fgjg70/FPGA/fpga_pg2l100h/vision/SERVOS.md

# 七路舵机 PWM 与分拣接口

当前活动工程为 `build/dual_caps_sorter128_j11/pg2l100h_vision.pds`，LCD接J11，舵机信号使用J12。瓶盖模式中1号每5秒下料，2号绿色、3号黄色、4号红色，5～7号不自动启用。自动流程及摄像头启用条件见 [CAP_SORTING.md](CAP_SORTING.md)。下表中的球号按用户指定分配；J12脚号来自工程原有底板接线表。

| 舵机编号 | 用途 | FPGA球号 | 板上接线 | 顶层端口 | 脉宽寄存器 |
|---|---|---|---|---|---|
| 1 | 入口放行 | A20 | J12-12 | servo_pwm[0] | 0xA10000E0 |
| 2 | 绿色瓶盖舱门 | C19 | J12-10 | servo_pwm[1] | 0xA10000E4 |
| 3 | 黄色瓶盖舱门 | C18 | J12-8 | servo_pwm[2] | 0xA10000E8 |
| 4 | 红色瓶盖舱门 | A19 | J12-6 | servo_pwm[3] | 0xA10000EC |
| 5 | 盒子口分流 | D19 | J12-9 | servo_pwm[4] | 0xA10000F0 |
| 6 | 盒子口分流 | D18 | J12-7 | servo_pwm[5] | 0xA10000F4 |
| 7 | 盒子口分流 | B19 | J12-5 | servo_pwm[6] | 0xA10000F8 |

J12这些脚只接舵机SIG信号，FPGA输出LVCMOS33。舵机使用符合其型号额定电压的独立电源，电源容量按七个舵机的实际电流选择；电源负极、七个舵机GND和FPGA板GND共地。不得用GPIO或板端3.3 V给舵机供电。还需核对舵机信号输入能否接受3.3 V逻辑。

## 输出行为

`vision_servo_pwm.v`在50 MHz外设时钟下每50个周期产生一次微秒计时使能，不另生成时钟。七路共享20,000 μs周期，即50 Hz；每路独立设置1,000～2,000 μs高电平，分辨率1 μs。该范围作为当前校准起点，不代表已确定舵机机械角度；不同型号、安装方向和连杆机构的伸出/收回值需要实测。

复位后全部输出低，七路预设脉宽均为1,500 μs。写脉宽和开启通道在下一次20 ms周期开始时生效，当前脉冲保持原宽度。关闭通道立即在外设写入时拉低；同一周期重新开启也要等下一周期，避免产生第二段脉冲。PWM电平由寄存器驱动。切换识别模式、相机重配或停用NPU不会自动关闭已启用的PWM。

停止PWM只会停止发送控制信号，不能当作舵机已收回或入口已关闭。需要保持关闭位置时，应持续发送该舵机实测的关闭脉宽。

## 串口校准

使用现有115200、8N1串口，每条舵机命令以回车或换行结束：

| 命令示例 | 作用 |
|---|---|
| `s1=1500` | 设置1号为1,500 μs并启用 |
| `s2=1000` | 设置2号为1,000 μs并启用 |
| `s7=2000` | 设置7号为2,000 μs并启用 |
| `s2=0` | 关闭2号PWM |
| `s0=0` | 关闭全部七路PWM |
| `?` | 原状态输出增加PWM启用位图，十六进制显示，bit0～6对应1～7号 |

成功返回 `SERVO OK`，语法错误、编号越界或非零脉宽不在1,000～2,000范围时返回 `SERVO ERROR` 并保持原设置。命令中的数字不会作为手势期望数字处理。UART增加32字节接收队列；逐条发送并等待确认，避免在输入快照导出期间发送长串命令。

先使机构空载，逐个记录每路的入口关闭/放行或挡板收回/伸出脉宽，再连接实际分拣流程。1,500 μs只是预设值，不能直接作为所有机构的关闭位置。

## CPU寄存器

基址为0xA1000000，只接受32位对齐的完整四字节写，使用95 MHz CPU到50 MHz外设握手。

| 偏移 | 读写 | 内容 |
|---|---|---|
| D0 | R/W | 请求启用位图，低7位有效；bit0对应1号，bit6对应7号 |
| D4 | R | 固定周期20,000，单位μs |
| D8 | R | 当前周期的启用位图，可确认新开启是否已在周期边界生效 |
| E0、E4、E8、EC、F0、F4、F8 | R/W | 1～7号请求脉宽，单位μs；硬件将越界写入夹紧到1,000～2,000 |

设置时先写脉宽，再设置D0对应位。取消D0某一位可单独关闭；写D0=0关闭全部。七路同相输出；自动下料、开门和保持时间由 `firmware/sorter.h` 与主循环调度。

## 历史分拣流程待校准参数

早期版本仅实现PWM输出、CPU控制和串口调试；2026-11-04 已加入瓶盖定时下料，当前流程见 [CAP_SORTING.md](CAP_SORTING.md)。下列机械参数仍需要实测校准：

- 1～4号的实际机械动作方向、下料位置和舱门开合位置。
- 七个舵机的具体型号、各自两个动作位置的脉宽和动作完成时间。
- 履带速度、入口到各分流口的距离，或可提供到位事件的传感器。
- 单件放行的保持时间、物品间距及是否允许多件同时在履带上。

识别输出快照检测结果，没有物品到达传感器。当前自动流程按每次下料周期锁存颜色；下料后丢弃旧帧，下一周期重新确认，因此连续同色瓶盖也能分拣。舱门保持时间仍需按履带速度和距离校准。

## 验证命令

在工程根目录使用已有Python环境执行：

```powershell
python fpga_pg2l100h/vision/build.py --prepare-only
python fpga_pg2l100h/vision/verify.py --pds-home E:/pango/PDS_2022.2-SP6.1 --test verilog --test servo_pwm --test servo_mmio --test servo_command --test overlay --test cpu_mmio
```

仿真检查七路实际脉宽、20 ms周期、周期边界写入、运行中改宽度、关闭后重开、复位、MMIO地址隔离和UART队列。板上仍须用示波器或逻辑分析仪核对七个管脚，并逐路校准机械位置；生成工程或通过仿真均不代表已完成实板舵机测试。

## 2026-11-03 验证记录与整板时序限制

七路PWM、MMIO和UART队列、串口命令解析、原四框显示提交、125 MHz CPU外设访问及Verilog-2005编译共六项回归通过。PWM回归还检查了启用寄存器写入与脉冲下降沿重合的情况，确认写入不会延长其他通道的脉冲。

构建期间工作区CPU和构建脚本有并行改动，因此完整PDS验证使用了 `build/servo_review_20261103/` 下的源码快照。快照根目录的 `SOURCE_SNAPSHOT.json` 记录文件哈希；其中 `fpga_pg2l100h/vision/` 为独立工程，完整构建报告在该工程的 `build/j11/build_summary.json`，时序汇总在 `build/j11/place_route/top_pg2l100h_vision_timing_summary_after_hold_fix.txt`。

本次PDS完成综合、布局布线及位流生成，但整板时序未通过：50 MHz外设域建立时间WNS为+7.116 ns；125 MHz CPU域WNS为-0.551 ns、98个端点违例。详细报告中可见CPU数据存储器经LSU旁路、ALU到EX/MEM寄存器的违例路径，记录到-0.610 ns。该结果不满足当前125 MHz整板约束，构建脚本将本次完整构建标记为失败。

活动工程 `build/j11/` 已重新准备为修正后的PWM源码。其目录中可能保留先前位流，不能将旧位流当成本次PWM版本；本次尚无通过整板时序验收的可用位流，未下载板卡。应先完成CPU时序收敛，再重新构建并逐路校准实物舵机。

## 同日后续：CPU时序已收敛

后续CPU/NPU优化保留了上述七路PWM、MMIO和串口功能。CPU负载读数改为按访问宽度直接对齐，逻辑和算术右移共享移位器后，23:03完成的新整板构建已通过详细时序检查：125 MHz CPU域WNS为+0.302 ns，50 MHz域为+7.072 ns。当前源码的完整20项回归通过，包含此前六项舵机相关回归；最新位流与源码对应关系见 `build/j11/build_summary.json`，此前失败快照仍作为历史记录保留。工具时序通过不代表实物舵机脉宽、接线和机械位置已经验收。
