fgjg70/FPGA/fpga_pg2l100h/vision/build/dual_caps_sorter128_j11/multiseed_summary.csv

version,2022.2-SP6.1<build 138931>
project name,pg2l100h_vision.pds
Single Seed:
Seed,State,Convergence,Setup(Slow),Setup(Fast),Hold(Slow),Hold(Fast),Recovery(Slow),Recovery(Fast),Removal(Slow),Removal(Fast),PBM-GP,PBM-PreGP,PBM-PostGP,LP,Total Placement Cpu Time,Detailed routing,Total Routing Cpu Time,Wire Length After Post-GP,Wire Length After LP,Wire Length After DP,Routing Arc Length,Worst Slack After GP Timing,Worst Slack After LP Timing,Worst Slack Before RP,Worst Slack Before DP,Worst Slack After DP,Worst Slack After Placement,Worst Slack After TA By Preroute,TNS After DP,TNS Before Route,Setup(Slow) Total Failing TNS,Setup(Slow) Total Failing Endpoints,Hold(Slow) Total Failing THS,Hold(Slow) Total Failing Endpoints,Power
single,OK,OK,0.288,3.961,0.158,0.117,5.879,7.634,0.683,0.481,NA,NA,NA,5.52,248.19,669.16,897.03,NA,NA,NA,561789,NA,NA,-1116,-626,1052,1056,NA,0,0,0.000,0,0.000,0,1.522
Pass Rate/Convergence Rate,100.00%,100.00%
Synthesize:
control_set,299
Synthesize Performance Summary:
slack category,Synthesize Setup WNS,Synthesize Setup TNS,Synthesize Recovery WNS,Synthesize Recovery TNS
slack value,0.836,0.000,8.670,0.000
Synthesize Process Cpu Time,0h:5m:1s
Device Map:
Device Map Resource Usage Summary:
Logic Utilization,LUT,FF,DRM,APM,Distributed RAM,HSSTHP,USCM,HCKB,RCKB
Used,24271,19876,113.5,186,516,NA,3,0,0
Available,66600,133200,155,240,19900,NA,32,96,24
Utilization(%),37%,15%,74%,78%,3%,NA,10%,0%,0%
Device Map Process Cpu Time,0h:1m:3s
Project Configurations:
top module,top_pg2l100h_vision
compile," -compiler_directives {SYNTHESIS} "
synthesize," -ads "
device map,
place & route,
Test Parameters Configurations:
testparam,
