fgjg70/FPGA/fpga_pg2l100h/vision/build/dual_caps_sorter128_j11/wiring.csv

port | direction | ball | voltage | board_connector | board_pin | board_net | peripheral | peripheral_pin | signal
sys_clk | INPUT | R3 | 1.5 | CORE | 50MHz | SYS_CLK | BOARD |  | 50MHz oscillator
reset_n | INPUT | G25 | 3.3 | SW2 |  | RESET | BOARD |  | Reset active low
keys_n[0] | INPUT | K25 | 3.3 | SW4 |  | KEY1 | BOARD |  | KEY1 active low
keys_n[1] | INPUT | K26 | 3.3 | SW5 |  | KEY2 | BOARD |  | KEY2 active low
keys_n[2] | INPUT | P26 | 3.3 | SW6 |  | KEY3 | BOARD |  | KEY3 active low
keys_n[3] | INPUT | R26 | 3.3 | SW7 |  | KEY4 | BOARD |  | KEY4 active low
led[0] | OUTPUT | N23 | 3.3 | LED2 |  | LED1 | BOARD |  | LED1 active high
led[1] | OUTPUT | N24 | 3.3 | LED3 |  | LED2 | BOARD |  | LED2 active high
led[2] | OUTPUT | U26 | 3.3 | LED4 |  | LED3 | BOARD |  | LED3 active high
led[3] | OUTPUT | U25 | 3.3 | LED5 |  | LED4 | BOARD |  | LED4 active high
uart_txd | OUTPUT | L24 | 3.3 | J9 | 3-4 | UART_TX | BOARD |  | FPGA TX to CH340 RXD
uart_rxd | INPUT | L25 | 3.3 | J9 | 1-2 | UART_RX | BOARD |  | CH340 TXD to FPGA RX
lcd_r[0] | OUTPUT | AC26 | 3.3 | J11 | 3 | LCD_R0 | AN430 J3 | 3 | LCD_R0
lcd_r[1] | OUTPUT | AB26 | 3.3 | J11 | 4 | LCD_R1 | AN430 J3 | 4 | LCD_R1
lcd_r[2] | OUTPUT | Y26 | 3.3 | J11 | 5 | LCD_R2 | AN430 J3 | 5 | LCD_R2
lcd_r[3] | OUTPUT | W25 | 3.3 | J11 | 6 | LCD_R3 | AN430 J3 | 6 | LCD_R3
lcd_r[4] | OUTPUT | W23 | 3.3 | J11 | 7 | LCD_R4 | AN430 J3 | 7 | LCD_R4
lcd_r[5] | OUTPUT | V23 | 3.3 | J11 | 8 | LCD_R5 | AN430 J3 | 8 | LCD_R5
lcd_r[6] | OUTPUT | W26 | 3.3 | J11 | 9 | LCD_R6 | AN430 J3 | 9 | LCD_R6
lcd_r[7] | OUTPUT | V26 | 3.3 | J11 | 10 | LCD_R7 | AN430 J3 | 10 | LCD_R7
lcd_g[0] | OUTPUT | AC24 | 3.3 | J11 | 11 | LCD_G0 | AN430 J3 | 11 | LCD_G0
lcd_g[1] | OUTPUT | AB24 | 3.3 | J11 | 12 | LCD_G1 | AN430 J3 | 12 | LCD_G1
lcd_g[2] | OUTPUT | Y21 | 3.3 | J11 | 13 | LCD_G2 | AN430 J3 | 13 | LCD_G2
lcd_g[3] | OUTPUT | W21 | 3.3 | J11 | 14 | LCD_G3 | AN430 J3 | 14 | LCD_G3
lcd_g[4] | OUTPUT | T15 | 3.3 | J11 | 15 | LCD_G4 | AN430 J3 | 15 | LCD_G4
lcd_g[5] | OUTPUT | T14 | 3.3 | J11 | 16 | LCD_G5 | AN430 J3 | 16 | LCD_G5
lcd_g[6] | OUTPUT | Y20 | 3.3 | J11 | 17 | LCD_G6 | AN430 J3 | 17 | LCD_G6
lcd_g[7] | OUTPUT | W20 | 3.3 | J11 | 18 | LCD_G7 | AN430 J3 | 18 | LCD_G7
lcd_b[0] | OUTPUT | AB25 | 3.3 | J11 | 19 | LCD_B0 | AN430 J3 | 19 | LCD_B0
lcd_b[1] | OUTPUT | AA24 | 3.3 | J11 | 20 | LCD_B1 | AN430 J3 | 20 | LCD_B1
lcd_b[2] | OUTPUT | AA23 | 3.3 | J11 | 21 | LCD_B2 | AN430 J3 | 21 | LCD_B2
lcd_b[3] | OUTPUT | AA22 | 3.3 | J11 | 22 | LCD_B3 | AN430 J3 | 22 | LCD_B3
lcd_b[4] | OUTPUT | W19 | 3.3 | J11 | 23 | LCD_B4 | AN430 J3 | 23 | LCD_B4
lcd_b[5] | OUTPUT | V19 | 3.3 | J11 | 24 | LCD_B5 | AN430 J3 | 24 | LCD_B5
lcd_b[6] | OUTPUT | U16 | 3.3 | J11 | 25 | LCD_B6 | AN430 J3 | 25 | LCD_B6
lcd_b[7] | OUTPUT | U15 | 3.3 | J11 | 26 | LCD_B7 | AN430 J3 | 26 | LCD_B7
lcd_dclk | OUTPUT | V14 | 3.3 | J11 | 27 | LCD_DCLK | AN430 J3 | 27 | LCD_DCLK
lcd_hsync | OUTPUT | U14 | 3.3 | J11 | 28 | LCD_HSYNC | AN430 J3 | 28 | LCD_HSYNC
lcd_vsync | OUTPUT | U22 | 3.3 | J11 | 29 | LCD_VSYNC | AN430 J3 | 29 | LCD_VSYNC
lcd_de | OUTPUT | V22 | 3.3 | J11 | 30 | LCD_DE | AN430 J3 | 30 | LCD_DE
touch_sclk | OUTPUT | W24 | 3.3 | J11 | 31 | SPI_DCLK | AN430 J3 | 31 | SPI_DCLK
touch_cs_n | OUTPUT | V24 | 3.3 | J11 | 32 | SPI_CS | AN430 J3 | 32 | SPI_CS
touch_mosi | OUTPUT | N18 | 3.3 | J11 | 33 | SPI_DIN | AN430 J3 | 33 | SPI_DIN
touch_busy | INPUT | U24 | 3.3 | J11 | 34 | SPI_BUSY | AN430 J3 | 34 | SPI_BUSY
cam_scl | OUTPUT | W18 | 3.3 | J7 | 3 | CMOS_VSYNC | OV7670 DVP18 | 3 | SCL
cam_sda | INOUT | Y23 | 3.3 | J7 | 4 | CMOS_SCL | OV7670 DVP18 | 4 | SDA
cam_vsync | INPUT | V16 | 3.3 | J7 | 5 | CMOS_HREF | OV7670 DVP18 | 5 | VS
cam_href | INPUT | V18 | 3.3 | J7 | 6 | CMOS_SDA | OV7670 DVP18 | 6 | HS
cam_pclk | INPUT | V17 | 3.3 | J7 | 7 | CMOS_RESET | OV7670 DVP18 | 7 | PCLK
cam_xclk | OUTPUT | T17 | 3.3 | J7 | 8 | CMOS_D0 | OV7670 DVP18 | 8 | MCLK
cam_reset_n | OUTPUT | AA25 | 3.3 | J7 | 17 | CMOS_XCLK | OV7670 DVP18 | 17 | RESET
cam_pwdn | OUTPUT | Y25 | 3.3 | J7 | 18 | CMOS_PWDN | OV7670 DVP18 | 18 | PWDN
cam_data[0] | INPUT | Y22 | 3.3 | J7 | 16 | CMOS_PCLK | OV7670 DVP18 | 16 | D0
cam_data[1] | INPUT | U21 | 3.3 | J7 | 15 | CMOS_D7 | OV7670 DVP18 | 15 | D1
cam_data[2] | INPUT | T20 | 3.3 | J7 | 14 | CMOS_D6 | OV7670 DVP18 | 14 | D2
cam_data[3] | INPUT | V21 | 3.3 | J7 | 13 | CMOS_D5 | OV7670 DVP18 | 13 | D3
cam_data[4] | INPUT | U20 | 3.3 | J7 | 12 | CMOS_D4 | OV7670 DVP18 | 12 | D4
cam_data[5] | INPUT | T19 | 3.3 | J7 | 11 | CMOS_D3 | OV7670 DVP18 | 11 | D5
cam_data[6] | INPUT | T18 | 3.3 | J7 | 10 | CMOS_D2 | OV7670 DVP18 | 10 | D6
cam_data[7] | INPUT | U19 | 3.3 | J7 | 9 | CMOS_D1 | OV7670 DVP18 | 9 | D7
servo_pwm[0] | OUTPUT | A20 | 3.3 | J12 | 12 | LCD_G1 | SERVO 1 | SIG | Entrance gate
servo_pwm[1] | OUTPUT | C19 | 3.3 | J12 | 10 | LCD_R7 | SERVO 2 | SIG | Box diverter
servo_pwm[2] | OUTPUT | C18 | 3.3 | J12 | 8 | LCD_R5 | SERVO 3 | SIG | Box diverter
servo_pwm[3] | OUTPUT | A19 | 3.3 | J12 | 6 | LCD_R3 | SERVO 4 | SIG | Box diverter
servo_pwm[4] | OUTPUT | D19 | 3.3 | J12 | 9 | LCD_R6 | SERVO 5 | SIG | Box diverter
servo_pwm[5] | OUTPUT | D18 | 3.3 | J12 | 7 | LCD_R4 | SERVO 6 | SIG | Box diverter
servo_pwm[6] | OUTPUT | B19 | 3.3 | J12 | 5 | LCD_R2 | SERVO 7 | SIG | Box diverter
