fgjg70/FPGA/fpga_pg2l100h/vision/build/dual_caps_sorter128_j11/place_route/top_pg2l100h_vision_timing_summary_after_hold_fix.txt

Design Summary : All Constraints Met.

Setup Summary(Slow Corner):
****************************************************************************************************
                                                                          TNS Failing      TNS Total
 Launch Clock           Capture Clock              WNS(ns)     TNS(ns)      Endpoints      Endpoints
----------------------------------------------------------------------------------------------------
 clk50                  clk50                        4.781       0.000              0          76427
 cpu95                  clk50                       17.924       0.000              0             68
 clk27                  clk27                       16.136       0.000              0           2592
 clk50                  clk27                       17.732       0.000              0            377
 clk27                  lcd_pixel                   20.836       0.000              0             27
 cpu95                  cpu95                        0.393       0.000              0          14450
 clk50                  cpu95                        9.096       0.000              0             32
====================================================================================================

Hold Summary(Slow Corner):
****************************************************************************************************
                                                                          THS Failing      THS Total
 Launch Clock           Capture Clock              WHS(ns)     THS(ns)      Endpoints      Endpoints
----------------------------------------------------------------------------------------------------
 clk50                  clk50                        0.159       0.000              0          76427
 clk27                  clk27                        0.252       0.000              0           2592
 clk27                  lcd_pixel                    1.286       0.000              0             27
 cpu95                  cpu95                        0.308       0.000              0          14450
====================================================================================================

Recovery Summary(Slow Corner):
****************************************************************************************************
                                                                          TNS Failing      TNS Total
 Launch Clock           Capture Clock              WNS(ns)     TNS(ns)      Endpoints      Endpoints
----------------------------------------------------------------------------------------------------
 clk50                  clk50                       14.965       0.000              0            104
 cpu95                  cpu95                        5.923       0.000              0           1506
====================================================================================================

Removal Summary(Slow Corner):
****************************************************************************************************
                                                                          THS Failing      THS Total
 Launch Clock           Capture Clock              WHS(ns)     THS(ns)      Endpoints      Endpoints
----------------------------------------------------------------------------------------------------
 clk50                  clk50                        1.207       0.000              0            104
 cpu95                  cpu95                        0.679       0.000              0           1506
====================================================================================================

Minimum Pulse Width Summary(Slow Corner):
****************************************************************************************************
                                                                         WPWS Failing     WPWS Total
 Clock                                            WPWS(ns)    TPWS(ns)      Endpoints      Endpoints
----------------------------------------------------------------------------------------------------
====================================================================================================

Setup Summary(Fast Corner):
****************************************************************************************************
                                                                          TNS Failing      TNS Total
 Launch Clock           Capture Clock              WNS(ns)     TNS(ns)      Endpoints      Endpoints
----------------------------------------------------------------------------------------------------
 clk50                  clk50                        9.978       0.000              0          76427
 cpu95                  clk50                       18.808       0.000              0             68
 clk27                  clk27                       17.070       0.000              0           2592
 clk50                  clk27                       18.580       0.000              0            377
 clk27                  lcd_pixel                   23.432       0.000              0             27
 cpu95                  cpu95                        3.969       0.000              0          14450
 clk50                  cpu95                        9.705       0.000              0             32
====================================================================================================

Hold Summary(Fast Corner):
****************************************************************************************************
                                                                          THS Failing      THS Total
 Launch Clock           Capture Clock              WHS(ns)     THS(ns)      Endpoints      Endpoints
----------------------------------------------------------------------------------------------------
 clk50                  clk50                        0.116       0.000              0          76427
 clk27                  clk27                        0.167       0.000              0           2592
 clk27                  lcd_pixel                    1.940       0.000              0             27
 cpu95                  cpu95                        0.218       0.000              0          14450
====================================================================================================

Recovery Summary(Fast Corner):
****************************************************************************************************
                                                                          TNS Failing      TNS Total
 Launch Clock           Capture Clock              WNS(ns)     TNS(ns)      Endpoints      Endpoints
----------------------------------------------------------------------------------------------------
 clk50                  clk50                       16.827       0.000              0            104
 cpu95                  cpu95                        7.642       0.000              0           1506
====================================================================================================

Removal Summary(Fast Corner):
****************************************************************************************************
                                                                          THS Failing      THS Total
 Launch Clock           Capture Clock              WHS(ns)     THS(ns)      Endpoints      Endpoints
----------------------------------------------------------------------------------------------------
 clk50                  clk50                        0.852       0.000              0            104
 cpu95                  cpu95                        0.481       0.000              0           1506
====================================================================================================

Minimum Pulse Width Summary(Fast Corner):
****************************************************************************************************
                                                                         WPWS Failing     WPWS Total
 Clock                                            WPWS(ns)    TPWS(ns)      Endpoints      Endpoints
----------------------------------------------------------------------------------------------------
====================================================================================================
