fgjg70/FPGA/(commit log)

2026-09-26 feat: RV32I 五级流水线处理器核心
    从 legacy/ 下的 Verilog 单周期实现重写为 SystemVerilog 五级流水线
    (IF/ID/EX/MEM/WB)，含冒险处理与非对齐访存硬件自动拆分。
    194 项单元检查 + 6 组系统级测试全部通过 (sim/run.bat)。
    基础模块:
    rv32_pkg.sv 编码包(单一事实来源): 指令/ALU/分支/访存编码、控制束、
    地址映射、前递枚举、数据通路契约
    alu / branch_unit / control_unit / imm_gen / pc / regfile
    流水线模块:
    if_id_reg / id_ex_reg / ex_mem_reg / mem_wb_reg 控制束整束传递
    hazard_unit 前递选择 + load-use 停顿 + 重定向门控
    load_store_unit 字节通道 + 非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
2026-10-05 feat: RV32IM 五级流水线 CPU — 分支预测 / M 扩展 / BRAM + 上板跑分基础设施
    微架构 (三项评分指标逐轮量化, 见 results/coremark.csv):
    - 分支预测: 64 项 BTB + 2 位 Smith 方向预测器, IF 预测 / EX 校验。
    redirect 语义重定义为"预测错误"(而非"分支 taken"); 精度 89%, 条件分支误判率 8.6%
    - RV32M: muldiv.sv。乘法乘积寄存进 DSP(MREG/PREG) 换回 fmax (74.6MHz, 只让 2.2% CoreMark);
    除法 32 步恢复余数, busy 必须覆盖启动拍与单周期除零/溢出特例
    - BRAM: dmem 改寄存读, 字节提取挪到 WB 拍吸收延迟 (零性能损失),
    纯行为级推断不例化任何厂商 IP; LUT 4494 -> 2481 (-45%), C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
    [coremark.csv]
2026-10-05 feat: 上板 CoreMark 实测通过 + 异常/中断基础 (CSR)
    上板验证 (赛题硬性要求, 见 results/hw-verified.md):
    - 达芬奇Pro XC7A100T-2 @50MHz, CoreMark v1.0 x 1200 迭代 = 10.16 秒 (>= 10s)
    - CRC 判定位 = 1: crclist/crcmatrix/crcstate 全部匹配官方参考值
    - CoreMark/MHz 硬件实测 2.3615 vs 仿真 2.3611 (吻合 0.02%)
    - 流水线效率波形已抓: 2048 拍窗口 stall 8.8% / redirect 1.07% (分析报告用)
    异常/中断 (赛题高阶任务):
    - csr_file.sv: M-mode 全套 CSR + 进陷阱/MRET 状态机。
    mepc 取 trap_pc 本身不 +4 —— 异常与中断都在 EX 段、指令提交前裁决,
    被抢占的指令必须重新执行, 两种情况语义统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
    [coremark.csv, ila_done.csv, ila_pipeline.csv]
2026-10-05 docs: 新增 HANDOFF.md 交接文档 (供全新会话接手)
    内容: 项目定位 / 当前实测成果 / 环境事实 (环境剥离+纯ASCII规则) / 代码结构 /
    已完成工作 / 待办 P0-P6 (含异常中断 core 接线的完整设计) / 命令配方 /
    高频坑清单 / 关键设计决策与理由 / 文档索引 / 建议接手顺序 / 迭代轨迹
2026-10-05 docs: 新增 HANDOFF-HW-LOOP.md — 上板闭环测试能力说明
    HANDOFF.md 的 P4 把上板复验写成了「待用户操作」, 但硬件闭环其实完全自动化:
    JTAG 烧录 + ILA 读回, 不需要人看 LED, 也不需要串口。
    内容: 三条通道可用性 / 一条命令跑完 / ILA 版必须与 RTL 同步 /
    完整闭环工作流 / 给新测试加闭环的三步模式 / 上板踩的 7 个坑 / 当前硬件真实状态
    另记录了 results/coremark.csv 里 LUT=2481 与当前 3923 的差异原因:
    CSR 接线给 ctrl_s 加了 5 个字段, 控制束变宽; 旧行是当时代码的实测值, 不该改。
2026-10-05 docs: 新增 HANDOFF-WORKFLOW.md — 优化循环说明 + 集成建议
    写给接手 AI: 说明我 10 轮迭代实际用的优化循环, 并建议如何固化成 skill/子命令。
    内容:
    - 循环形状: 选靶子->量现状->改一处->仿真->重综合->判定->沉淀
    - 各步真实命令 (含剖析用的层次化引用计数器)
    - 判定环节: 三项指标 + 绝对吞吐, 附三项互相冲突的真实案例表
    - 判据清单: 每环节的通过标准与可疑信号 (完全一致 = 先怀疑没生效)
    - 建议新增三个子命令: metrics / profile / hw --stale|--capture|--rebuild
    - 建议新增动作型 skill: 一个优化回合的 9 步 + 5 条硬规则
    - 可复用模式 7 条; 补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
2026-10-05 feat: 工具化工作流 + P0 评分版重建 + P1 异常/中断接入 core
    工具层 (tools/fpga_workflow.py, 见 tools/README.md):
    - check: R1 漂移检测 —— 三处 RTL 清单同步 / 未接线模块 / 镜像新鲜度 /
    bitstream 新鲜度 / tohost 地址 / .bat·.tcl 纯 ASCII
    - verify: ModelSim 增量回归, 内容哈希缓存; 判定依据是 tb 打印的
    "RESULT : PASS" 而非 vsim 退出码 (quit -f 无论成败都返回 0)
    - synth: Vivado 综合 -> 四项指标; 全局构建锁串行化 + 报告归档
    - report: 三项指标 + 绝对吞吐
    P0 评分版重建 (fpga/build.tcl):
    - 补 DMEM_INIT_FILE (哈佛结构缺它会静默让 .data/.rodata 全 0)
    - 程序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
    [coremark.csv]
2026-10-05 perf: P3 fmax 还债 实验A — 跳转目标专用加法器 (61.4 -> 64.4 MHz)
    改动 (core.sv):
    - 把 BR/JAL/JALR 的跳转目标从"穿 ALU 操作数 mux"改成独立加法器
    原写法取 alu 的 ex_sum, 已绕过结果 mux, 但 ex_a 的 3:1 与 ex_b 的 2:1
    操作数 mux 仍在路径上。BR/JAL/JALR 的 alu_op 恒为 ADD、操作数确定
    (pc+imm 或 rs1+imm), 因此给它们只有 1 级 mux 的专用加法器, 零周期代价。
    实测 (synth --prog cm_hw --tag p3a-jalr-addder):
    CoreMark/MHz 2.3614 -> 2.3614 (ticks 完全相同 423,486, 确认零周期代价)
    fmax 61.4 -> 64.4 MHz (+4.9%)
    CoreMark/LUTs 6.019e-4 -> 5.986e-4 (-0.6%)
    绝对吞吐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
    [coremark.csv]
2026-10-05 docs: 修正 gap-analysis 过时标注 + HANDOFF 记录 P3 进展与盈亏平衡账
    gap-analysis.md 是赛题对照表, 原先有多处自相矛盾:
    - 「完整异常/中断」仍标为 ❌ 完全缺失 -> 改为 ✅ 已完成 (P1 已接入 core, 7 PASS)
    - 「运行 >=10 秒」标为待确认 -> 已上板实测 10.16 s
    - 评分三项数字更新为 report 重算的可复现口径 (fmax 64.4 / LUT 3945)
    - 补充: 异常/中断只差 P2 定时器中断 (irq_timer 仍硬接 1'b0, csr_file 侧已就绪)
    - 优先级表重排, 附工作流命令清单
    HANDOFF.md:
    - P3 标记为「进行中, 实验A 已挣回 +4.9%, 本轮暂停」并写入盈亏平衡账
    (load-use 时间代价 6.14% -> 方案1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
2026-10-05 perf: P3 实验B — 取指存储器改寄存读进 BRAM (LUT 3945 -> 2656, -32.7%)
    起因: imem 原来既不是 BRAM 也不是 LUTRAM, 而是被综合成 1228 个纯 LUT 的
    组合 ROM (占全核 3945 LUT 的 31%)。普通 report_utilization 看不出来 ——
    imem 在 Block RAM 表与 Distributed RAM 表里都不出现, 必须按层次看。
    改动:
    - imem.sv: 加 clk 端口 + IMEM_REG_READ 宏 (定义=寄存读/可进 BRAM, 不定义=组合读)
    - core.sv: u_imem 接上 .clk
    - fpga/build.tcl: 默认定义 IMEM_REG_READ=1; set IMEM_COMB_READ=1 可回退
    - tools: synth/verify 增加 --imem-comb-read 回退开关; 新增 tools/hier_util.tcl
    实测 (vs 实验A 3945/64.4):
    CoreMark/MHz 2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
    [coremark.csv]
2026-10-05 perf: P3 实验C — load 结果改由 MEM/WB 寄存器给出 (fmax 65.3 -> 75.0, +14.8%)
    靶子: 实验B 之后关键路径为
    u_dmem/mem_reg_2/CLKBWRCLK -> u_id_ex/rs2_data_reg[2]/D, 15.216ns, route 63.9%
    根因 (core.sv):
    mem_wb_reg 的 load_data_in 原本硬接 32'h0, load 结果直接从 LSU 的
    **组合输出**进 wb_data mux -> 前递 mux -> ID/EX —— 同一时钟沿上"组合读出的
    数据"既要被 MEM/WB 锁存、又要穿过 mux 去前递/写回, 两跳压在一拍。
    改动 (不新增任何寄存器, 用的就是本来就存在的 mem_wb_reg):
    - `ifdef LOAD_RESULT_REG: .load_data_in(mem_load_data);
    WB_MEM: wb_data = mem_wb_load_data; // 从前递寄存器取,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
    [coremark.csv]
2026-10-05 fix(tools): metrics 改用仿真日志的 ticks 真值, 而非 CSV 历史值
    实测发现口径不一致: CSV 记录 ticks=423,486, 而干净的仿真日志是 423,527。
    两者 CoreMark/MHz 差 0.01% (2.3614 vs 2.3611), 看似无所谓, 但'用旧值算新架
    的指标'是错的口径 —— 改 RTL 后 ticks 可能已变, 或本就该重测。
    - latest_ticks(): 优先读 .fpga-cache/logs/tb_sw_coremark.log 里的 CoreMark
    ticks (还能顺带拿到 CRC 做正确性校验), 没有才回退 CSV
    - report: 表内数据仍为 CSV 记录值 (那一次构建的实测), 但补一行提示说明
    它不等于'此刻'的指标, 要看此刻请用 metrics
    实测: metrics 现在给出 coremark_per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
2026-10-05 feat(P2): 定时器中断 (mtime/mtimecmp -> mip.MTIP) —— 补齐"完整异常/中断"
    - fpga/mmio_subsys.sv: 64 位 mtimecmp (复位全 1, 上电不立刻中断); mtime 复用
    已有周期计数器 (保证 MMIO_MTIME_* 与 MMIO_CYCLE_* 读数一致);
    irq_timer = (mtime >= mtimecmp) 电平输出
    - core.sv: 新增 irq_timer 端口 -> csr_file.irq_timer, 不再硬接 1'b0
    - top_a100t.sv / tb_soc.sv / tb_sw.sv 接线 (tb_core 保持恒 0: 它不接外设)
    - 新测试 sim/prog/timer_irq.S + 测试矩阵 tb_soc_timer_irq, 覆盖: 中断触发 /
    mcause 判定 / handler 推进 mtimecmp 清电平 / mret 返回 / handler 用 mscratch
    保存恢复现场 / 中断之后 UART+GPIO 仍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
    [coremark.csv]
2026-10-05 docs: gap-analysis 同步 P2 完成状态 ('完整异常/中断'已无缺口) + 实测数字
    - 「完整异常/中断」补上 P2 定时器中断, 移除'只差定时器中断'的待办说明
    - 评分三项与资源更新为 p2-timer-irq 的可复现口径 (LUT 2526 / fmax 70.9)
    - fmax 还债全程表 (61.4 -> 75.0 -> 70.9), 标明 P2 是'用频率换功能'
    - 优先级重排: 上板复跑成唯一阻塞项; 新增按层次查资源的工具用法
    - 回归基线 7 PASS -> 8 PASS
2026-10-05 feat: 上板闭环验证通过 (含 P1+P2+P3) + hw 子命令 + 修两个 ILA 抓取坑
    ## 上板验证结果 (2026-10-05 16:43, 真实板卡)
    ila_ctrl = 0x42 -> done=1 pass=1 fail=0 illegal=0
    score_result = 0x9E49D60C
    bit31 = 1 -> CRC 全部匹配 CoreMark 官方参考值
    tick = 508,155,404 (预期 508,232,400, 偏差 0.015%)
    时长 = 10.16 s (赛题 >=10s 满足)
    CoreMark/MHz = 2.3615 (仿真 2.3611, 吻合 0.02%)
    **tick 与 P1 之前逐位相同** —— P1/P2/P3 都不改变指令数与周期数 (P3 是纯时序优化,
    P1/P2 的陷阱逻辑不在热路径), 硬件上逐位复现, 证明仿真与硬件在三次结构性改动后仍一致。
    流水线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
    [coremark.csv, ila_pipeline.csv]
2026-10-05 docs: gap-analysis 标记上板闭环已完成 (含 P1+P2+P3 的 bitstream 已验证)
2026-10-05 fix(tools): hw --record 的 notes 写对 (原为 PROG=?); 修正 HW 行的 notes
    - append_csv 现在优先用调用方给的 note, 没有再退回 synth 的默认文案
    - hw 子命令传入'上板实测 (ILA over JTAG): N 迭代, X.XXs, CRC 判定=D'
    - 修正 results/coremark.csv 里 HW-P2P3-verified 那行的 notes
    [coremark.csv]
2026-10-05 fix(csv): 从 git 恢复被 BOM 破坏的 coremark.csv, 改用 csv 模块重写
    事故链 (两步都踩了):
    1. 用 PowerShell `Set-Content -Encoding UTF8` 改 coremark.csv 里一行 notes ——
    PowerShell 5.x 的 `-Encoding UTF8` **会写入 BOM**, 于是首列列名变成
    "\ufeffdate", 所有按列名索引的解析全部失配 -> report 里数字全变成 "-",
    而文件"看起来是正常的"。
    2. 又用 split("\n") 处理 CRLF 文件重写, 首个注释行与下一行被粘在一起,
    并多出杂引号。
    修法: 从 git 恢复完好版本, 只改 HW 那一行的 notes, 且改用 csv 模块读写
    (不再手拼逗号、不再手工切行)。
    复核: 12 列 / 20 数据行 /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
    [coremark.csv]
2026-10-05 docs: 新增分析报告 (results/analysis-report.md) + 修正 link.ld 顶部与实现不符的注释
    analysis-report.md 覆盖赛题要求的分析报告维度:
    - 体系结构: 流水线组织/8 项关键设计决策/分支预测/异常中断
    - 验证方法: 8 项回归 + CoreMark CRC 证据 + 上板无人值守闭环
    - 实现与工具链: 规模 (19 文件 2164 行) / 关键路径分析 (route 占 73.3%) / 哈佛双镜像约束
    - 优化过程: 逐轮指标表 + 三个关键优化原理 + 失败与弯路 (含缩容负收益、stub 实验失效)
    - 上板实测: 跑分结果 + 2048 拍流水线波形分析 + 停顿构成
    - 结论: 已达成/未完成/后续方向 + 附录复现命令
    link.ld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
2026-10-05 chore: 收尾 — 镜像哈希基线自动化 + bitstream 重建 + PITFALLS R14/R15
    ## 排查过程 (结论: 原以为是静默失败, 实测正常)
    发现 cm_hw(ITER=1200)/cm_it3(ITER=3)/cm_rv32im(ITER=1) 三个 imem 镜像
    **逐字节相同**, 一度认为是 "-D ITERATIONS 没生效" 这个经典静默失败。
    实测结论: **是正常的**。CoreMark 把迭代数放在**可写数据变量**里, 所以改
    ITERATIONS **只改数据段** —— 两个构建的 .hex 相同、.dmem.hex 不同。
    并已验证仓库现有 cm_hw.hex + cm_hw.dmem.hex **完全等于**重建的 ITERATIONS=1200。
    排查过程中还踩到一个真坑 (R15): 在 PowerShell 里敲
    -D 'FLAGS_STR="-Os -march=rv32i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
    [coremark.csv]
2026-10-05 fix(tools): 宏从未在仿真生效 —— 重大静默失败, P3 两个"零代价优化"作废
    ## 事故
    `tools/fpga_workflow.py` 的 compile_sim 写的是:
    flags = ["+" + d for d in defines] # -> vlog -sv +IMEM_REG_READ ...
    `vlog` 把 `+FOO` 当未知选项, **宏根本不会被定义, 而编译仍"成功"**。
    最小复现:
    vlog -sv +FOO -> FOO_NOT_DEFINED
    vlog -sv +define+FOO -> FOO_DEFINED
    后果: 综合侧走 Tcl 的 -verilog_define (**生效**), 仿真侧没生效 ->
    **"综合开了宏、仿真没开宏", 两边跑的不是同一份设计**。
    于是 results/p3-imem.md 与 p3-load-result.md 里
    "CoreMark/MHz 逐位不变、零代价"是**无效证据** —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
    [coremark.csv]
2026-10-05 feat(diag): 微架构优化测量 — 误判分类探针 + gshare + 定位 imem 寄存器读错位根因
    ## 诊断设施 (本轮的主要可复用产出)
    tb_sw.sv 新增**分类型预测错误统计**, 并用层次化引用直读 BTB 阵列 (纯观测, 不改 RTL):
    cond branch = 6055 (52%) JAL = 1102 (9%) JALR = 4378 (37%)
    条件分支: BTB 有表项 67457 (96%), 无表项 2678 (3%)
    误判细分: 无表项(容量/冲突) 1185 (19%), **有表项但方向判反 4870 (80%)**
    => **推翻了 btb.sv 自己的注释**("64 项冲突是 8.6% 误判率的主因")。
    96% 的分支在表里, 80% 的误判是方向判错 -> 该改方向预测器, 不是扩表。
    (PITFALLS R16)
    ## gshare 方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
2026-10-05 chore: 重建 bitstream (core.sv 改动后) + 记录真实基线 p4-final-default
    core.sv 的取指相位对齐改动 (IMEM_REG_READ 门控) 在默认组合读模式下是
    `wire pc_if = pc` 的直通, 属零代价; 综合结果验证了这一点:
    LUT 4019 -> 4015, fmax 61.6 -> 61.3MHz (摆位布线噪声级), CM/MHz 不变
    最终状态 (三宏全关 = 上板验证过的配置):
    CoreMark/MHz 2.3611 (ticks 423,527)
    fmax 61.3 MHz
    LUT/FF/BRAM/DSP 4015/1381/4/8
    CoreMark/LUTs 5.881e-04
    绝对吞吐 144.7
    验证:
    check 通过 (0 个必须修)
    verify 8 PASS (默认配置)
    上板 PASS —— ila_ctrl=0x42, CRC 判定=1, tick=508,155,404, 10.16s
    (tic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
    [coremark.csv]
2026-10-05 fix(fetch): 取指对齐自检 + IMEM_REG_READ 彻底定位 (需重排取指流水, 拦在构建期)
    ## 取指对齐自检 (新增, 长期保留)
    tb_sw.sv 增加 [ALIGN] 断言: mem[if_pc] 必须等于 if_instr。把"静默错位"
    这类 bug 变成一行直接报错, 不必再人肉 trace。
    踩了两个坑并写进注释:
    1) 索引位宽要用 imem 真实的 AW 位宽 (16KB -> if_pc[13:2]), 不能随便切
    2) flush 那一拍 if_id 里留的是旧值且 pc 被清成 0, 必须跳过 (用 if_pc!=0 判废)
    3) 启动窗口前 4 拍要跳过 (imem 的 initial 先填 NOP, $readmemh 随后才覆盖)
    实测: 正确配置报 "OK (0 次错位)", 错位配置能抓到。
    ## IMEM_REG_READ 根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
2026-10-05 feat(predict): 返回地址栈 RAS (机制有效, 综合指标净亏 -> 默认关闭)
    ## 选择依据 (先测量再动手)
    把预测错误按类型拆开: cond branch 6055 (52%) / JAL 1102 (9%) / **JALR 4378 (37%)**。
    JALR 绝大多数是函数返回, 而 BTB 只记得住"上一次"的返回地址 -> RAS 的靶子。
    ## 实现
    - ras.sv: 8 项 x 32 位 + 指针, 饱和不回绕 (回绕会让栈顶指向错误地址, 比不预测更糟)
    - btb.sv: 增加 is_ret 标记 + pred_is_ret 输出
    - core.sv: EX 段识别 call(JAL/JALR 且 rd=x1/x5) 与 return(JALR rd=x0 且 rs1=x1/x5),
    只在 EX 更新 (不做投机压栈, 避免冲刷后栈变脏)
    关键设计: **前端 IF 段无法识别返回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
    [coremark.csv]
2026-10-05 docs(predict): gshare 两个变体都实测 —— 都输给纯局部 Smith, 明确 reject
    ## 结论 (results/p4-gshare.md)
    Smith (默认) ticks 423527 误判 11535 精度 89% <- 基准
    gshare 历史记全部控制流 ticks 449317 误判 25954 精度 75% 慢 6%
    gshare 历史只记条件分支 ticks 451265 误判 26547 精度 74% 更差
    两个变体都输。变体 B (只记条件分支) 的动机听起来合理 (JAL/JALR 方向恒为
    taken, 记进历史只注入常量噪声), 但实测精度从 89% 崩到 74% —— 真因是
    **冷却效应**: 6 位历史做 XOR 索引意味着同一分支在不同历史下落到 2^6=64 个
    不同计数器上, 每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
    [coremark.csv]
2026-10-05 docs(handoff): 记录 P4 轮结论 (RAS/gshare/取指错位) + 给 P3 节加作废标记
    - 新增 P4 节: 当前真实状态 (四宏全关, 上板已验证) + 本轮三个'实测否决'结论
    + 留下的可复用设施 (取指对齐自检 / 分类型误判统计 / 宏自证)
    + 下一步按收益排序 (重做取指流水是最大一块)
    - P3 节标题加删除线 + 作废横幅: imem 寄存读与 load 结果寄存器的'零代价'
    是无效证据 (宏在仿真里从未生效), 两者单独开启都会 timeout
    - 原'上板复跑'小节改名 P4-old 作为历史
2026-10-05 fix(fetch): IMEM_REG_READ 四轮尝试后定论 —— 需模块级取指重排, 当前不做
    ## 四轮尝试 (都失败, 但把"为什么补丁补不上"钉死了)
    ① 只延迟进 if_id 的 PC -> [ALIGN] 对齐自检已 0 次错位, 但 tb_core_basic 第2组仍挂
    ② 再延迟预测 (用延迟后的 PC 查表) -> 同上; 预测与指令的 PC 仍差一拍
    ③ 再加 stall 门控 -> 同上
    ④ 让延迟副本照抄 pc 的"下一拍值" -> 需要把 pc.sv 的 flush/stall 优先级复制到
    以同步重定向跳变 第二个寄存器, 等价于把 PC 改成两级结构 = 模块级重构
    trace 证据: 0x80000048 的 "j ." 被解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
    [coremark.csv]
2026-10-05 docs(gap): gap-analysis 同步到修正后的真实指标 + 标注作废项
    - 评分三项改为四宏全关的真实口径 (fmax 61.6 / LUT 4019 / CM-LUTs 5.875e-4 / 吞吐 145.4)
    - fmax 还债表改为'只列有效项': 实验 B/C 标注作废 (功能不正确), 只留实验 A
    - 分析报告标记为已完成 (results/analysis-report.md)
    - 模块数 19 -> 20 (新增 ras.sv)
    - 优先级重排: Cache 是当前最高价值的功能缺口, 取指流水重排排在其后
2026-10-05 feat(app): 应用场景基线 (神经网络 GEMM 核心) + 定位一个编译器代码生成 bug
    ## 应用场景 (赛题"应用场景构建" + "AI 模型性能"两项的落点)
    新增 sw/nn_demo.c: 用 GEMM 搭一个小型神经网络推理核心, 作为"加速前软件基线"。
    选它的理由: (a) GEMM 是神经网络推理里占比绝对主导的算子 (b) 结果可逐元素校验
    (c) 有明确的"软件 vs 加速"对比基准。
    - 16x16 三重矩阵乘, 4096 MAC, 结果与**独立参考实现**逐元素比对
    - 新增测试 tb_sw_nn_demo (回归 8 -> 9 项)
    - 基线实测 (-O0, 结果正确):
    gemm_cycles=196264 macs=4096 cycles_per_mac=47.91
    checksum == checksum_ref == 0x9d5d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
2026-10-05 docs(ai): GEMM 加速单元完整设计方案 + 应用场景基线结论
    results/p5-ai-accelerator.md:
    - 应用场景已落地: sw/nn_demo.c 用 GEMM 搭神经网络推理核心; 基线实测
    gemm_cycles=196264 / macs=4096 / cycles_per_mac=47.91 /
    checksum == checksum_ref == 0x9d5de1c5 (与主机端独立计算一致) / mismatch=0
    - 硬件加速单元设计: 完整 MMIO 寄存器表 + 运算语义 + 正确性验证方式
    - **阻塞点分析**: 本核 dmem 单读口且被 LSU 独占 -> 加速单元直接访存会争用,
    且单口限制使每拍只能取一个操作数, 并行度上不去。给出三条路线对比:
    A 本地缓冲(推荐, 零访存冲突/自包含/可独立验证) / B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
2026-10-05 docs(gap): 应用场景标记为已完成, AI 模型性能标记为基线已量化
    - 应用场景构建: ✅ 已完成 (sw/nn_demo.c, 与独立参考实现逐元素一致, mismatch=0)
    - AI 模型性能: ⏳ 基线已量化 (196264 周期 / 47.91 周期每 MAC), 硬件加速单元待实现
    - 优先级: GEMM 加速单元提升为当前最高价值项; 回归 8 -> 9 PASS
2026-10-05 feat(ai): GEMM 加速单元集成到 SoC (部分工作: 结果仍有 125/256 元素不对)
    ## 已完成并验证的部分
    - rv32_pkg.sv: 新增 MMIO_GEMM_* (CTRL/STATUS/M/K/N/CYCLES + 2KB 缓冲窗口)
    - gemm_accel.sv: int8 矩阵乘加单元, 本地缓冲方案 (A/B/C 片上, CPU 用 MMIO 搬运)
    * 1 MAC/拍的正确性优先版本; 不用 DSP (int8 乘法器小, 落 LUT 即可)
    * 参数合法性检查 (m*k / k*n / m*n 都受缓冲容量约束, 越界直接拒绝启动)
    - mmio_subsys.sv: 地址译码 + 例化 (2KB 对齐窗口用 addr[31:11] 比较)
    - 构建清单: build.tcl / build_ila.tcl / tools/fpga_workflow.py / tools/run_coremark.py
    - sw/nn_demo.c: 加速路径 (打包/启动/轮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
2026-10-05 fix(ai): 修掉 accel 累加器清零失效 + 修掉"自己跟自己比"的假验证测试
    ## 两个真问题 (都在这一轮定位)
    ### 1. 加速单元: 累加器从不归零 (已修, 但还没修好全部)
    `S_CLEAR` 里写 `acc <= 0`, 但下一个状态 `S_MAC` 写的是 `acc <= acc + 积` ——
    **非阻塞赋值的右值读的是旧的 acc**, 于是刚清零的值在同一拍就被
    "旧值 + 积"覆盖掉。后果是每个输出元素的累加器从上一个元素接着算, 从不归零。
    修法: 加 `first_k` 标志, 第一个积**直接赋值**(不累加), 后续才累加。
    ### 2. 验证测试本身是错的 —— "自己跟自己比"
    `gemm_hw_unpack()` 会把 C 覆盖成硬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
2026-10-05 feat(ai): 可综合诊断寄存器 —— 定位到 accel 寻址/取数都正确, 问题在下游写回
    ## 新增可综合诊断设施 (本轮最有效的一步)
    MMIO_GEMM_DBGA / MMIO_GEMM_DBGV: 把状态机**自己算出的 A 字节下标**
    与**该拍读到的操作数**暴露给软件读回。
    排"读不到操作数"这类问题时, 直接看内部算出的下标**比逐层猜测快得多** ——
    前面猜了几轮都不如这一条直接。这两个寄存器是普通寄存器, 可综合,
    留在设计里对功能无影响, 后续调试还用得上。
    ## 排查结果: 三个环节全部排除
    dbg A_off=0x000000FF <- = 15*16+15 = 最后一拍的地址 (地址算术正确!)
    a_val/b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
2026-10-05 feat(ai): 加速单元内部诊断寄存器 (DBGA/DBGV/DBGW/DBGK) + 窗口测绘探针
    ## 新增可综合诊断设施 (本轮实质产出)
    四个普通寄存器, 可综合、对功能无影响, 把加速单元内部状态暴露给软件:
    MMIO_GEMM_DBGA (0x58) 最近一拍算出的 A 字节下标
    MMIO_GEMM_DBGV (0x5C) {b_val, a_val} 该拍读到的操作数
    MMIO_GEMM_DBGW (0x60) {写回次数, 最近写回下标}
    MMIO_GEMM_DBGK (0x64) 运算期间的 {r_n, r_k}
    **方法论收获**: 排"读不到操作数 / 结果不对"这类问题时, 把**状态机自己算出的
    下标与操作数**直接暴露给软件读回, 比逐层猜测快得多。本项目前几轮在这上面
    猜了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
2026-10-05 docs: A 扩展设计(编码已实测) + 记录板子掉线及 hw 子命令的陈旧结果陷阱
    ## A 扩展: 前置条件已验证, RTL 未做 (results/p6-a-extension.md)
    工具链实测可用:
    riscv-none-elf-gcc -march=rv32ia -mabi=ilp32 -c a.S -> exit=0
    反汇编确认的编码 (opcode 全为 0x2F):
    amoadd.w 0x0062a3af funct5=00000
    lr.w 0x1002ae2f funct5=00010
    sc.w 0x1862aeaf funct5=00011
    amoswap.w 0x0862af2f funct5=00001
    amoor.w 0x4062afaf funct5=01000
    字段布局、funct5 全表、实现步骤 (多周期 RMW 状态机 + LR/SC 预留位)、
    以及"amomin/max 有符号 vs amominu/maxu 无符号"这个最易错点, 都写进了文档。
    **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
2026-10-05 fix(tools): 让"上板验证"无法被陈旧数据冒充 —— 新鲜度硬判据
    ## 问题: 验证工具会制造虚假证据
    `python tools\fpga_workflow.py hw` 只解析 results/ila_done.csv (某次抓取的快照)。
    板子掉线 / 没重新抓取时该文件不更新, 于是它**照样打印"上板验证 PASS"**。
    实测: 板子 22:13 已掉线 (JTAG: No devices detected on target), hw 仍报 PASS ——
    数据其实是 17:49 的 (4.5 小时前)。差点把陈旧结果当成本次验证。
    这类 bug 比功能 bug 更危险: 功能 bug 会让测试失败, 这种 bug 会让
    **本该失败的验证显示通过**。
    ## 修法 (两处, 互补)
    ### 1. hw 子命令: 新鲜度门限
    - 打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
2026-10-05 fix(ai): GEMM 加速单元移出默认构建 (把面积翻倍: FF +916%, CoreMark/LUTs -60%)
    ## 量化结论: 打开加速单元会让评分三项全线崩
    LUT 4019 -> 9984 (+148%)
    FF 1387 -> 14097 (+916%) <-- 关键
    fmax 61.6 -> 53.6 (-13%)
    CoreMark/LUTs 5.875e-4 -> 2.365e-4 (-60%)
    绝对吞吐 145.4 -> 126.5 (-13%)
    真因: A/B/C 三个缓冲落成**触发器阵列** (约 1.3 万 FF) 而不是 BRAM。
    c_buf[256] 这种"寄存器阵列 + 组合多路读"综合器不会推断成 BRAM。
    判定: 一个**又不对**(C 读回只有前 16 个字对)、**又把面积翻一倍多**的单元
    绝不能留在评分版里。
    ##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
    [coremark.csv]
2026-10-05 chore(tools): 给 verify/synth 加 --gemm 开关 (GEMM 加速单元的门控入口)
    上一轮把 GEMM 加速单元用 GEMM_EN 宏门控默认关闭, 但没给工具加对应的开关,
    导致无法在仿真里打开它 —— 那样这个宏就成了"只能手改 build.tcl"的死开关。
    现在 verify/synth 都支持 --gemm。
    ## 本轮尝试与结果
    按"一次只改一处"的纪律, 只改了一处: gemm_accel.sv 里
    wire [7:0] aoff = addr[9:2]; -> wire [9:0] aoff = addr[11:2];
    (并把 is_C 加上上界 aoff < 384, 常量统一成 10 位宽)
    理由: arena 布局是 A 字 0..63 | B 字 64..127 | C 字 128..383, 最大字号 383 > 255,
    所以 8 位的 aoff 装不下 —— 这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
2026-10-05 fix(tools): bitstream 新鲜度改按"实际综合输入"判, 修掉宏门控模块的误报
    ## 问题: 误报 stale
    `check` 报 `bitstream 比 1 个输入文件旧 (gemm_accel.sv)` —— 但 gemm_accel.sv
    **由 GEMM_EN 宏门控, build.tcl 与 build_ila.tcl 都不定义该宏**, 所以它根本
    不在 bitstream 里。拿它的 mtime 判过期是**误报**。
    真因: 新鲜度用的是 `canonical_rtl()` 全清单 ("仓库里所有核 .sv"),
    而"会被综合的输入"是全清单的**子集** (门控模块不在内)。
    ## 修法
    新增 `synth_inputs_for(args)`: 从 canonical_rtl() 里滤掉被宏关掉、不会进网表的
    模块 (当前只有 gemm_accel.sv, 条件为 GEMM_EN)。**synth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
    [coremark.csv]
2026-10-05 verify(hw): 当前 RTL (GEMM 门控后) 已在真板验证 + 重抓流水线波形
    ## 为什么必须重做这次上板验证
    22:25 那次跑的是 GEMM 门控**之前**的 ILA bitstream (22:24 构建, 而门控改动在
    22:31/22:37) —— 所以那次**不能代表当前代码**。按纪律重建 ILA 版并重抓:
    ILA 重建 : 22:47 (ILA_BUILD_OK, 时序约束满足)
    抓取 : 22:48:13 CSV_MTIME 自证 AGE_SEC=0
    结果 : ila_ctrl=0x42, CRC 判定=1, tick=508,155,404, 10.16s -> PASS
    ## 流水线波形重抓 (results/ila_pipeline.csv, 22:48)
    stall = 236/2048 = 11.52% (上次 11.57%)
    redirect = 15/2048 = 0.73% (上次 0.68%)
    illegal = 0
    PC 热点 = 0x80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
    [ila_pipeline.csv]
2026-10-05 docs: 分析报告与相关文档改为修正后的真实指标 (消除事故前的错误数字)
    ## 为什么必须改
    `results/analysis-report.md` 是**要交的分析报告**, 但它是事故前写的, 里面
    整张指标表都是不可复现的数字 (fmax 70.9 / LUT 2526 / 9.347e-4 / 167.5)。
    "文档与实测一致"是本目标明确要求的, 所以必须修。
    ## analysis-report.md 的修改
    - 顶部加"数据口径说明": 说明初版数字为何不可复现 (宏在仿真侧从未生效,
    PITFALLS R17), 并给出现行真实数字
    - 三项评分指标表 -> 修正后: CoreMark/MHz 2.3611 / fmax 61.6 / CM-LUTs 5.875e-4
    / 绝对吞吐 145.4 (相对基线 +185.8% / -21.4% / +148.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
2026-10-05 docs(cache): Cache 可行性分析 —— 判定架构性无收益, 不实现 (附定量依据)
    ## 决定性的架构事实
    读 dmem.sv 的实现:
    always @(posedge clk) begin
    if (we) ... 字节写使能 ...
    rdata <= mem[addr[AW+1:2]]; // 寄存读 -> BRAM
    end
    **dmem 已经是一个单周期命中的片上存储器** (16KB, 行为级推断的 BRAM, 1 拍延迟,
    带字节写使能)。imem 同理。
    **Cache 的意义是"掩盖慢速存储器的延迟"。当存储器本身已经是单周期命中的片上
    BRAM 时, 在它前面插一层 Cache 是架构性冗余**: 读延迟依然 1 拍 (Cache 命中要查
    tag + 比较 + 数据 mux, 而 BRAM 本来就 1 拍), 却额外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
2026-10-05 feat(isa): A 扩展数据通路 (ALU + 包定义) + 14 条 AMO 单元检查
    按 results/p6-a-extension.md 的设计开始实现 A 扩展。本轮完成**数据通路层**
    (自包含、可独立验证), 多周期控制留到下一轮。
    ## rv32_pkg.sv
    - OPC_AMO = 7'b0101111
    - alu_op_e 增加 9 个 AMO 算符 (5'd18..26): SWAP/ADD/XOR/AND/OR/MIN/MAX/MINU/MAXU
    - 11 个 AMO funct5 常量 (LR/SC/SWAP/ADD/XOR/AND/OR/MIN/MAX/MINU/MAXU),
    编码全部来自实测 (results/p6-a-extension.md)
    - ctrl_s 增加 amo_en / amo_op[4:0] / amo_aq / amo_rl
    (aq/rl 单核无 cache 无副作用, 但显式译码, 避免被当成漏实现)
    ## alu.sv
    算子约定: **a = 从内存读回的旧值, b = rs2** -> a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
    [coremark.csv]
2026-10-05 verify(hw): A 扩展数据通路已上板验证 + 记录多周期 RMW 的集成难点
    ## 补上上一轮的验证缺口
    上一轮交付了 A 扩展数据通路 (rv32_pkg + alu) 但只重建了评分版, **ILA 版没重建**,
    所以当时不声称已上板。本轮补做:
    ILA 重建 : 23:04 (ILA_BUILD_OK)
    抓取 : 23:05:43 CSV_MTIME 自证 AGE_SEC=0
    结果 : ila_ctrl=0x42, CRC 判定=1, tick=508,155,404 -> PASS
    ## 查清了多周期 RMW 的集成难点 (写进 results/p6-a-extension.md 第 5 节)
    把 LSU 的地址来源追到底:
    core.sv:585 .alu_out_in (ex_result) // ex_mem_reg 在 EX 末尾锁存
    core.sv:590 .alu_out (ex_mem_alu_out)
    core.sv:606 .req_ad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
2026-10-05 feat(isa): A 扩展译码 (A_EN 门控默认关) + 22 条译码检查
    ## control_unit.sv: OPC_AMO (7'b0101111) 译码
    字段布局与 R 型一致, funct5 = instr[31:27] 选算子:
    [31:27]funct5 [26]aq [25]rl [24:20]rs2 [19:15]rs1 [11:7]rd
    - 11 个 funct5 全部映射 (LR/SC + 9 个 AMO -> 对应 ALU 算符)
    - wb_src = WB_MEM (所有 A 指令的 rd 都是"从内存读回的旧值")
    - amo_en/amo_op/amo_aq/amo_rl 全部译码
    - 非法组合拦截: funct3 != 010 (.W 之外的变体)、未实现的 funct5
    ## 【实测代价】译码默认关闭 —— 它是纯代价
    fmax 61.7 -> 58.8 MHz (-4.7%)
    LUT 4078 -> 4104 (+26)
    绝对吞吐 145.6 -> 138.9 (-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
    [coremark.csv]
2026-10-05 docs: 板子掉线 -> 停止本轮并报告; 用综合报告实证 A_EN=0 是 inert 的
    ## 板子掉线 (按纪律停止)
    23:19 JTAG 报: ERROR: [Labtools 27-2269] No devices detected on target
    最后一次成功上板 = 23:05:43 (CSV_MTIME 自证 AGE_SEC=0), PASS, tick=508,155,404。
    ## 论证 23:05 那次是否覆盖了 23:12 的改动
    提交 8b1afd6 (A 扩展译码 + A_EN 门控, 23:12) 在**评分配置下是 inert 的**:
    A_EN 默认不定义 -> control_unit 走 \else OPC_AMO: illegal = 1'b1;
    与加 A 扩展之前完全一致。用两次综合归档报告实证:
    项 加译码前(22:58) 加译码后 A_EN=0(23:18)
    Slice LUTs 4078 4078
    Slice Regs 13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
2026-10-06 docs(report): 分析报告补 5.4 节'应用场景' + 全篇指标统一到当前口径
    ## 新增 5.4 应用场景：神经网络推理核心 (AI 相关维度)
    赛题有'应用场景构建'与'AI 模型性能'两项, 原报告只在表格里带过, 缺实质章节。
    补上:
    - **软件基线** (可信可复现): sw/nn_demo.c 两层 MLP 前向核心, 16x16 GEMM
    gemm_cycles=196264 / cycles_per_mac=47.91 /
    - 写明踩过的坑: 第一版 checksum_ref 错写成'再对 C 求校验和' -> 两个校验和恒等、
    match 永远为 1, 一个**永远为真什么也证明不了**的检查;
    参考实现必须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
2026-10-06 feat(a-ext): AMO 黄金向量生成器 (独立参考实现) + 双向交叉验证
    ## 为什么加这个
    A 扩展最凶的坑是 **min/max 有两套符号语义** (amomin/max 有符号,
    amominu/maxu 无符号), 而这个错误**只在边界值上暴露** —— 用普通小正数测试
    会全绿。本人写 ALU 时就真把 amo_max 的三元方向写反过 (取成了 min)。
    所以在实现"多周期读-改-写"之前, 先把**独立于被测实现的黄金参考**建好,
    这样到时候是"拿向量校验", 而不是"再手写几个用例碰运气"。
    ## tools/amo_vectors.py
    用 **Python 重新实现一遍 AMO 语义** (刻意不复用 Verilog 的写法)。
    输出 sim/prog/amo_vectors.hex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
2026-10-06 docs: README 重写为可交付的首页 (成绩速览 + 修正全部陈旧描述)
    ## 问题
    README 是交付物的首页, 但它严重陈旧:
    - 标题写 "RV32I 处理器" —— 实际是 **RV32IM** (+ Zicsr + M-mode 异常/中断)
    - "6 组系统级测试" —— 实际 **9 组**
    - "imem/dmem 组合读 LUTRAM" —— 实际早已改成**寄存读 -> 行为级 BRAM**
    - "alu: M 扩展编码预留 (命中输出 x)" —— M 扩展早已启用
    - **完全没有成绩** —— 评委/读者看不到三项指标与上板结论
    - 文件清单缺 muldiv/btb/csr_file/ras/gemm_accel/fpga 顶层/sw
    ## 改法
    1. 顶部加**成绩速览**: 三项评分指标 + 绝对吞吐 + 基线对比 + 资源 +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
2026-10-06 docs(handoff): 重写第 0 节为可执行的上手摘要 (含四条已封路 + 唯一剩余两件的落点)
    ## 为什么改
    HANDOFF 第 0 节是接手的 AI/人读到的**第一段**, 但它严重陈旧:
    - HEAD 哈希还写着 9083059 (实际已 40+ 次提交之后)
    - '三项评分指标齐全' 但**没有数字**
    - '期望 7 PASS' (实际 9)
    - 没有'哪些路已经封了'的警告 -> 接手者极可能重复踩已经花过四轮代价的坑
    ## 改成什么
    1. **一句话现状**: 带上四项指标 + 上板结论 + 验证日期
    2. **上手第一件事**: doctor / verify(期望 9 PASS) / check / **jtag_probe**
    (改 RTL 前先确认板子在位 —— 这是用户明确要求的纪律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
2026-10-06 feat(a-ext): 把 AMO 接成 LSU 已有的多周期 FSM 的新增相 (dormant, 上板已验证)
    ## 关键发现: 正确落点是 LSU, 不是 core.sv
    Round 14 我给的方案是"core.sv 加三个 mux + hazard_unit 加 amo_busy", 并把难点
    写成"要跨 EX/MEM 边界"。**读 load_store_unit.sv 后发现那是绕远路** ——
    LSU 本来就有为"非对齐跨字访存 2 拍拆分"建的多周期机制:
    S_IDLE/S_HEAD/S_TAIL 状态机 + 按相选地址 + 按相控写使能 + lsu_stall 冻结流水线
    + 在相内捕获读回数据 (head_word_r <= dmem_rdata)
    **AMO 需要的全部要素它都具备**, 所以加相即可, 不必动 core.sv 的内存路径接线、
    更不必动 ex_mem_re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
    [coremark.csv]
2026-10-06 docs(handoff): A 扩展只剩两步的精确落点 + 汇编器已支持 .word 的好消息
    ## Round 23 更新 HANDOFF 第 0 节
    1. 修正: A 扩展现状由'缺多周期控制'改为'**LSU 多周期相已完成, 差最后两步**'
    —— Round 22 已经把 S_AMO 相加进 load_store_unit.sv, 且 core.sv 已显式连接端口
    2. 精确写出剩下的两步 (根因 + 做法):
    根因: AMO 的新值**不能在 EX 段算** —— ALU 的 ALU_AMO_* 约定 a = 从内存读回的
    旧值, 而 dmem 是寄存读, 旧值要到 MEM 段第二拍才到。
    步骤 1: ctrl_s 加 amo_rs2[31:0], 把 rs2 随流水送到 MEM 段
    步骤 2: 在 MEM 段用 {amo_old, amo_rs2} 算新值 —— 最省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
2026-10-06 feat(a-ext): AMO 读-改-写基本打通 + 集成测试 (XFAIL) —— 剩 1 个数据通路问题
    ## 本轮把 A 扩展从"器都没接"推进到"状态机跑通、只差取数"
    ### 新增: sim/prog/amo.S + 回归项 tb_core_amo
    用 `.word` **手工编码** AMO 指令写了一个 9 组自校验程序 (迷你汇编器不认 AMO
    助记符, 但支持 .word —— 所以不必改汇编器)。覆盖:
    - amoadd / amoswap / amoor / amoxor / amoand 的值与 rd(旧值)
    - **min/max 的有符号 vs 无符号**: 特意用 -1 vs 1 与 0x80000000 vs 0x7FFFFFFF
    (普通小正数测不出两套语义的差别)
    - 加法回绕 (0xFFFFFFFF + 2 = 1)
    配套给 verify 加了**按测试自带 defines*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
2026-10-06 fix(a-ext): 定位 AMO 读数卡点 = dmem_rdata 恒 0 (非 AMO 特有) + 指标同步
    ## 本轮真正的进展: 把卡点从"旧值捕获时机"缩到"读通路本身"
    补了一条诊断打印 (含 dmem_rdata), 拿到完整时序:
    t=145000 st=0 act=0 ph=0 wr=0 stall=0 we=0 addr=90003114 rdata=00000000
    t=155000 st=3 act=1 ph=0 wr=0 stall=1 we=0 addr=90003114 rdata=00000000
    t=165000 st=3 act=1 ph=1 wr=1 stall=0 we=1 addr=90003114 rdata=00000000
    **关键发现: `dmem_rdata` 每一拍都是 0** —— 连"读回刚 sw 进去的值"都拿不到。
    => **这不是 AMO 特有的问题**, 嫌疑在 LSU 的 `dmem_rdata` 输入通路 (core 里
    `dmem_rdata_g` 的译码 / "窗口内取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
    [coremark.csv]
2026-10-06 fix(a-ext): AMO 改为"等待+读相+写相"三相位 (修采样时机) + 记录未解卡点
    ## 本轮修复: AMO 旧值的采样时机错了整整一拍
    上一轮把卡点定位到"dmem_rdata 恒 0", 本轮用 core.sv 里的 [rd] 诊断打印把
    读数据链一次打全, 拿到决定性数据:
    t=145000 we=0 addr=90003114 sel_dmem=1 sel_dmem_r=0 | u_dmem.rdata=00000000
    t=115000 we=1 addr=90003100 sel_dmem=1 sel_dmem_r=0 | u_dmem.rdata=00000000
    推论: dmem 是**寄存读**(地址第 N 拍、数据第 N+1 拍)。AMO 在**启动拍**就把地址
    送到 dmem 了, 所以数据在**下一拍(等待拍)**末尾才有效 —— 而我原先写的
    `if (state == S_AMO && !amo_phase) amo_ol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
    [coremark.csv]
2026-10-06 fix(a-ext): 把 AMO 新值计算单元也门控掉, 拿回 fmax 59.1 -> 61.2 MHz
    上一轮发现: AMO 的 FSM 与 core.sv 里**无条件例化**的第二个 ALU 实例,
    即使休眠也占面积与路径 —— fmax 61.2 -> 59.1 MHz (-3.4%), LUT 4079 -> 4093。
    上一轮我给 LSU 侧的 AMO mux 加了 `ifdef A_EN`, 但**没生效**: 因为代价的真正来源
    是 core.sv 里那个**没被门控**的第二个 ALU。
    把 core.sv 里的 AMO 新值计算单元整体放进 `ifdef A_EN`:
    - `amo_rs2` 寄存器、`u_amo_alu` 实例、`amo_newdata` 的组合选择
    - `else` 分支: `assign amo_newdata = 32'd0;` (并注明"整个单元不综合")
    - `amo_new_comb` 的声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
    [coremark.csv]
2026-10-06 fix(a-ext): 定位到 AMO 地址算错 (比 sw 多 0x14) —— 读回 0 的根因可能在此
    ## 本轮把范围又砍了一半, 并得到一个可能改写结论的发现
    把 dmem 的写端口、内部存储阵列、读端口一次全打出来:
    t=115000 WE=1 wdata=00000064 strb=f addr=90003100 | mem[3136]=00000000 rdata=00000000
    t=175000 WE=1 wdata=00000000 strb=f addr=90003114 | mem[3141]=00000000 rdata=00000000
    ### 结论 A: dmem 的写端口是好的
    WE=1 / wdata=0x64(=100) / strb=f(整字) 全部正确 —— 写请求没问题。
    同拍 mem[3136] 仍读 0 **不能**当作"没写进去"的证据 (非阻塞赋值, 本拍读到的是旧值);
    **必须看下一拍的 mem[3136]** —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
    [coremark.csv]
2026-10-06 fix(a-ext): 修掉 AMO 地址 bug —— alu_b_src 没设, 地址被算成 rs1+rs2 而非 rs1+imm
    ## 根因 (Round 29)
    control_unit.sv 的 OPC_AMO 分支**只设了 alu_op, 没设 imm_fmt / alu_a_src /
    alu_b_src**。而 `ctrl = '0` 的默认值恰好是:
    alu_a_src = ALU_A_RS1 (0) -> 正确, a 取 rs1
    alu_b_src = ALU_B_RS2 (0) -> **错! b 取 rs2 而不是立即数**
    imm_fmt = IMM_I (0) -> 值对, 但只有 b 选 IMM 时才用得上
    于是 AMO 的访存地址被算成 **rs1 + rs2**, 而不是 rs1 + imm (AMO 的 imm 恒 0,
    正确结果应当就是 rs1)。
    **实测症状**: sw 写 0x90003100, 同一个 t0 上的 AMO 却访问 0x90003114 ——
    差的正是当时 t1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
    [coremark.csv]
2026-10-06 fix(a-ext): AMO 地址改用独立加法器 (与算子解耦) —— 同一个坑第二次出现
    ## 根因 (第二层)
    上一轮补了 alu_b_src = ALU_B_IMM, 但那只解决了"b 取立即数", 没解决更根本的冲突:
    ex_result = is_muldiv ? md_result : is_csr ? csr_rdata : ex_alu_out;
    - AMO 的 alu_op 是 ALU_AMO_* —— 那是用来算 **"应写回内存的新值"** (old op rs2)
    的, **不是地址**;
    - 而 ex_result 在 is_muldiv/is_csr 之外**直接取 ex_alu_out** ——
    于是 LSU 拿到的"地址"其实是 **AMO 的算子结果** (old + imm)。
    实测症状: 地址恒差一个 +4 (当时 imm=4 被当成加法项加进了"地址")。
    ## 修法: 给 AMO 一个独立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
    [coremark.csv]
2026-10-06 docs(pitfalls): 新增 R23/R24/R25 —— A 扩展踩到的三个坑 (含一个绕了三轮的教训)
    ## R23. 症状是"读回 0", 真因是地址算错 —— 别一头扎进读通路
    做 A 扩展时 AMO 读回的内存值恒为 0。我连续三轮 (Round 25/26/27) 去查**读通路**
    —— 查 dmem_rdata、查译码 mux、查 sel_dmem_r 寄存器、查 dmem 写端口 ——
    每轮都"更接近", 每轮都不对。
    **真因与读通路毫无关系**: OPC_AMO 分支只设了 alu_op, 没设
    alu_a_src/alu_b_src/imm_fmt; 而 ctrl 全零默认的 alu_b_src = ALU_B_RS2,
    于是地址被算成 rs1+rs2。实测 sw 写 0x90003100, 同一 t0 上的 AMO 却访问
    0x90003114 —— 差的正是当时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
2026-10-06 feat(a-ext): 新增单步诊断程序 amo_diag.S —— 一次定位到"AMO 特有 +4 地址偏移"
    ## 为什么要另写一支程序
    amo.S 一次测 9 组, 失败时只知道"第 1 组错", **不知道错在地址/读/写哪一环** ——
    前四轮我都在这个模糊度里打转。于是新增 sim/prog/amo_diag.S (回归项
    tb_core_amo_diag): 只做最小一组 (sw 100 -> amoadd.w 加 23 -> 查 rd 与内存),
    并把**中间结论直接写进 tohost**:
    1=全过 2=sw 后 lw 读不回(基础读写坏) 4=AMO 读到 0 5=AMO 旧值不对 6=写回不对
    ## 实测结论: tohost = 5, 并由此得到新的硬线索
    | 操作 | 地址 |
    |---|---|
    | sw t1, 0(t0) | 0x900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
    [coremark.csv]
2026-10-06 fix(a-ext): AMO 读-改-写**打通** —— 单步诊断程序 RESULT : PASS
    ## 本轮修掉两个真 bug, 基本功能跑通
    ### Bug 1: AMO 的偏移不能用 id_ex_imm (imm_gen 把 rs2 当成了立即数)
    诊断打印 [ex-amo] 实测:
    rs1=90003000 imm=00000006 addr=90003006
    而 amoadd.w t2,t1,(t0) 的编码 0x0062A3AF 其 imm[11:0] **恒为 0**。
    原因: imm_gen 的 I 型提取用 instr[31:20], 而 AMO 的 [31:27] 是 funct5、
    [24:20] 是 rs2 —— 于是**把 rs2 当成了立即数**(本例 rs2=t1 的编号 6)。
    这个 6 污染了地址; 历史上的 "+4" 是同一成因(当时 rs2 编号恰好是 4)。
    修法: 按规范 AMO 没有立即数字段, 地址直接 **ex_amo_addr =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
    [coremark.csv]
2026-10-06 fix(a-ext): 定位到最后一个卡点 —— amo_op 在 EX→MEM 被 hold_mem 挡住没锁存
    ## 本轮用"单步诊断 + tohost 上报"再砍一层
    新增 sim/prog/amo_diag2.S (amoswap 单步诊断), 得到 **tohost=4**:
    **rd (旧值 0x1111) 正确, 但内存没被改成 0x2222** —— 即新值写错了。
    打印 [amo-w] 看到:
    op=00000 old=00001111 rs2=00002222 comb=00003333
    comb = 0x3333 = 0x1111 + 0x2222 —— 它算的是 **ADD**, 不是 SWAP!
    而 amoswap 的 funct5 应当是 **00001**。
    再并排打印 EX 与 MEM 两段:
    t=175000 ex_en=1 ex_op=00001 mem_op=00000
    **ex_op 对 (00001), 到了 MEM 变成 00000。**
    ## 根因 (已定位到具体一行)
    ex_mem_reg.s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
    [coremark.csv]
2026-10-06 fix(a-ext): amo_op 自己锁存 (不动 hold_mem 语义) —— 三个算子全部算对
    ## 修掉的两处
    ### 1. amo_op 跨 EX->MEM 丢失 (Round 34 定位到根因)
    ex_mem_reg.sv 的 `else if (!stall) ctrl <= ctrl_in;` 而 stall = hold_mem ——
    AMO 停在 EX 期间 ctrl 根本锁不进去, 于是 MEM 段看到的 amo_op 恒为 0,
    把 amoswap 当 amoadd 算。
    **修法**: 在 core.sv 里**自己锁存一份** amo_op_r。
    关键取舍: **完全不动 hold_mem / ex_mem_reg 的语义** —— 那是本项目最敏感、
    吃过最多亏的地方 (IMEM_REG_READ 四轮失败都与此有关)。
    ### 2. amo_op_r 的锁存条件错了
    第一版写成 `else if (amo_en_d)` (延迟一拍), 但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
    [coremark.csv]
2026-10-06 fix(a-ext): LSU 写信号全部正确 —— 修正"值没写进内存"的判断, 卡点收窄到跨组残留
    ## 本轮逐拍打出 AMO 各相的写信号 ([L]), 三组写相都是教科书式正确
    t=175000 st=3 wr=1 stall=0 WE=1 strb=f WDATA=0000007b nd=0000007b -> amoadd
    t=325000 st=3 wr=1 stall=0 WE=1 strb=f WDATA=00002222 nd=00002222 -> amoswap
    t=475000 st=3 wr=1 stall=0 WE=1 strb=f WDATA=ffffffff nd=ffffffff -> amoor
    **每一组都发出了正确的整字写** (WE=1 / strb=f / 写数据 = 正确的算子结果)。
    相位推进也正确: en=1 -> wait -> 读相 -> 写相(wr=1, stall=0)。
    **所以"写回"这一环在 LSU 侧是对的** —— 上一轮"值没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
    [coremark.csv]
2026-10-06 fix(a-ext): amo_mode_r 被过早清掉 (真 bug) —— WB 拍选错了数据来源
    ## 修掉的 bug
    原代码:
    if (amo_en) begin
    ...
    amo_mode_r <= 1'b1; // 启动拍置 1
    else begin
    amo_mode_r <= 1'b0; // **下一拍就被清掉!**
    ...
    `amo_en` **只在启动拍有效**, 所以 amo_mode_r 在**进入序列的第二拍就变 0** ——
    而它本该让 **WB 拍**选 amo_old (AMO 的旧值)。等到真正的 WB 拍它已经是 0,
    WB 于是去读 dmem_rdata (那时 dmem 上早就是别的地址) -> rd 错误。
    **修法**: 只要序列还在进行就保持为 1, 收尾那一拍才落下:
    if (amo_active) amo_mode_r <= 1'b1;
    els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
    [coremark.csv]
2026-10-06 docs(pitfalls): 新增 R26/R27/R28 —— 这次 A 扩展最值钱的三条经验
    ## R26. 同一段新逻辑上往往不止一个 bug —— 修掉一个不见效≠方向错了
    写 AMO 时, **同一段逻辑叠了两个 bug, 修掉第一个完全没改善现象**:
    - **地址**上叠两个: (1) alu_b_src 没设(默认取 rs2 而非立即数) ->
    (2) 即便设对了, ex_result 仍取 ex_alu_out(算子结果) 而不是 rs1+imm。
    只修 (1) 时地址仍差 +4, 看起来"这个方向错了", 实际是第二个 bug 在等着。
    - **数据来源**上叠两个: (1) amo_op 跨 EX->MEM 被 hold_mem 挡住没锁存 ->
    (2) amo_mode_r 只保持一拍(WB 拍选错来源)。
    修掉 (1) 后前两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
2026-10-06 fix(a-ext): 回退我自己引入的 bug —— !(state==S_AMO) 守卫生错了地方
    ## 回退的 bug (Round 37 我自己引入的)
    Round 37 我为了"避免 AMO 期间规格被覆盖", 给 off_wb/size_wb/uns_wb/split_wb
    的捕获加了守卫 `!(state == S_AMO)`。**这是错的**:
    > "请求离开 MEM"那一拍**正是 AMO 的写相** (state 还是 S_AMO, 写相把 lsu_stall
    > 拉低放行)。加了守卫 -> **紧随 AMO 之后那条指令的 off_wb/size_wb/uns_wb/
    > split_wb 永远不被锁存** -> 它的字节提取/符号扩展用的是**上一条的规格**
    > -> 表现为"AMO 之后那条 lw 读回 0"。
    **已回退该守卫。** 这也解释了 amoor 组为什么一直挂: 前面几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
    [coremark.csv]
2026-10-06 docs(handoff): 第 0 节更新到最终状态 (A 扩展基本打通, 只剩 amoor 组)
    [coremark.csv]
2026-10-06 docs: 待办清单统一排序 + 更正 p7 关于 imem 的错误论断
    ## 1. gap-analysis.md 新增"待办清单（统一排序）"
    按"预期收益 / 风险"排, 每项都写了量化收益、风险与验收标准:
    | # | 事项 | 预期收益 | 风险 |
    |---|---|---|---|
    | 1 | 先量清 muldiv 的 3.1% 构成 | 零(只为决策) | 零 |
    | 2 | **IMEM_REG_READ BRAM 化 + FAR 配对** | **CoreMark/LUTs +40%**(LUT 4079→~2851) + 可能提 fmax | 中 |
    | 3 | 关键路径物理优化(floorplan/位置约束) | fmax (route 占 66% 是主因) | 低 |
    | 4 | LOAD_RESULT_REG | fmax | 中 |
    | 5 | GEMM 的 C 读回 + 缓冲改 BRAM | 评分三项 0, 但撑起"AI 模型性能"栏 | 中 |
    | 6 | M1 除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
2026-10-06 feat(todo#1): 量清 muldiv 的 3.1% 构成 —— 推翻两个错误估算, 待办 #6/#8 判定不做
    ## 做法
    在 muldiv.sv 内插桩 (每次除法收尾打印累计值), 量"纯迭代 vs 固定开销"。
    **途中踩到两个工具坑** (都是 R17 那类):
    1. `cmd_profile` 走 `compile_sim(files, "sim/tb_sw.sv")` —— **不传任何 defines**,
    所以 `+define+M_DEBUG` 在这条路径上永远不生效。改为计数器常开、仅打印用 $display。
    2. `cmd_profile` 把仿真输出**捕获在内存里**, 只打印解析后的剖析
    -> `$display` 的 [MD] 行永远到不了终端。必须手动跑 vsim 才能看到。
    3. 另外 `profile` **不接受 `--force`** —— 我前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
    [coremark.csv]
2026-10-06 feat(todo#2): 取指相位配对打通 (IMEM_REG_READ 不再 timeout) + 修 verify 指纹漏宏
    ## 进展: 前四轮失败的真正根因找到了
    推演 + 逐拍实测把机理钉死, 并纠正了我上一轮的**错误断言** (我曾说根因是
    重定向 mux 并在 core.sv 里据此改过一轮 —— 实测证明那条理论是错的)。
    真正的正确配对是"纯延迟, 一行 mux 都不加":
    - 组合读: cycle N 内 addr=pc(N) 且 rdata=instr(pc(N)), 同拍
    - 寄存读: imem 沿锁存 mem[pc], 下一拍才吐出; 于是 cycle N+1 那拍
    imem_rdata = instr(pc(N)) 而 pc = pc(N+1)
    必须用 **pc 的延迟副本** 去配, 且 imem 的地址接**当前 pc**
    (曾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
2026-10-06 feat(todo#2): 取指相位配对打通 -- imem_reg_read 从全 timeout 到 3 PASS
    ## 前四轮失败的真正根因 (推演 + 逐拍实测钉死)
    并纠正我上一轮的**错误断言**: 我曾说根因是"重定向 mux 选错地址"并据此改过
    一版, 实测证明那条理论是错的 (去掉 mux 后失败点纹丝不动)。
    正确配对 = **纯延迟, 一行 mux 都不加**:
    组合读: cycle N 内 addr=pc(N) 且 rdata=instr(pc(N)), 同拍
    寄存读: imem 沿锁存 mem[pc], 下一拍才吐; 于是 cycle N+1 那拍
    必须用 pc 的**延迟副本**去配, imem 地址接**当前 pc**
    前四轮全败在"想在延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
2026-10-06 docs(amoor): 真根因找到了 -- AMO 停顿期间 PC 与 IF/ID 失步, 释放时吞掉紧随的 lw
    ## 推翻了此前两轮的方向性误判
    - 5.8~5.10 认为是"写通路"问题 (错)
    - 5.11 认为是"AMO 之后那条 lw 的 WB 规格"问题 (也错)
    两处经逐拍实测**均已证明正确**。真因在**取指/停顿的失步**。
    ## 决定性证据 (+amo_trace, amo.S 第 3 组)
    布局关键: lw 紧贴 AMO
    0x80000084 amoor.w t2,t1,(t0)
    0x80000088 lw t4, 0(t0) <- 紧贴
    0x8000008c lui t3, 0xFFFFFFFF
    逐拍 (idex_pc=ID/EX, if_pc=IF/ID):
    cyc39 st=0 idex_pc=0x80000084(AMO) if_pc=0x80000088(lw) <- lw 已在 IF/ID
    ==== AMO enters MEM ====
    cyc41 st=1 idex_pc=0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
2026-10-06 docs(gap): 待办清单同步到真实状态 -- #2 进行中(卡结构约束), #2b 否决, 新增 #4 前端失步
    本轮两件实事 + 一个真根因, 全部反映进优先级:
    #2 IMEM_REG_READ 🔶 相位配对打通 (0->3 PASS), 但卡在结构约束:
    要么多一个取指气泡(重定向 2->3 拍, 代价 4.9%),
    要么上两级取指(改级数, 不允许)
    #2b LOAD_RESULT_REG ⛔ 实测更差, 已否决
    #4 取指前端停顿失步 🆕 根因已锁定未修. 不只影响 A 扩展:
    任何多周期停顿都可能吞掉紧随的指令
    #7 A 扩展 amoor 🔶 阻塞在 #4 (此前两轮方向误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
2026-10-06 feat(todo#2 完成): IMEM 成功 BRAM 化 -- 组合推算取指地址(pc_next), 零周期代价
    ## 结论: 打通了, 五轮失败史终结
    关键洞察 (前五轮全没看到): **取指地址要接"下一拍的 pc"(组合推出), 不是当前 pc**。
    imem 是寄存读 -> imem_rdata(N) = mem[addr(N-1)]
    令 addr = pc_next:
    不变式: imem_rdata(N) = mem[pc_next(N-1)]
    未停顿: pc_next(N-1) = pc(N) -> mem[pc(N)] ✓
    停顿中: pc_next(N-1) = pc(N-1) = pc(N) (冻结) -> mem[pc(N)] ✓
    → **两种情况都得到 imem_rdata(N) == mem[pc(N)]**, 与组合读逐位同口径
    → IF/ID 接线一行都不用改 (仍用当前 pc/pc_plus4/pred_taken)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
    [coremark.csv]
2026-10-06 docs(todo#2): 待办清单与交接文档同步到"BRAM imem 已打通"
    - HANDOFF: 把 IMEM_REG_READ 从"已封路"移到"已打通"; 新增"两个可选架构配置"
    对照表 (comb 默认 vs --imem-reg-read), 明确取舍与"BRAM 版尚未上板验证"
    - gap-analysis: #2 标记完成并附实测表; #3 改为"未动(新瓶颈: route 67%, pc_sel 扇出 60)"
    - PITFALLS: 新增 R29 / R30
    * R29 PowerShell 5.1 的 Get-Content|Set-Content 会把 UTF-8 写成双重编码乱码
    —— 本轮真毁过一次 p4-macro-failure.md, 只能用 git checkout 恢复。
    修法: 改文本一律用 edit/write 工具; 脚本化改文件要写 .py 文件而不是
    python -c (PS 会吃掉反引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
    [coremark.csv]
2026-10-06 feat(todo#2 上板闭环): BRAM imem 在真实硬件上验证通过 -- tick 与组合读逐位相同
    ## 上板实测 (2026-10-06 17:25, 达芬奇Pro / XC7A100T)
    CRC 判定 = bit31=1 -> 逐位匹配官方参考值
    tick = 508,155,404 <- 与组合读版**逐位相同**
    iterations = 1200, 10.16 s @50MHz (满足 >=10s)
    CoreMark/MHz = 2.3615
    **tick 与 CRC 都与组合读版逐位相同** -> 不是"能跑", 是语义等价性在硅上被证明。
    ## 为此补的一处工具缺口
    build_ila.tcl 原来**不带任何架构宏** -> 上板验证的永远是"没开宏"的版本
    (PITFALLS R18 踩过一次: 假的 PASS)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
2026-10-06 docs(todo#3): fmax 实验 B 记录 -- 3 种布局策略 + cf 预计算, 结论是"cf 与布局都不划算, 已回退"
    ## 背景
    BRAM imem 打通后关键路径终点从 u_pc/pc_reg[7]/D 变成 u_imem/ADDRARDADDR[12],
    涨的全是布线 (logic 5.425/route 11.173 vs 基线 5.542/10.503)。路径上最贵的一跳
    是 id_ex_ctrl.pc_sel: 扇出 60, 单跳 0.947ns。
    ## B1 place_design 策略 (regread, 均 BUILD_OK, ticks 不变)
    ExtraTimingOpt 58.4
    WLDrivenBlockPlacement 58.9 <- 最佳, 只 +0.5
    AltSpreadLogic_high 58.4
    ## B2 cf 预计算 (把 pc_sel 的 2 位比较从 EX 移到 ID, 寄存成 1-hot)
    | 配置 | 策略 | cf | fmax | LUT | CM/LUTs | 吞吐 |
    | comb | ExtraTi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
    [coremark.csv]
2026-10-06 chore: 用当前 RTL 重建评分版 bitstream (check 报 bitstream 过期); 四项指标回到基线 2.3611/61.2/4079/5.788e-4
    [coremark.csv]
2026-10-06 feat(todo#4+#7 完成): A 扩展打通 (tb_core_amo XFAIL->PASS), 全量回归 11 项全绿
    ## 真根因: LSU 在 AMO launch 拍漏拉 lsu_stall (一行)
    load_store_unit.sv:
    assign lsu_stall = (state == S_HEAD) || (state == S_IDLE && (needs_split || amo_en))
    || (state == S_AMO && (amo_wait || !amo_phase));
    ^^^^^^^^ 本次补上
    拆分的非对齐访存在同一位置 (S_IDLE && needs_split) 是**拉停**的, AMO 这条漏了
    -> 两条多周期路径不对称。
    后果: launch 拍不拉停 -> hold_mem=0 -> 流水线多前进一拍
    -> EX/MEM 被后一条指令顶掉、MEM/WB 提前一拍让出
    -> AMO 的 W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
    [coremark.csv]
2026-10-06 chore: 上板复验通过 (含 AMO 修复的 RTL) + 记录 R33 (ILA 构建失败后必须清 ila_proj)
    ## 上板复验 (2026-10-06 18:05, 达芬奇Pro / XC7A100T)
    CRC = bit31=1
    tick = 508,155,404 <- 与 AMO 修复前**逐位相同**
    1200 iters / 10.16 s @50MHz
    => lsu_stall 那行修复对默认配置(A_EN 关)确实零影响, 硬件上也证实了。
    ## R33 (新坑): ILA 构建失败后必须删掉 fpga/ila_proj* 再重试
    一次 IP_Flow 19-3505 失败后, 项目目录被留在损坏状态, 之后**每次**构建都在
    同一处失败, 报错极具误导性:
    "couldn't read file .../msgcat-1.5.1.tm: no such file or dir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
    [coremark.csv]
2026-10-06 feat: imem 与 dmem 统一走 BRAM, 并把它提升为默认配置 (宏语义反转)
    ## 交付配置: imem 与 dmem 都是 BRAM
    imem: 寄存读 -> 行为级推断 RAMB36 x4
    dmem: 寄存读 (always @(posedge clk) rdata <= mem[...]) -> RAMB36 x4
    合计 BRAM = 8 块; 纯行为级推断, 不例化任何厂商 IP (为紫光同创保留)
    ## 宏语义反转 (从"可选特性"变成"默认路径")
    旧: 定义 IMEM_REG_READ -> 寄存读; 不定义 -> 组合读
    新: **不定义 -> 寄存读(BRAM, 默认)**; 定义 IMEM_COMB_READ -> 组合读(回退)
    涉及: imem.sv / core.sv (fetch_hold, imem_addr) / fpga/build.tcl /
    fpga/build_ila.tcl / tools/fpga_workflow.py (verify+synth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
    [coremark.csv]
2026-10-07 feat(fmax): 58.9 -> 69.2 MHz (+17.5%), 零 IPC / 零面积代价; 上板已验证
    ## 起点
    交付配置(imem/dmem 全 BRAM) 58.9 MHz / WNS 3.022。100MHz 需数据通路 <=9.5ns,
    当时 16.35ns -> 要砍 7.1ns(43%)。
    ## 关键认识: 关键路径不是"某一级流水线", 而是同一拍串了三级
    起点 = dmem 的 BRAM 输出寄存器; 终点 = imem 的 BRAM 地址脚;
    中间 **0 个触发器**(已用路径上完整 cell 清单证实) -> 所以三段组合逻辑必须
    在一个周期内跑完:
    WB 段(字节提取+wb_data mux) -> EX 段(前递+分支+预测校验) -> IF 段(pc_target/pc_next)
    两处"故意"的跨级耦合(都是为不牺牲 IPC): 见 results/p3-fmax.md 实验 C。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
    [coremark.csv]
2026-10-07 docs(fmax): 实验 D 负结果记录 + 两个关键测量 (load 占周期 14%)
    优化目标已改为"处理器性能(吞吐 = CM/MHz x fmax)", LUT 不再是约束。
    第一步就做"解耦 WB->EX 跨级链"(即原 LOAD_RESULT_REG 路线)。
    ## 尝试与结果: 失败, 已回退
    做法: load 在 MEM 多停一拍 (hazard_unit 新增 lu_hold=寄存 load_use, 纳入
    pipe_stall/hold_mem), 写回/前递改成恒取寄存器版。
    结果: 回归 PASS 11 -> PASS 4, tb_core_basic 第 3 组 (lb -> li -> bne) 挂。
    根因: dmem 是寄存读, 数据比地址晚一拍 -> mem_load_data 只在 load 的 WB 拍有效,
    而 MEM/WB 是在 load **离开 MEM 那一拍**锁存的 -> 恰好早一拍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
    [coremark.csv]
2026-10-07 docs(fmax): 实验 E5 负结果 -- 省掉 BR/JAL 目标校验反而 -6.2% (STA 只看最坏路径)
    记录一次有理论依据但实测净亏的尝试:
    理论: BR/JAL 目标 = pc+imm, 对同一 PC 是常量; BTB 有 vld+tag, 命中即说明该表项
    被真实控制流写过 -> 目标必正确 -> 那条 32 位比较(路径上 5 级 CARRY4)多余;
    JALR 目标随 rs1 变, 必须保留比较。
    改法: pred_ok 加 || (id_ex_ctrl.pc_sel != PC_JR) 放行非 JALR。
    实测: 回归 PASS 11, ticks 423527 不变(语义确实没变), 但 **fmax 69.2 -> 64.9 (-6.2%)**。
    原因: 省掉 BR/JAL 后关键路径转到 JALR(仍要做同一比较), 新加的选择项又串了一级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
    [coremark.csv]
2026-10-07 docs(fmax): 实验 E6/E7 -- 零 IPC 代价的旋钮已探尽, 69.2 MHz 是上限
    | 配置 | fmax |
    | CLOCKREGION_X1Y0:X1Y3 (当前交付) | 69.2 |
    | CLOCKREGION_X0Y0:X0Y3 (换左列) | 66.5 (更差) |
    | X1Y0:X1Y3 + CONTAIN_ROUTING=1 | 69.2 (与不加完全相同) |
    加上此前试过的 ExtraTimingOpt / AltSpreadLogic / 更紧 Pblock(66.9 / 64.2)
    -> 零 IPC 代价的手段全部试完, 69.2 MHz 就是天花板。
    当前路径形态: dmem BRAM 输出(3.5ns) -> LSU 提取 -> wb_data/前递 -> 分支比较
    -> pred_ok/redirect -> BTB 目标 LUTRAM + pc_target 优先级 mux -> pc_next
    -> imem BRAM 地址脚(最后一跳 1.25ns)。route 8.926ns(64%), logic 18 级/5.045ns。
    要再往上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
    [coremark.csv]
2026-10-07 docs(fmax): 实验 F -- 路线 A' 做出来了(PASS 11)但净亏 -4.8%, 已回退; 关键结论: 本核瓶颈已转为布线
    ## 做法(3 处改动)
    - load_store_unit.sv: 新增 ld_first/ld_hold, 每次 load 在 MEM 多占一拍
    - load_store_unit.sv: WB 影子寄存器锁存条件加 || first_mem_cyc (多周期序列第一拍就锁规格)
    - core.sv: WB_MEM 写回/前递恒改为寄存器版 (mem_wb_load_data)
    中间踩坑: 第一版漏了影子寄存器那条 -> tb_core_basic 第 4 组(非对齐拆分访存)挂
    (原设计拆分访存的提取是在 WB 拍做的, 改成"离开 MEM 那一沿"后规格还没就绪); 补齐后 PASS 11。
    ## 实测
    | 指标 | 基线 | A' | A'+更多扇出约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
    [coremark.csv]
2026-10-07 docs(fmax): 实验 G -- 路由策略试尽; 零 IPC 代价上限确认 69.2 MHz (三类旋钮全部封顶)
    | route_design -directive | fmax |
    | AggressiveExplore (默认) | 69.2 <- 最佳 |
    | NoTimingRelaxation | 69.2 (相同) |
    | HigherDelayCost | 69.1 |
    | Explore | 68.2 (更差) |
    至此三类"零 IPC 代价"旋钮全部试完并封顶 69.2 MHz:
    - 布局策略: WLDriven / ExtraTimingOpt / AltSpreadLogic_high -> WLDriven
    - 物理区域: 自由 / X1Y0:X1Y3 / X1Y0:X1Y2 / X1Y0:X1Y1 / X0Y0:X0Y3 / CONTAIN_ROUTING -> X1Y0:X1Y3
    - 布线策略: 上表 -> AggressiveExplore
    - 逻辑改写: pred_ok 直接比较 + max_fanout(3 组) 有效(58.9->62.8); 省 BR/JAL 目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
    [coremark.csv]
2026-10-07 docs(fmax): 实验 H -- 综合器重定时是空操作; fmax 探索的完整结论
    synth_design -retiming 实测逐位相同 (fmax 69.2 / LUT 2820 / FF 1345 / ticks 423,527):
    Vivado 一个触发器都没搬。原因: 本设计大量使用异步复位
    (always_ff @(posedge clk or posedge rst), 重定时不能跨异步复位移动寄存器),
    加上 BTB/RAS 的 initial 表项 -> 可动空间为零。工具自动切链这条路走不通。
    ## 完整结论: 本设计 fmax 的全部实测
    | 类别 | 数量 | 最佳 |
    | 布局策略 | 3 | WLDrivenBlockPlacement |
    | Pblock 区域 | 5 | CLOCKREGION_X1Y0:X1Y3 |
    | 布线策略 | 4 | AggressiveExplore |
    | 逻辑改写 | 3 | pred_ok 直接比较 + max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
    [coremark.csv]
2026-10-07 docs(fmax): 实验 I -- 定向 floorplan 也无效; 物理空间确认探尽 (Pblock 共 7 种)
    ## 先测出真实坐标 (数据驱动)
    tools/_map_cr.tcl 把关键路径站点映射到时钟区:
    dmem RAMB36_X1Y13 -> X1Y1
    LSU/ID-EX/EX-MEM/MEM-WB (SLICE_X71..X82 Y54..Y69) -> X1Y1
    imem RAMB36_X1Y4 -> X1Y0
    PC/redirect/BTB (SLICE_X61..X73 Y38) -> X1Y0
    => 关键路径在中途跨了一次时钟区(数据通路全在 X1Y1, 取指侧与 imem 在 X1Y0)。
    理论上"把整核压进 X1Y1 一个区"能消掉这次跨界。
    ## 实测: 反而明显更差
    | Pblock | fmax |
    | CLOCKREGION_X1Y0:X1Y3 (交付) | 69.2 |
    | CLOCKREGION_X1Y1:X1Y1 (数据通路所在单区) | 67.4 |
    | CLOCKREGION_X1Y1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
    [coremark.csv]
2026-10-07 docs(fmax): 实验 J -- trap/mret 让路实测失败(tb_core_trap 挂), 已回退; 根因未完全定位
    ## 做法 (core.sv 两处)
    - u_pc: .flush(1'b0) -> .flush((trap_enter||mret_taken) && !pipe_stall);
    .flush_pc(trap_enter ? trap_vector : mret_pc) (pc.sv 本来就预留的端口)
    - pc_target: 4:1 优先级 mux -> 2:1 (redirect ? actual_target : pred_target)
    改前逐条核过安全性: pc.sv 的 flush 优先于 stall 与 pc_src; pc_target[1:0] 自检仍为 0。
    ## 实测: tb_core_trap 第 1 组挂 (其余 10 项 PASS)
    cycle 24 | mret 在 EX (ex_pc=0x800000ec)
    cycle 25 | pc 落到 0x00000000 (应为 mepc!) -> 取到非法指令 -> 触发陷阱进 0x80000028
    根因: 两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
    [coremark.csv]
2026-10-08 docs: CODE-MAP.md 代码地图与阅读路线 + tools/trace_diff.py 逐拍轨迹比对工具
    ## CODE-MAP.md
    给出"读代码的向导": 一句话架构、三遍阅读顺序(骨架/控制/深入)、
    21 个 RTL 文件逐个的阅读要点、core.sv 886 行的章节-行号地图、
    工具链清单、文档索引、当前交付指标基线。
    ## tools/trace_diff.py
    诊断工具: 把两个日志里的 tb_core 逐拍 trace 对齐, 报出**第一处分歧**及分歧字段。
    动机: 实验 D/E5/J 三次"理论等价、实测失败"都卡在"不知道从哪一拍开始跑偏"。
    用法: python tools/trace_diff.py <基线.log> <待检.log> [--context N]
    退出码 0=逐拍一致, 1=有分歧。
2026-10-08 feat(pipeline): 4 级流水 (issue #5) —— 删掉 if_id_reg, 全部指标同时改善; 已上板验证
    ## 收益 (全部指标同时变好, 罕见)
    | 指标 | 基线 | 4 级 | 变化 |
    | CoreMark/MHz | 2.3611 | 2.4209 | +2.53% |
    | ticks | 423,527 | 413,070 | -2.47% |
    | fmax | 69.2 | 69.5 MHz | +0.43% |
    | LUT / FF | 2820/1345 | 2769/1234 | -51 / -111 |
    | CoreMark/LUTs | 8.373e-4 | 8.743e-4 | +4.42% |
    | 绝对吞吐 | 163.3 | 168.4 | +3.12% |
    - u_if_id 实例 -> **组合别名** (if_pc=pc, if_instr=imem_rdata, ...):
    保留这几个名字 => tb_core 的逐拍 trace 与 tb_sw 的取指对齐自检**一行都不用改**,
    不变量 imem_rdata(N)==mem[pc(N)] 完全不变。
    - i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
    [coremark.csv, ila_done.csv]
2026-10-08 chore: 不入库 cm_hw 的 1200 迭代备份 (*.bak 加进 .gitignore)
2026-10-08 docs(口径): 更正为"仍是 5 级流水线"; 去掉的是**冗余 IF 寄存器**, 不是一级流水
    ## 为什么要更正
    实施 issue #5 时我把"流水寄存器个数"当成了"流水级数", 差一。
    教科书 5 级在 pc 之后只有 **4 个**寄存器 (IF/ID, ID/EX, EX/MEM, MEM/WB)
    —— **4 个寄存器 ⇒ 5 级** (IF 级的工作发生在 IF/ID 之前)。
    | | pc 之后的指令寄存器 | 级数 |
    | 教科书 5 级 (imem 组合读) | 4 | 5 级 |
    | 本核**改动前** (imem 是 BRAM 同步读) | **5** (IMEM 输出寄存器 + if_id_reg + 3) | **6 级** |
    | 本核**改动后** | **4** (IMEM 输出寄存器充当 IF/ID + 3) | **5 级** |
    => 本核**始终是 5 级**; 改动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
2026-10-08 fix(core): 注释口径残留 (4 级 -> 5 级, id_valid -> id_en) + 重建 bitstream
    [coremark.csv]
2026-10-08 docs/style(pkg): 扫尾 issue #1 / #2 / #3 / #4 (全部有实测或证据支撑的更正)
    ## #1 docs(pkg): 头部【数据通路接线契约】与 RTL 矛盾 -> 已更正
    - 第 2 条"ALU 兼职目标加法器": 实际已改用**专用加法器** (core.sv:517-536, P3 优化),
    改后契约直接写明现实现与代价来源 (results/p3-fmax.md 实验 A)。
    - 第 3 条 "pc_src = (pc_sel==PC_BR && branch_taken) || ...": 加入**分支预测**后
    redirect 语义变成"预测错了", 现实现是 pc_src = any_redir || pred_taken。
    - 段首加限定: 本契约描述**单周期基线**, 5 级流水实现以 core.sv 为准。
    - 连带清理: **删除 alu.sum_out 端口与 core.sv 的 ex_sum*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
    [coremark.csv]
2026-10-08 docs(core): 审阅自查 —— 修掉 2 处随 if_id_reg 删除而过时的注释
    1) dbg_pc/dbg_id_pc 段: 原注"单用 if_pc 则 if_id_reg 在 flush 那拍会把它清成 0"
    已随 if_id_reg 删除而失效 (if_pc 现在只是 pc 的组合别名, flush 期间不再被清 0,
    诊断信息反而更完整)。已更新说明并保留历史原因。
    2) ID 段门控的"❌ 错误做法"示例里写的 id_valid 已不存在 (现名 id_en),
    改成实际信号名, 避免读者去找一个不存在的标志。
    纯注释改动, 无功能影响; 重建 bitstream 以保持 check 的新鲜度判定。
    [coremark.csv]
2026-10-08 fix(core): 修掉今天引入的回退配置致命 bug (id_en 引用 ifdef 内声明的 boot_done); 并修 sim/run.bat|sh 清单
    ## 真 bug (审阅抓到, 必坏)
    core.sv: ssign id_en = boot_done; 是无条件的, 而 oot_done **只在
    ifndef IMEM_COMB_READ 分支里声明**。一旦定义 IMEM_COMB_READ (官方回退开关,
    build.tcl:77-79 / fpga_workflow.py 的 --imem_comb_read / verify 都支持它):
    -> oot_done 成为未声明标识符 -> ModelSim
    log -sv 直接报错 (全 11 项 FAIL),
    若被当隐式 1 位 net 则 id_en 恒 0 -> **全核每拍译码成 NOP, 整机跑死**。
    修法: 把 logic boot_done; 移出 ifdef, 组合读分支里 ssign boot_done = 1'b1;
    (组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
    [coremark.csv]
2026-10-08 docs: 全面同步交付口径 (子代理审阅产出) —— 指标/流水线口径/已完成状态/文件树/行号
    - README/CODE-MAP/HANDOFF/HANDOFF-WORKFLOW/HANDOFF-HW-LOOP/gap-analysis/
    analysis-report/tools/README: 指标统一为 2.4209 / 69.8MHz / 2649LUT / 1234FF /
    9.139e-4 / 169.0; 上板 1300 迭代 / 536,943,384 / 10.74s; 回归 PASS 11
    - 流水线口径统一为「始终 5 级; IF/ID 由 IMEM 输出寄存器承担」
    - 修正大量「已完成却说未做」: A扩展(RV32A)已打通 / IMEM_REG_READ 已转默认 /
    P2 定时器中断已完成 / Cache 是分析判定无收益 / 取指停顿失步那个判断已被推翻
    - 修正自证串: ILA_BUILD_IMEM_REG_READ=1 -> ILA_BUIL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
2026-10-08 fix: 修掉 2 个审阅发现的真 bug (csr_file 位错位 / gemm arena 地址) + 流水线口径写进 core.sv 头部
    ## 1) 口径: 本核**始终是 5 级** —— 已在 core.sv 头部写成权威说明
    core.sv 顶部原来写着两处错的 (审阅 B1/B2 也报了):
    - "IF : PC -> imem (组合读)" -> 默认其实是寄存读/BRAM, 其输出寄存器即 IF/ID
    - "重定向冲刷 IF/ID 与 ID/EX 两级 (2 周期惩罚)" -> 已只冲刷 ID/EX 一级, 惩罚 1 拍
    现在 header 里加了一节【流水线级数的口径 —— 最容易差一的地方】, 讲清:
    教科书 5 级在 pc 之后只有 **4 个**寄存器 => 4 个寄存器 ⇒ 5 级; 本核此前因为
    imem 是 BRA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
    [coremark.csv]
2026-10-08 chore(main): 回到 main 后重建 bitstream (切分支刷新了 muldiv.sv 的 mtime, check 判旧)
    内容与构建时一致, 属 mtime 假象; 重建以符合 R1 新鲜度纪律, 并复确认交付指标:
    CoreMark/MHz 2.4209 / fmax 69.6 MHz / LUT 2653 / FF 1234 / BRAM 8 /
    CoreMark-LUTs 9.125e-4 / 绝对吞吐 168.4
    check exit=0; 回归 默认 PASS 11 + --imem_comb_read PASS 11
    [coremark.csv]
2026-10-08 docs(pitfalls): 新增 R36/R37/R38 (来自 ref5 参照核与 radix-4 实测的通用结论)
    R36. **瓶颈是布线** -- 这个结论被一个完全不同的设计独立重现了:
    主核(2820 LUT) route 64~80%; 参照核 ref5(852 LUT/普通5级RV32I/无前递无预测)
    route 62.4% (4.215/6.760ns), 而 4 级逻辑只占 2.545ns。
    => 不是主核特有, 是器件+这类设计的普遍规律。优化前先量 route/logic 占比;
    布线占大头时"砍逻辑"的收益会被布线吃掉(见 P8 实验 F: 砍 2.5ns 逻辑只换回 0.81ns)。
    R37. 三条与直觉相反、但已在两个设计上重复验证的物理结论:
    1) Pblock 收紧更差: ref5 137.25 -> 129.20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
2026-10-08 E5 移植主核: **负结果, 已回退** -- max_fanout 的收益是位置特定的
    ## 实测 (主核)
    | | 基线 | E5 移植后 (id_ex_reg.sv rs1_data/rs2_data 加 max_fanout=16) |
    | fmax | 69.6 MHz | **68.8 MHz (-0.8)** |
    | LUT | 2653 | 2684 (+31) |
    | **FF** | 1234 | **1234 (一字不变 -> 属性没触发复制)** |
    | 吞吐 | 168.4 | 166.6 (-1.1%) |
    => 主核这个位置加属性 = 只带来布局扰动, 没有任何复制收益。**按纪律回退**。
    ## 为什么和 ref5 相反
    ref5 的成功点不在"ID/EX 操作数寄存器"这个名字上, 而在**那根网真的有 115 个负载**
    (ex_b[3], 单网 3.0ns): 加属性 -> FF 458->554(**真的复制了**) -> +8.50MHz。
    主核同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
    [coremark.csv]
2026-10-08 fix(main): 从 main 移除误提交的 ref5/ 参照核产物 (它们属于 ref5-yardstick 分支)
    上一个提交 (2e91572) 用 git add -A 时, 把 ref5/runs/** 等参照核产物一起提交到了 main。
    根因: ref5/.gitignore **只存在于 ref5-yardstick 分支上**, 切回 main 后 ref5/ 变成
    "未跟踪且未被忽略", 于是被 git add -A 收进来。
    main 是**竞赛提交分支, 必须干净** -> 本次从索引与工作区移除整个 ref5/。
    保留: 上一个提交里的 PITFALLS R37 第 4 条 (max_fanout 位置特定, 主核 E5 负结果) 是正确的, 不动。
    ref5 源码/报告在 ref5-yardstick 分支上完好 (8ef1905); 逐版本 runs/ 是可再生产物。
2026-10-08 docs(pitfalls): 修正 R36/R37 的两处数字口径与归因错误 (复核产出), 并指向新工具与剧本
    ## 修 1) R37 第 3 条的归因错误 (明确错误)
    原文把"−30.9% LUT 但 fmax 也降"归给 P8 —— **错的**:
    P8 实测 LUT 2820→2769 (**−1.8%**) 而 fmax 是 **69.2→69.5 (升)**;
    −30.9% 属于 p6-a-*(4079)→ ram-*(2820) 那一族**同时改了多件事**的跳变。
    => 新增纪律: **跨 tag 相减两行 CSV 不是 A/B**, 只有单变量 A/B 才能支撑因果归因。
    ## 修 2) R36 的 "0.81 ns" 口径不清 (与同段原始数字矛盾)
    同段给出 13.971→12.617, 但正文写"只换回 0.81 ns" -> 系数差 1.7 倍。复核后的正确分解: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
2026-10-08 feat(fmax): 主核 69.6 -> 71.8 MHz (+3.2%) — X1 按 fo 定向复制 any_redir; 并沉淀全局优化系统
    ## 成果 1: 主核 fmax +2.2 MHz (X1, 数据驱动)
    改动只有一处: core.sv 的**组合网** ny_redir 加 (* max_fanout = 16 *)。
    - 依据: 按 **fo** 找抓手(不按名字)。基线 top-50 里 ny_redir **fo=122 / 单跳 0.70~0.98ns**,
    100% 路径都过它; 而 pc_src/redirect/redirect_raw/actual_taken **已有** max_fanout=16、
    已不在 fo 榜上 —— 唯一漏掉的正是它。
    - 效果: **LUT +15 (真复制), FF 不变**; fo=122 那一跳**整条消失**;
    69.6 -> **71.8 MHz**, 绝对吞吐 168.4 -> **173.8**; 3 次综合逐位一致; PASS 11; check exit=0。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
    [coremark.csv]
2026-10-09 docs(pitfalls): 新增 R41 -- 多写入者并行时, 建像前后各记一次源文件哈希 (实战截住一次)
    场景: 本会话有并行子代理在同一工作区改 RTL。我在建 ILA 像(约 5 分钟)期间, 子代理开始改
    core.sv 等文件 => 该 bitstream 是"混合版本", 不知道对应哪一版 RTL。
    防御: 建像前把所有 *.sv 的 sha256 拼成串记下, 建像后再算一次; 不一致就**丢弃这个 bitstream,
    绝不上板**。本次实证: 前 -1746299588 / 后 -1681212344 -> 不一致 -> 跳过编程与抓取 ✓
    (否则会得到一个"不知道是哪一版"的上板结论, 而且它看起来一切正常 -- 与 R20 同类)。
    配套: 同样适用于 synth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
2026-10-09 fix: 修正 coremark.csv 的错配行 + 新增 PITFALLS R42 (三个计数器口径坑)
    ## CSV 数据瑕疵修正
    results/coremark.csv 的 jal-ifdec-c 行: lut/ff/fmax (2688/1234/68.8) 是 JAL 静态预测配置,
    但 ticks/cm_per_mhz (410688/2.4349) 被 --record 误取为当时的 RAS 配置日志 -> 错配。
    按 CM/MHz = 1e6/ticks 回填 B 的真值: ticks 411725 / cm 2.4288, 并在 note 里留下修正说明。
    (复现性权威证据仍是两次强制重跑 WNS 逐位一致: 5.458。)
    ## 预测器方向最终结论 (子代理交付, 已全回退)
    基线 core.sv/ras.sv 逐字节还原, bitstream 重建后逐位还原基线:
    CM/MHz 2.4209 / fmax 71.8 / LUT 2668 / FF 1234 / ticks 413070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
    [coremark.csv]
2026-10-09 data(mul): 乘法器启动拍专项 -- S0 证真 + S2 逐位兑现 ticks 但 fmax 代价更大, 全部回退
    ## S0 实测真值 (与 R38 一致: 窗口内 0 条除法)
    MUL 执行 9564 条 (全是 MUL, 无 MULH*), 每条恰好占 1 拍 busy;
    计时区间内 **9424 拍 = 413070 的 2.281%**; 全程 md_busy 14415 = 9564(乘)+4704(除迭代)+147(除启动) 逐项对账。
    背靠背 MUL = 0 次。
    ## 方案对照 (吞吐 = CM/MHz x fmax; S2 的 break-even 是 fmax >= 70.16MHz)
    | 配置 | ticks | CM/MHz | fmax | LUT | FF | 吞吐 | 判定 |
    | 基线 HEAD | 413070 | 2.4209 | 71.8 | 2668 | 1234 | 173.8 | KEEP |
    | S3 muldiv 内局部 max_fanout | 413070 | 2.4209 | 64.8 | 2778 | 1234 | 156.8 | 回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
    [coremark.csv]
2026-10-09 feat(clk): MMCM 原语把系统时钟提到 70.000 MHz + 上板迭代 1300->3000 (已授权, 待上板验证)
    ## 结果
    | 构建 | WNS @14.286ns | fmax |
    | 无 ILA | +0.659 MET | 73.41 MHz |
    | 带 ILA | +0.901 MET | 74.72 MHz (ILA 不在关键路上) |
    3/3 逐次综合 WNS/LUT/FF 逐位相同; 两条 verify PASS 11; check exit=0。
    ## 改动
    - fpga/top_a100t.sv: MMCME2_BASE 原语 + BUFG (不用 IP, 避开 R33)。
    Fvco = 50 x 21 / 1 = 1050.000 MHz (MMCME2 合法区间 600~1200, PFD 50MHz 合法);
    Fclkout0 = 1050 / 15 = 70.000 MHz 精确。LOCKED 参与复位释放。
    - fpga/daVinciPro.xdc: 输入晶振仍 20.000ns; MMCM 输出加 create_generated_clock
    (-multiply_by 7 -divide_by 5)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
    [coremark.csv]
2026-10-09 fix(clk): 修 MMCM 漏接 .CLKFBIN 的致命断路 -- 70MHz 版上板复活并验收通过
    ## 根因 (R43)
    MMCME2_BASE 实例的端口表里**漏了 .CLKFBIN**: CLKFBOUT 驱动了 clk_fb 但没有送回 CLKFBIN
    => 反馈环开路 => PLL 永不锁定 => LOCKED 恒 0 => 门控在 LOCKED 上的复位**永远按住 CPU**。
    现象极具迷惑性: 2048 个 ILA 样本全是 ila_ctrl=0x00 / score_result=0, dbg_pc **冻结在复位向量
    0x80000000**, 但 dbg_instr **能读出合法指令** => 时钟其实在跑, 是复位没释放。
    它不是综合错误, 只有一条 [Timing 38-1] CRITICAL WARNING(极易被当成"内部反馈的标准提示"放过)。
    修复后 [Timing 38-1] 计数 7 -> **0**,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
    [coremark.csv, ila_done.csv]
2026-10-09 feat(flash): QSPI Flash 烧录打通 (逐字节校验通过) + PITFALLS R44/R45/R46
    达芬奇Pro 板载 QSPI Flash 现在装的是**我们的 SPIx4 镜像**, 16MB 全读回逐字节比对通过:
    VERDICT=PROGRAM_OK VERIFY=PASS
    (前 3,825,788 字节完全一致; 镜像之后 0 个非 FF 字节)
    可复现: powershell -File tools\flash_boot.ps1 -Bit <bit> -Iface SPIx4|SPIx1
    (预载 SPI accessor -> write_cfgmem 生成镜像 -> 编程 -> **读回全片 diff 自校验**)
    ## 两个真根因 (part 名那条线是幌子)
    1. **SPI flash accessor 设计没有被加载进 FPGA**:
    纯 Tcl 流程里 program_hw_cfgmem 不会自己加载它 => hw_server 日志
    C 77 XicomFlash over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
    [sweep_results.csv]
2026-10-09 data(rr): 重定向核心重排未达标(净0.000MHz), 全回退 + PITFALLS R47 (top-N 是"一堵墙"时逻辑重排期望≈0)
    目标 +1.3MHz (WNS 0.694 -> >=0.930) **未达成, 实际 0.000 MHz**; 4 个 RTL 改动全部更差/空转, 已全回退。
    RTL 现与 HEAD 5bd8e37 逐字节相同; 基线 3/3 逐位复现 (WNS +0.694 / fmax 73.57 / LUT 2666 / FF 1234 /
    BRAM 8 / DSP 8 / CM-MHz 2.4209 / ticks 413070 / verify PASS 11)。
    ## 最重要的发现: top-50 是"一堵墙", 不是两条路
    50 条 setup 路径**源端全部相同**(u_dmem/mem_reg_3/CLKBWRCLK), 目的全同族(imem/ADDRARDADDR[*]);
    top1=0.694 top2=0.752 => **Δ 只有 0.058ns** => 只修 top-1 的收益上限 ≈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
    [coremark.csv]
2026-10-10 feat(fmax): LSU 读格式化字节通道 + Pblock/放置指令重定位 -- 73.57 -> 74.64 MHz (+1.07), 4/4 逐位复现
    ## 结果 (70MHz 约束, fmax = 1000/(14.285714-WNS) 手算)
    | 配置 | WNS | fmax | LUT | FF | verify |
    | 基线 HEAD | +0.694 | 73.57 | 2666 | 1234 | PASS 11 |
    | ① LSU 字节通道 (单独) | +0.519 | 72.64 | 2667 | 1234 | PASS 11 | 回退 |
    | ② Pblock 重定位 (单独) | +0.669 | 73.44 | 2669 | 1234 | - | 回退 |
    | ①+② | +0.852 | 74.44 | 2669 | 1234 | PASS 11 |
    | **①+②+ExtraTimingOpt (交付)** | **+0.888** | **74.64** | 2667 | 1234 | **PASS 11** | **KEEP, 4/4 逐位复现** |
    (另扫 10 组 Pblock/指令全部劣于交付版; 目标 74.87 差 0.31MHz)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
    [coremark.csv]
2026-10-11 fix(metrics): 修 fmax 口径 + 度量链 5 处静默失效 (M-01/M-02/M-03/X-01~X-07)
    M-01/X-01 fmax 取错 slack: parse_reports() 用正则抓 sys_clk 行, 但引入 MMCM 后核心跑在
    sys_clk_70, sys_clk 行已无 setup 端点 -> 正则跨过空列抓到**脉宽余量 WPWS=7.000**,
    再按硬编码 period=20.0 换算 => 报 76.92 MHz (真值 74.64)。更糟的是 2026-10-09 起
    30+ 次综合的 fmax 恒为 76.92 -> 指标对 RTL 时序变化零敏感。
    改为从**最差 setup 路径块**取 (Slack, Requirement, Path Group), fmax=1000/(T-WNS),
    并把时钟名/周期/推导式一起打印出来。
    复算验证: 20261011-004830 -> 74.64; 20261008-203550 -> 69.81 (MMCM 之前,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
2026-10-11 fix(core): 中断精确性两处架构缺陷 —— mepc=0 与被抢占指令双执行 (R-01 + R48)
    R-01: 中断可在流水线气泡上被接受 -> mepc=0
    irq_take 缺"EX 段指令有效"判据(对比 exc_req 靠 id_ex_ctrl.illegal/sys_op 间接保证);
    id_ex_reg 在 flush/bubble 时把 pc 清 0 => irq_pending 撞上 load-use 停顿/重定向产生的
    气泡那拍, trap_enter 成立而 mepc <= id_ex_pc = 0; 同时 any_redir 把 ID 里那条真指令
    永久丢弃; MRET 后 PC=0, 而 imem 忽略高位地址(只用 addr[13:2]) => 从程序开头重跑。
    修法: id_ex_reg 新增 valid 位(rst/flush/bubble->0, !stall 时取 id_en), irq_take 与它相与。
    复现(修前): verify --f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
2026-10-11 docs: 同步审查发现的 7 类文档缺陷 (D-04/D-05/D-06/D-07/D-11/D-13/V-03)
    D-04 README 的"跑测试"入口: sim\run.bat 硬依赖本机**不存在**的 iverilog
    (%LOCALAPPDATA%\riscv-tools\mingw64 不存在, Get-Command iverilog NOT FOUND),
    且只跑 2/11 却打印 ALL TESTS PASSED; 而 HANDOFF 又写"没有 iverilog"(自相矛盾)。
    入口改为 python tools\fpga_workflow.py verify; run.bat/sh 降级为历史留档并列出三条实证缺陷。
    D-05 CODE-MAP.md 的 core.sv 章节地图行号系统性偏 +35~+40 (core.sv 1038->1087 行, 移动靶)。
    全部锚点按 1087 行重算, 并把整张表标成"快照(会过期)" + 附两条重算命令。
    D-06 PITFALLS 已到 R4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
2026-10-11 chore(repo): 大二进制出库 (62.66 MiB) + .gitignore 修回合法 UTF-8 (E-01)
    `git ls-files` 显示仓库跟踪了 60.9 MB 二进制, 而**全部源码只有 3.2 MB** ——
    155 个跟踪文件里 8 个大文件占了 95% 体积。这些全是**可再生成的构建产物/日志**:
    .mcs 由 tools/flash_mkimage.tcl 重建; readback.bin 是烧录回读日志;
    guide_text.txt 是厂商 PDF 的抽取文本; accessor/*.bit 是 flash 探针镜像。
    出库 14 条 (62.66 MiB; 逐条 `git check-ignore --no-index` 确认已被忽略, 文件仍在磁盘):
    fpga/cpu_a100t{,_spix1,_spix4}.{mcs,prm,bin}
    tools/flash_logs/readback.bin (16.0 MB)
    tools/flash_logs/guide_text/gu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
2026-10-11 fix(tools): 接入 build-repo 的构建脚本接口 (X-06/X-09 配套) + [HIL] 假新鲜度
    五个配套改动 (全部在 Lead 自己的文件里):
    1) parse_tcl_list() 认识 `$root/` 前缀。build.tcl / build_ila.tcl 去硬编码后改成
    `$root/xxx.sv` (root 由 [info script] 反推), 而解析器只认裸文件名 =>
    check 第 [1] 项对每个文件同时报"缺 X.sv"与"多 $root/X.sv", **88 个假 FAIL**,
    整道门被自噪声淹掉。归一化后三个清单恢复 OK (22/22/20)。
    2) mk_cm_hw.py 写 sim/prog/cm_hw.build.json (X-09 单一来源)。此前
    ITERATIONS / 预期 tick / 等待秒数 / 时钟 散落在三处**手工同步**的魔数里
    (ila_cap_done.tcl 的 a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
2026-10-11 fix(rtl): W-04 LR/SC 规范语义 + R-01/R-02 回归用例
    【注意: R-02 的 RTL 部分已随 4186f13 落入仓库历史】
    4186f13 的提交信息只写了 R-01 + R48, 但当时 rtl-fix 正在同一批文件里写 R-02,
    所以那次 commit 实际**已经包含** R-02 的 RTL(id_ex_instr + trap_tval + R-01 断言)。
    本 commit 补上三条回归用例并如实记录这次"卷带" —— 不改写历史(本地提交且其后已有多个
    commit, 多写入者下 rebase 风险太大), 改为让历史可追溯。
    W-04 LR.W / SC.W —— 按 RISC-V 规范允许的**恒失败**实现:
    LR.W: 等价普通字加载 (rd = 读回的字), **不写内存**。
    SC.W: **不写内存**, rd 恒为 1(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
2026-10-11 fix(sw): 让回归的绿灯真的意味着通过 (W-01/W-02/W-03/W-05~W-07/W-09~W-11)
    W-01 (P0) 三程序把结论编码进 tohost —— 此前 tb_sw.sv 无条件打印 "RESULT : PASS",
    TB 只在 tohost==1 / tohost∉{0,1} / dbg_illegal / 超时 四种情况下判断, **从不检查
    程序算出来的结果**; 而 hello/nn_demo/CoreMark 都只把结论"打印"出来。于是 11 项回归里
    有 3 项在结果错时仍然是绿灯(含 CoreMark 与 GEMM 神经网络), README 的"逐位 CRC 匹配"
    "逐元素一致"证据链实际靠人眼看输出。
    现在: 成功写 1, 失败写 2 并自旋(防 crt0 在 main 返回后再写 1 覆盖)。
    **tb_sw.sv 的判定逻辑一行未改**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
2026-10-11 fix(tools): 度量链接口对齐 + 综合警告门 + 等价性检查接入回归
    接 build-repo(task-5)/sw-verify(task-3)/rtl-fix(task-2) 交给 Lead 的接口:
    1) test_matrix 给 tb_units 加 "defines": ("A_EN",) —— W-09。矩阵原来给它是空 defines,
    于是那 26 条 AMO 译码 chk() 是死代码。并把 desc 里写死的 "194 项单元检查" 删掉
    (检查点数以**运行时打印**为准 —— 这是本工程自己的口径)。
    2) verify 的 crashed 判据扩展 ERROR! / Errors detected / Cannot validate operation ——
    W-10 配套。CoreMark 的 CRC 不匹配打的是 "ERROR! list crc ...", 既不是 "** Error"
    也不是 "Fatal", 原来会绿灯通过。
    3)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
2026-10-11 fix(fpga): 构建/上板流程加固 —— 时序门 + 单一来源清单 + 采集见证 + 可移植路径 (X-06/X-09/X-10/E-02/E-03)
    E-02 去硬编码: build.tcl / build_ila.tcl / ila_cap_done.tcl / ila_cap_mark.tcl 里的
    `D:/USER/Desktop/FPGA/FPGA` 全部改为 `set root [file normalize [file join
    [file dirname [info script]] ..]]` 派生。此前换机器/换目录即失败, 与"迁到紫光同创
    只需重写顶层与约束"的可移植性目标直接矛盾。build.tcl 顺带全文转纯 ASCII
    (原 1736 个非 ASCII 字节 —— R21 的隐患)。
    X-06 时序收敛门: build.tcl 在 report_timing_summary 之后、write_bitstream 之前断言
    时序。判据 = Vivado 自己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
    [ila_done.csv]
2026-10-11 docs(plan): CODE-REVIEW-PLAN §6 补齐最终数字与上板验证结果
    - §6.3 换成**冻结后**的权威数字（来源: .fpga-cache/reports/20261011-111332-cm_hw +
    results/coremark.csv 行 review-fixes-v1 + results/ila_done.capture.json）
    fmax 74.4 MHz / LUT 2736 / FF 1251 / CM-MHz 2.4209 / CM-LUTs 8.848e-4 / 吞吐 180.2
    对比基线: CM/MHz +193.0%, fmax -5.1%, CM/LUTs +274.8%, 吞吐 +178.1%
    - 新增上板实测表: ila_ctrl=0xC2(illegal=0), score_result=0xC9DADA56(bit31=1),
    tick 1,239,079,510 / 17.70 s @70MHz, 硬件 CM/MHz 2.4212(仿真 2.4209, 差 0.01%),
    tick 偏差 0.002%, dbg_pc 稳定在结尾 j . => 上板验证 PASS
    - 如实记录本轮的**代价**: CM/LUTs 9.07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
2026-10-11 docs: 指标口径换代 + R48/R49 + RV32A 措辞 + check 7 项 (task-4 二轮 / task-6)
    数字(VVVVV 全部现查, 来源 .fpga-cache/reports/20261011-111332-cm_hw + results/coremark.csv
    行 review-fixes-v1 + results/ila_done.capture.json):
    CoreMark/MHz 2.4209 | fmax 74.4 MHz (-5.1%) | CoreMark/LUTs 8.848e-4 (+274.8%)
    绝对吞吐 180.2 (+178.1%) | LUT 2736 / FF 1251 / BRAM 8 / DSP 8
    上板: ila_ctrl=0xC2(illegal=0) / score_result=0xC9DADA56(bit31=1) /
    tick 1,239,079,510 (17.70 s @70MHz, 3000 迭代) / 硬件 CM/MHz 2.4212
    偏差: tick vs 预期 0.002%
    D-01/D-02/D-03: README / HANDOFF / CODE-MAP / gap-analysis / analysis-report 全部换代, 并写入
    **两条诚实口径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
2026-10-11 data(coremark): 记录本轮交付配置 review-fixes-v1
    results/coremark.csv 追加一行 (status=keep), 数值来自 .fpga-cache/reports/20261011-111332-cm_hw:
    2026-10-11, review-fixes-v1, iters=1, ticks=413070, CM/MHz=2.4209,
    LUT=2736, FF=1251, BRAM=8, DSP=8, fmax=74.4, keep
    这一行是 **fmax 口径修正后**由工具自动算出并写下的 (M-01), 不是人工修正的。
    历史行的 fmax 列混着两种口径(工具旧值 69.x/76.9 与 22 行人工修正值), 已在
    CODE-REVIEW-PLAN M-04 与本轮文档里标注清楚; 未逐行重算的原因是: 只有部分历史构建
    还留着 timing.rpt 归档, 重算会引入新的不可复核数字 —— 与其造假不如标清口径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
    [coremark.csv]
2026-10-11 docs(results): 新增 review-fixes-v1.md — 本轮审查修复的结论文档
    按仓库惯例(results/hw-verified.md 的格式)落一份结论:
    - §1 最终指标(唯一口径) + 上板实测表; 并写明 "fmax 69.8->74.4 是**口径更正**而非本轮提升,
    对基线真实差距 -5.1%(不是文档原先的 -11.0%)"
    - §2 修了什么: 按 架构级正确性(R-01/R48/R-02/W-04-R49) / 度量链(M-01/X-01/X-02/X-03/X-04/
    X-05/X-07/M-02/M-03/M-06) / 软件验证层(W-01/W-02/W-03/W-05~W-07/W-09~W-11) /
    构建仓库(X-06/X-09/X-10/E-01/E-02/E-03/D-*) 分表, 每条带修前症状与修后证据
    - §3 本轮新增发现: R48/R49/X-08 被警告门直接命中/镜像布局致 ticks 漂 2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
2026-10-11 fix(tools): 缓存命中的数字来源 + 归档 timing_paths + 31 位 tick 闸门
    1) **缓存命中的数字张冠李戴**(与本轮 M-01 同一族, 且是重扫时实测触发的)
    `synth` 的缓存命中分支原来从**磁盘**读 fpga/timing.rpt / util.rpt, 而这两个文件
    **每次构建都被覆盖**; synth-cache.json 只存一个 fingerprint。于是"缓存命中"报出来的
    数字可能来自**另一次**构建:
    跑配置 A -> 报告=A; 跑配置 B -> 报告=B; 再跑 A(命中) -> 读到 B 的报告当 A 的数字。
    实测触发场景就是 §7 的 11 组 Pblock×place 重扫: 扫完之后 fpga/timing.rpt 变成了
    最后一组(无 Pblock, 72.45 MHz)的数字,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
2026-10-11 data(fmax): 新网表 Pblock×place 重扫 11 点 —— 最优未移动, 该轴已穷尽
    背景: build.tcl 的配对表是在 R-01/R48/R-02/W-04 修复**之前**的网表上量的(+69 LUT/+17 FF),
    所以在新网表上重扫了一遍(tools/sweep_pblock_place.ps1, 每点 ~100 s)。
    结果(11 点, 全部记进 results/coremark.csv, status=measure):
    ExtraTimingOpt + X0Y1:X2Y4 / X2Y5 / X3Y4 / X3Y5 -> WNS +0.854 (74.45) **4 组并列最优**
    其中 X0Y1:X2Y4 就是当前 build.tcl 的默认值
    ExtraTimingOpt + X0Y2:X4Y4 / X0Y2:X3Y5 -> WNS +0.616 (73.2)
    ExtraTimingOpt + X0Y3:X3Y6 -> WNS +0.326 (71.6)
    WLDrivenBlockPlacement × 3 组 -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
    [coremark.csv]
2026-10-11 feat(clk): 系统时钟 70 -> 75 MHz —— 只换 MMCM 抽头, 时序收敛并上板 PASS
    【改动】只动两处参数, PLL 结构一行没变:
    fpga/top_a100t.sv CLKOUT0_DIVIDE_F 15.0 -> 14.0
    (CLKFBOUT_MULT_F 21.0 / DIVCLK_DIVIDE 1 **不变** => VCO 仍 1050 MHz)
    50 * 21 / 14 = **75.000000 MHz 精确相等**, 周期 13.3333 ns
    .CLK_HZ 70_000_000 -> 75_000_000 (周期计数器/UART 分频/软件时长口径的单一来源)
    信号 clk_70_raw / sys_clk_70 -> clk_75_raw / sys_clk_75
    fpga/daVinciPro.xdc create_generated_clock -name sys_clk_75 -multiply_by 21 -divide_by 14
    (与 RTL 逐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
    [coremark.csv]
2026-10-11 fix(tools): --status 在正常构建路径被丢弃 + 控制台编码从根上加固
    一、**`--status` 被静默丢弃**(X-04 的漏网之鱼)
    cmd_synth 的**正常构建路径**最后一行 `append_csv(tag, metrics)` 少传了第三个参数,
    于是 `--status keep` 被丢掉, 一律记成默认的 "measure" —— 实测: 想记成 keep 的一行
    真的写成了 measure。X-04 修的是"能不能记 rejected", 这条是"记了但记错",
    同样是**看起来完全正常**的错误 (CSV 里多一行 measure 而已)。
    修法: 传 `args.status`。自证: 重记 `clk75` -> `-> 追加到 results/coremark.csv: clk75 (status=keep)`。
    二、**控制台编码崩溃** —— 表现为"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
2026-10-11 docs(plan): 新增 §8 第三轮提频到 75 MHz + review-fixes-v1 加后续指针
    §8 记录:
    - 改动: 只换 MMCM 抽头(CLKOUT0_DIVIDE_F 15.0->14.0, VCO 仍 1050) => 75.000000 MHz 精确;
    为什么这样风险低(不引入 PLL 锁定/VCO 区间风险, 唯一风险是时序)
    - 缺口核算 vs 实测: 预估差 0.10 ns, 实测一次收敛(WNS +0.206; ILA 版 +0.469)
    - 上板: ila_ctrl=0xC2(illegal=0) / bit31=1 / tick 1,239,079,510 / 16.52 s / 硬件 CM/MHz 2.4212
    - 指标变化: fmax 74.4->76.2(-2.8% vs 基线) / LUT 2734 / CM-LUTs 8.855e-4 / 吞吐 184.4(+184.6%)
    - 两条结论: ① 收紧约束反而让 fmax 变高 => 改运行频率会同时改动 fmax 这个评分项, 两者不独立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
2026-10-11 docs: 75 MHz 提频的指标与口径全量同步 (task-3 轮, 11 个 .md) + §8.6 遗留
    docs-sync 第三轮: 先复算后落笔, 每个数字都从源头查过
    (metrics.json@20261011-121231 / timing.rpt / util.rpt / coremark.csv 行 clk75 /
    ila_done.capture.json@12:19:02 / timing_ila.rpt / mmio_subsys.sv / mk_cm_hw.py)。
    - **`sys_clk_70` -> `sys_clk_75`** 全量替换(CODE-MAP/HANDOFF/HANDOFF-HW-LOOP/
    HANDOFF-WORKFLOW/README/gap-analysis/analysis-report/tools-README), 含
    HANDOFF-WORKFLOW 两处 fmax 推导示例(改成 76.2 MHz @13.333ns WNS +0.206)。
    - **数字换代**: fmax **76.2**(-2.8%) / LUT **2734** / CM-LUTs **8.855e-4**(+275.0%) /
    吞吐 **184.4**(+184.6%) / 上板 12:1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
2026-10-11 perf(rtl): C-2 把 load 移出前递路径 + C-10 前递选择改 ID 预选 + 中断请求寄存
    依据 RVCoreP-32IM (arXiv 2010.16171) 的三条结构手法。**累计 fmax 76.2 -> 87.8 MHz
    (+15.2%)，绝对吞吐 184.4 -> 195.1 (+5.8%)**；全量回归 PASS 12。
    【C-2 · load 数据出前递路径（论文 §III.A 的核心手法）】
    论文原文: "we did not include the load data into the forwarding path from the write
    back stage. As a result, when there is a data-dependent instruction after load
    instruction, two cycles bubble are inserted."
    - hazard_unit.sv / core.sv: WB→EX 前递不再命中 load；load-use 由 1 拍改 2 拍。
    新增 load_use_mem = "load 在 MEM && ID 依赖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
2026-10-11 test(sim): load-use 代价标定微基准 + 统计口径修正 (PASS 11 -> PASS 12)
    新增 tb_sw_lu_bench（第 12 项回归）与两处口径修正 —— 都是为了让 C-2 的"代价"
    能被**第三方断言**钉住，而不是靠推理。
    【口径修正 1: 真退休分母】sim/tb_sw.sv
    旧 `if (mem_wb_ctrl != '0) n_wb++` 是每拍都数，而 hazard_unit 的 `hold_mem` 会冻结
    MEM/WB 并**重复计数同一条指令**。实测 raw=417064 / hold_mem=14415，但真正的重复是
    14344(有 71 个 hold_mem 拍 WB 段是气泡) ⇒ **真退休 402720**。
    独立互证: fetch=402723 ⇒ **fetch - retire = 3 拍 (0.0007%)**。
    ⇒ 自印的 CPI=1.10 是**虚低**，真值 **CPI 1.1409 /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
2026-10-11 fix(tools): 修掉 4 处会伪造结论的工具缺陷 + 扫 synth/phys_opt 两个从未用过的旋钮
    本轮的价值一半在数字，另一半在**把会伪造成"测到了"的路径堵掉**。
    1. **构建失败不再伪装成上一次的结果**(cmd_synth)。原来只判"日志里没有 BUILD_OK"，
    于是"日志有 BUILD_OK 但 rc!=0"会**继续往下解析磁盘上遗留的 timing.rpt**，把上一次
    构建的数字当成这一次的。实测: 一次 4 秒的失败构建被上层报表成上一次的 76.2 MHz。
    现在失败即失败, 不留后门。
    2. **parse_profile 的 NameError**(我刚引入又立刻被自己的扫描抓到): 新增的窗口解析用了
    错误的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
    [coremark.csv]
2026-10-11 docs: 双方不足记录 (RVCoreP-32IM vs 本核) + 这轮大修的判据
    results/rvcorep-vs-ours.md (新, 173 行): 用户要求"把双方的不足之处记录在案"。
    每一条都带来源(论文页码/表号、本地文件:行、CSV 行名、命令输出), 不用无信息量的判断词。
    最关键的两行(它们决定了本轮的方向):
    - **我们的 CoreMark/MHz 2.4209 > 他们的 2.33** —— 微架构效率我们赢 3.9%;
    - 他们是 **-1**(更慢)器件 162 MHz, 我们是 **-2** 上 76.2 MHz ⇒ 差距 100% 在频率。
    所以判据是**绝对吞吐 CM/MHz x fmax**: 他们 377.5, 我们 184.4(0.489x)。
    含 5 条口径更正(按归档原文核对, 没有沿用简报数字):
    -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
2026-10-11 perf(rtl): C-11 寄存"分支误判" redirect 切环 (fmax 87.8 -> 92.6 MHz) + 事故重建
    【为什么做这一项】C-10 之后新 top-1 是**一堵墙**: 50 条最差路径同族、
    Δ(top1,top2)=0.007 ns、route 75.6% ⇒ 按 PITFALLS R47, 逻辑重排无空间,
    唯一出路是**把环切开**。做法: 只把"分支误判 redirect"寄存一拍再驱动 PC/取指地址;
    **trap/mret 保持组合**(R-01/R48 的不变量一行不动)。
    【实测(本轮单变量)】
    fmax 87.8 -> 92.6 MHz (+5.5%, WNS +1.940 -> +2.535 @13.333ns)
    ticks 449,854 -> 460,311 (+2.324%)
    CM/MHz 2.2229 -> 2.1724
    绝对吞吐 195.1 -> 201.2 (+3.1%) breakeven 89.8 ⇒ 净赚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
2026-10-11 fix(tools): 日志解析不许按中文匹配 (ModelSim 会把中文写成 '?')
    实测根因: `sim/tb_sw.sv` 的 `$display` 里有中文, 而 **ModelSim 落盘时把中文写成了 `?`**
    —— 日志里 "实测冲刷拍数" 变成 "???????????"。于是任何**按中文写的日志解析正则永远不匹配**,
    而它会静默退回旧假设(这里就是"重定向每次 2 拍"的虚报)。
    本次: `redirect_flush_cycles` 的正则改成**按 ASCII 结构匹配**
    (`^\s*redirects\s*=\s*\d+.*?=\s*(\d+)\s*->`), 不再依赖中文字节。
    通用教训(建议进 PITFALLS): **脚本不许按中文匹配日志**。TB 要给人看的中文可以留,
    但给机器看的判据必须是 ASCII 标记(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
    [coremark.csv]
2026-10-11 docs(plan): §9 第四轮大修记录 (按 RVCoreP-32IM 论文, 76.2 -> 97.5 MHz, 150 MHz 进行中)
    记录: 论文给出的定位(CM/MHz 我们更高、差距纯在频率)、频率阶梯逐项台账(C-2/+9.7%、
    C-10/+5.0%、C-11/+5.5%、AlternateRoutability/+5.0%、Pblock X2Y2/+0.3%; 累计 +28.0% fmax、
    +14.9% 绝对吞吐)、三项**有证据的不做**(C-8/C-3/C-12a)、物理侧新认识(上午的 Pblock 结论
    不可继承因为网表换了族; 新族 50/50 同源、仅 3 级、9.027ns)、工具侧两个真发现
    (PerformanceOptimized 在 2018.3 不存在、日志不许按中文匹配)、以及三条过程教训
    (冻结窗口协议/`git checkout --` 破坏未提交工作/全绿当场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
2026-10-11 perf(clk): 时钟阶梯 75 -> 105 MHz (每档实测) + 工具/镜像链的三处加固
    用户要求"每提升 25MHz 上板验证一次"。本轮把时钟从 75 MHz 推到 105 MHz,
    **每一档都实测**, 并把实测最优的构建配置烙成默认值。
    【阶梯实测】(RTL = C-11, 即 fmax 92.6 的那份网表)
    约束 13.333 ns (75.00 MHz) -> fmax 97.5 WNS +3.080 LUT 2711 FF 1290
    约束 10.476 ns (95.45 MHz) -> fmax 106.4 WNS +1.076 LUT 2708 FF 1290
    约束 9.524 ns (105.0 MHz) -> fmax 106.3 WNS +0.117 LUT 2706 FF 1290 BUILD_TIMING=PASS
    ⇒ **收紧约束让工具更卖力**(97.5 -> 106.4), 这是本核第三次观测到该效应
    (70->75 时 +1.8 MHz, 75->95.45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
    [coremark.csv]
2026-10-11 data(hw): 105 MHz 上板验证 PASS (第一个 +25MHz 台阶)
    用户要求"每提升 25MHz 上板验证一次"。75 -> 105 MHz 这一档的完整闭环证据:
    抓取时间 2026-10-11 15:22:41 RTL 指纹 22a98ac0… (= 当前 RTL, 采集清单见证)
    ILA 像 ILA_TIMING=PASS, WNS +0.505 @9.524ns (sys_clk_core 105.000 MHz, 0 失败端点)
    ila_ctrl = 0xC2 -> locked=1 done=1 pass=1 fail=0 illegal=0
    score_result = 0xD24B8AFE (bit31=1 -> CRC 匹配 且 时长>=10s)
    tick = 1,380,682,494 时长 13.15 s @105MHz (>=10s ✓)
    硬件 CoreMark/MHz = 2.1728 (仿真 2.1724, 差 0.02%)
    tick 偏差 = 0.018% (门限 0.5%) dbg_pc 静止在结尾 `j .`
    => 上板验证 PASS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
    [ila_done.csv]
2026-10-11 perf(rtl): C-1 两级流水 gshare 上线 + C-14 单链目标比较 + C-12b' 展宽 + 构建期 PROG 改 env
    【C-1 · 两级流水 gshare（rtl-pred）—— 本轮把 IPC 赚回来】
    btb.sv 重写为 512 项 + 两级流水口(`p2_pc`→`q_*`)，新增 bht.sv(PHT 8192 项, 2 位饱和, `ram_style=block`)。
    T 拍只用 `p2_pc = pc_next` 作**查表地址**, T+1 拍 `q_*` 已是寄存器输出 ⇒ BRAM 的 1 拍读延迟
    被"提前一拍给地址"吸收, **零气泡**。`q_taken` 刻意不寄存(否则每个 taken 分支 +1 气泡)。
    旧 `pred_*` 口保留但恒"不预测"(不悄悄改旧口语义; 未接线时功能仍正确, 只是慢)。
    【C-14 · JALR 目标比较改单链（rtl-bypa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
2026-10-11 chore(rtl): 四项零行为卫生改动 (清 11 条综合警告 + 把预测器错位变成硬失败)
    rtl-bypass 的四项, 全部零行为: `verify --force` PASS 12 且 **ticks 逐位 453,942**。
    ① 删 `hazard_unit.sv` 的 `id_ex_rs1/id_ex_rs2` 两个 input(C-10 之后模块内已无使用者)
    + `core.sv` 删对应两行连接 ⇒ 清 `Synth 8-3331` ×10。
    ② `core.sv` 把 `br_redir_r2` 的**声明/复位/赋值**三处包进 `ifndef SYNTHESIS`
    ⇒ 清 `Synth 8-6014 Unused sequential element` 并省 1 位 FF(它只被 C-11 断言使用)。
    ③ `core.sv` 过期注释修正: "BTB 用当前 pc 查询(.pred_pc(pc))" →
    "用 p2_pc=pc_next 提前一拍查询(C-1 两级流水相位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
2026-10-11 perf(rtl): 摘除 C-12b'(131.25 档实测净亏) —— 负结果写进代码注释, 不只写在聊天里
    【为什么摘】同一个 7.619ns 约束下逐点实测:
    C-11 : WNS -0.173 top-1 = mem_wb/ctrl_reg[wb_src]… → u_muldiv/prod_uu_reg__2/PCIN
    C-11 + C-12b' : WNS -0.543 top-1 换族到 u_id_ex/imm_reg[4]/CE
    + C-14 + C-1 : WNS -0.517 top-1 = u_ex_mem/alu_out_reg[4] → id_ex_fwd_a_reg[1]_rep__1/D
    ⇒ C-14+C-1 只把亏空补回 0.026ns; 相对 C-11 单独仍差 0.344ns ⇒ 摘除。
    【机理(写进 core.sv 注释, 归入 PITFALLS R37-4/R40-3 那一族)】
    `max_fanout` 复制的是**寄存器**: Q 侧扇出降了, 但**每份副本多一条 CE 引脚** ⇒
    与 f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
2026-10-11 fix(tools): 修两处"会静默给出错误结论"的 P0 (风格审查抓出) + 长选项名归一
    来源: `results/style-audit.md`(独立只读审查, P0=7/P1=9/P2=5)。本次修其中两条**不改 RTL**的:
    【P0-1 · run_coremark.py 是 M-01 那个 fmax bug 的**未修副本**】(最危险的一条)
    `:135` 仍 `re.search(r'^sys_clk\s+([-\d.]+)', ...)`, `:138` 仍硬编码 `1000.0/(20.0-wns)`。
    而 MMCM 之后 `sys_clk` 行只剩脉宽端点(WNS/TNS 列为**空**), 该正则跨过空列抓到 WPWS(7.000)
    ⇒ fmax 被算成 76.92, 且**对 RTL 时序变化完全不敏感**; `--record` 会把这个错值写进
    results/coremark.csv(与 fpga_workflow.py 里已修的实现并存 =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
2026-10-11 docs: 独立代码风格/一致性审查报告 (P0=7 / P1=9 / P2=5) + git 纪律入档
    用户要求"定期进行代码风格方面的审查, 防止前后不统一"。派独立审查员**只读**扫描
    (唯一写入 = 本文件), 范围含仓库根 *.sv / fpga/*.sv / fpga/*.tcl / sim/*.sv / tools/*.py。
    报告结构: ①仓库自己写在纸面上的规矩(附来源) ②不一致清单(每条带 file:line 与建议)
    ③非 ASCII 字节统计(55 个文件逐个实测) ④**故意差异, 不要为了统一而改坏**(6 类)
    ⑤可机器化的闸门建议。
    【最该先修的 3 条(已在后续提交修掉 2 条)】
    1. P0 `fpga/top_a100t.sv:75` 仍 `logic sys_clk_75;`、`:111-113` 注释还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
2026-10-11 perf(rtl): C-15 registered flush + C-12b' 恢复 + C-15 影子指令的口径修正
    【C-15 · registered flush (rtl-bypass)】误判检出拍 N 不再组合冲 ID/EX
    相位: `id_ex_flush = trap_redir || br_redir_r` 驱动 `id_ex_reg.flush`;
    `ex_mem_reg.flush = trap_enter || br_redir_r` 把错路影子 X0 挡在 MEM 外。
    X0 的全部 EX 副作用门控(`redir_kill = br_redir_r`): `redirect_raw` / `btb_upd_en`(含 RAS push/pop)
    / `csr_we` / `mret_req_int` / `exc_req` / `irq_take` / `br_redir_eff` / `muldiv.op`(X0 是 DIV 时
    不许启动 32 拍序列)。hazard 视角也把 X0 当"没有指令"(`id_ex_mem_read/reg_write` 与
    `!redir_kill` 相与、`id_ex_rd` 在窗口里钉 0)。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
2026-10-11 docs: 文档层一致性收口 (16 个 .md) + 新增 tools/path_families.py
    依据独立风格审查的 4 条 P0 + 2 条同族 (详见 results/style-audit.md)。
    - P0-1 `bht.sv` 补进 README/CODE-MAP/HANDOFF 文件一览; 计数落差写成事实:
    根目录 21 个 .sv / 4691 行(现查), 全仓 23; 采集清单的 22 个**不是错** ——
    那次上板(15:22)时 bht.sv 还不存在(028ca4d 15:55 引入) => **差的是时间点**。
    - P0-2 时钟/档位/fmax 三件事带来源: ①`sys_clk_core`(频率无关) ②**已上板档 105MHz**
    (0xC2 / 0xD24B8AFE / tick 1,380,682,494 / 13.15s / 硬件 2.1728) ③目标 131.25MHz 未收敛。
    **必须一起读的告警**: 上板 RTL 比当前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
2026-10-11 perf(rtl): C-12a 让 muldiv 操作数直取 rs1/rs2 (DSP 输入锥少一级) —— 131.25 档只差 0.077ns
    [改动] `core.sv` 的 `u_muldiv` 例化: `.a(ex_a)/.b(ex_b)` -> `.a(ex_rs1)/.b(ex_rs2)`
    (直取**前递后**的 rs1/rs2, 跳过 `ALU_A/ALU_B` 操作数两级 mux)。
    C-15 的 `.op(redir_kill ? ALU_ADD : id_ex_ctrl.alu_op)` 一字未动。
    [逐位等价性] `control_unit.sv:57-98`: M 扩展走 `OPC_REG` R 型路径 => `alu_a_src` 保持默认
    `ALU_A_RS1`、`alu_b_src` 显式 `ALU_B_RS2` => 对 MUL/MULH/MULHSU/MULHU/DIV/DIVU/REM/REMU
    **恒有 `ex_a ≡ ex_rs1`、`ex_b ≡ ex_rs2`**(逐位等价, 不是近似)。
    AMO 的 `alu_b_src=ALU_B_IMM` 不受影响: `is_muldiv` 只认那 8 个 a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
2026-10-11 fix(rtl,clk): 128.125MHz 交付档 + 收口两条风格审查 P0(时钟名/纯ASCII) + C-18a 负结果入档
    【时钟档: 128.125 MHz (VCO 1025 = 50*20.5, N=8; XDC -multiply_by 41 -divide_by 16)】
    实测(见下): **MET, WNS +0.062, 零失败端点**。相对**已上板验证的 105 MHz** 是 **+23.1 MHz**,
    正是用户要求的"每 +25MHz 上板验证一次"的台阶。
    选档依据(全部实测, 不是推算):
    131.25 -> WNS -0.077 (差 0.077)
    129.6875 -> WNS -0.024 (差 0.024; 但**支配族已 +0.019**, 只剩 2 条 id_ex_fwd_*_reg/D)
    128.125 -> WNS **+0.062** MET
    125.000 -> WNS +0.020 MET
    => 取 128.125(离 105 最近且过门余量足够), 125.000 作为备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
    [coremark.csv]
2026-10-11 hw: 117.1875 MHz 上板验证 PASS (+12.19MHz) + ILA 工程流策略对齐(否则两份网表不是同一份)
    【上板证据 (results/ila_done.csv + .capture.json)】
    抓取 2026-10-11 22:01:32, RTL 指纹 83ea66ab… (与当前 RTL 一致)
    ILA 像: ILA_TIMING=PASS, WNS +0.078, 零失败端点, sys_clk_core 8.533ns/117.188MHz
    score_result = 0xD10C73F9 (bit31=1) ; tick = 1,359,770,617
    时长 11.60 s @117.1875MHz (>=10s ✓) ; 硬件 CoreMark/MHz = **2.2063**
    tick 偏差 0.151% (门限 0.5%) ; dbg_pc 静止在结尾 `j .` ; **=> 上板验证 PASS**
    对比上一档(105MHz 上板): tick 1,380,682,494 / 13.15s / 2.1728 / 22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
    [coremark.csv, ila_done.csv]
2026-10-11 fix(data): CSV 表头里的 fmax 公式是**已被证伪的错公式**; 交付档补记 CM/MHz 让 report 能取锚点
    【1 · 表头错公式 (风格审查 P0-3 的另一半)】
    `results/coremark.csv` 表头写着 `fmax_mhz = 1000 / (20 - wns_ns)` —— 而那个公式正是
    产出过**恒定假值 76.92、坑了 30+ 次构建**的那一个(M-01): 它按时钟名 + 列对齐取 WNS,
    而 MMCM 之后 `sys_clk` 行只剩脉宽端点、WNS 列是**空的**, 于是跨过空列抓到了 WPWS。
    现在改成事实: `fmax_mhz = 1000 / (Requirement - Slack)`, **从"最差 setup 路径块"里
    带标签地取**(见 tools/fpga_workflow.py 的 parse_worst_setup_path docstring), 并把
    这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
    [coremark.csv]
2026-10-11 hw: 118.75 MHz 上板验证 PASS (+13.75MHz) —— 上次失败是 IP_Flow 间歇故障, 非时序
    【上板证据】
    抓取 2026-10-11 22:2x, RTL 指纹 8096ad22… (与当前 RTL 一致)
    ILA 像: ILA_TIMING=PASS, WNS +0.095, WHS +0.070, sys_clk_core 8.421ns/118.750MHz
    时长 11.45 s @118.75MHz (>=10s ✓) ; 硬件 CoreMark/MHz = 2.2063
    tick 偏差 0.151% ; dbg_pc 静止在结尾 `j .` ; => **上板验证 PASS**
    【关键: 上一轮 118.75 的"失败"是 IP_Flow 间歇故障, 不是时序不过】
    首次尝试报 `IP_Flow 19-3505`(半成品 IP 状态, 见 PIT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
2026-10-11 hw: 128.125 MHz 上板验证 PASS (+23.1MHz) —— 候选B 把 ILA 流从 -0.434 治到 +0.000
    采集 RTL 指纹 8c1307d4… (与当前 RTL 一致)
    ILA 像: ILA_TIMING=PASS, WNS **+0.000**(临界), WHS +0.043
    时长 10.61 s @128.125MHz (>=10s ✓) ; 硬件 CoreMark/MHz = 2.2063 ; tick 偏差 0.151%
    => **上板验证 PASS**
    **tick 与 118.75 档逐位相同**(1,359,770,617) => 再次自证"tick 是周期数、与主频无关",
    且两次运行的指令流逐位一致。
    【候选 B (删 C-10/C-14 并行寄存器块的清 0 条件) 的效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
    [coremark.csv]
2026-10-11 feat(tools): mk_cm_hw 增加"赛题 >=10s"闸门 (R35 的成品化: 提速后必须重算 ITERATIONS)
    【为什么现在必须加】
    提频到 128.125 MHz 后 3000 迭代实测 **10.63 s**, 只剩 0.63 s 余量。而塞题硬要求
    "基准必须跑 >= 10 秒" —— 再往上提(约 >136 MHz)就会**违反规则**, 可"跑得更快"
    看起来完全像个好成绩。这类"指标变好但规则被违反"的形态正是本工程最该拦的。
    此前 R35 只写了"提速后要重算 ITERATIONS"这条**纪律**, 靠人记得; 现在变成**闸门**:
    `expect_tick = 每迭代拍数(取自核心仿真日志) x ITERATIONS`
    `run_secs = expect_tick / CLK_HZ`
    run_secs < 10 ⇒ **[B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
2026-10-11 chore: 4700 迭代的烧录产物就绪 + 31 位 tick 闸门加安全余量 + 明天操作单
    【用户要求"迭代到 5000, 板子要掉电, 准备好代码明天烧"】
    5000 迭代 tick = 2,269,710,000 **超出 31 位上限**(2,147,483,647) —— 但根因不在硬件:
    计数器是 **64 位**(mmio_subsys.sv:126), 限制在**上报打包**: 软件写
    `MMIO_RESULT = (valid?0x80000000:0)|(ticks & 0x7fffffff)`(sw/core_portme.c:152),
    **bit31 借去当"CRC 有效"标志** ⇒ tick 只有 31 位可用。
    => 今晚备好 **4700 迭代**(打包方式下的安全上限), 明天可直接烧:
    expect_tick 2,133,527,400 / wait 21s / **16.65 s @128.125MHz**(>=10s 余量 6.65s)
    ILA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
2026-10-13 docs: 新增 results/CHANGELOG.md —— 改动轨迹(改了什么/为什么/结果/教训)
    用户要求"时常记录做过的更改, 方便循着轨迹学习"。这份文档不是机器日志, 而是给**人**看的轨迹:
    每条都给 `file:line` + 判据命令 + CSV 行名(可独立复现), 并且**把为什么写清楚**(含被推翻的推理)。
    结构:
    0. 总账(基线 64.8 -> 262.4 绝对吞吐; 四个上板验证过的档位)
    1. 时间线·正面成果: C-2 / C-10 / C-11 / C-14 / C-15 / C-1 / C-12a / 候选B
    每项 = 改动 + 为什么 + 结果 + **"最该学的一点"**
    2. 工具与流程改动(15 项, 每项注明"为什么它能让人信")
    3. **方法论教训 12 条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
2026-10-13 docs(changelog): 补 2026-10-13 一轮 —— 候选A/候选C/Vivado崩溃诊断/150档瓶颈解码
    用户要求"时常记录做过的更改"。新增 §7, 四条:
    1. **候选 A**(BTB 停顿锥搬到 CE 端, 三泳道): 机制**生效**(q_vld_reg/D +0.000->+0.046,
    族离开 top-50) 但净 WNS **+0.090 -> +0.013** —— 因为瓶颈**转移**到 C-11 的 br_tgt_r_reg/CE
    (13 条 +0.090 -> 32 条 +0.013)。最值钱的是 rtl-pred 的 trace 二分:
    整链冻结会让 ticks 453,942->454,996, 首个分歧 **cycle 8283**(pred_taken 1->0), 根因
    "停顿期 GHR 仍被 EX 推动 => 老实现用漂移 GHR 重算 PHT 索引, **那条刷新本身是 ticks 的一部分**"
    => **"看起来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
    [coremark.csv]
2026-10-13 docs+fix: 主频差距核实与结论 (FREQ-VERDICT.md) + 时序门失败点开始入台账
    【用户指示】"先核实他们的主频等级, 然后确认一个我们可以达到的水平, 定好目标和计划后再动手"
    ⇒ 本轮**只做核实与分析, 不再试错**(已把所有免费旋钮试穷)。
    【核实结果(逐条带来源, 见 results/FREQ-VERDICT.md)】
    - 论文 Table I (arXiv 2010.16171, PAGE 6): xc7a100tcsg324-1(**速度等级 -1 = 最慢**),
    Vivado 2018.3, 取"1MHz 步进下 slack 仍为正的最高频率":
    RV32I 174/164 ; RV32IM(radix-4) 169/162 ; **RV32IM(DSP) 169/162** ; VexRiscv 153/143 (4KB/64KB)
    他们的 RV32IM(DSP): LUT 1331/1338, REG 901/903, DSP 4
    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
2026-10-13 docs(changelog): §8 150 战役 (C-12c 解锁器 + 逐跳定位真锥 + 三个工具单选项)
    - step1: C-12c 作为**解锁器**重新落盘(单点视角净亏, 战役视角是必要代价: 2.158*150=323.7
    vs 2.2029*128.125=282.2 仍 +14.7%); 150 档 -0.852, DSP 族消失, 墙如期转移到
    alu_out_reg/D(22) + 复位网(16) + alu_out_reg/CE(4, top-1 落在 CE)。
    - **逐跳**(最有价值的一张图): Source=imem 指令字 → Dest=ex_mem/alu_out_reg[2]/CE, 7.081ns/5 级,
    逻辑合计仅 0.525ns, 而 hop5/hop6 两跳高扇出布线(fo=121/122)就占 **2.147ns(30%)**。
    - **真锥**(rtl-bypass 从逐跳解出, 比我最初的 md_busy 假设更准):
    imem 指令字 → rs1/rs2 相等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
    [coremark.csv]
2026-10-16 hw: 150 战役的可用成果 —— C-12c + E′ + (-no_lc -fanout_limit 128) 使 138.75MHz 过门
    【战役结论: 150 未达, 但拿到 138.75MHz(评分流过门, WNS +0.015), 比已上板 128.125 高 +10.625MHz】
    150 档的完整证据链(全部单变量实测):
    A+C -0.770 绑定族 = DSP 级联
    + C-12c -0.852 机制成功(DSP 族消失)但墙转移到 trap/CE 锥
    + --no-lc -0.490 **+0.362** (只在此树有效)
    + E'(!hold_mem) -0.382 **+0.470** (trap 三族全消失)
    + --fanout-limit 128 -0.172 **+0.210**
    ⇒ 还差 0.172ns 到 150; --fanout-limit 64 触发 Vivado 崩溃(rc=3221225477)
    非单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
    [coremark.csv]
2026-10-16 hw: **138.75 MHz 上板验证 PASS** —— 150 战役的实际产出 (+10.625MHz, 绝对吞吐 +6.1%)
    ila_ctrl=0xC2 (locked/done/pass=1, fail/illegal=0); score_result bit31=1 有效
    tick = **2,128,330,451** (预期 2,131,483,600, 偏差 **0.148%** << 0.5% 门限)
    时长 **15.34 s** (>=10s); CoreMark/MHz **2.1613**; 迭代率 **299.9/s**
    两条流: 评分流 WNS +0.033 PASS / ILA 流 ILA_TIMING=PASS (WNS +0.010)
    RTL 指纹 ca43541e… 与当前 RTL 一致; 镜像 4600 迭代; 两流都用**默认**综合选项
    【对比上一档 128.125】+10.625 MHz (+8.3%); 绝对吞吐 282.7 -> **299.9** (+6.1%)
    —— 且这是在 C-12c 的 +2.08% ticks 代价之下拿到的**净**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
    [coremark.csv, ila_done.csv]
2026-10-16 docs(next-burn): 操作单更新到 138.75MHz 交付档 (+ 150 的诚实状态 + 5 条环境坑)
    - 烧什么/命令/预期判读值/回退对照档/换档三处同源
    - 150 还差多少: 评分流 -0.172, ILA 流再差 ~0.02~0.16 => 实际 ~0.35ns; 绑定族 24 条 EX 数据通路
    + 13 条取指地址锥; 剩余可选手段三条(复位网 BUFG / EX 数据通路(不建议) / 取指地址锥)
    - 环境坑 5 条: IP_Flow 19-3505 / Vivado 在不可行目标上确定性崩溃 / 非单调性 /
    编排脚本纯 ASCII 且注释别写方括号 / 31 位 tick 闸门(迭代上限降到 4611)
2026-10-16 hw: 候选F + ILA 变轻 + 工程流选项真名 —— 138.75 交付档余量 +0.010->+0.150; 150 上板流仍过不去
    【最终结论】150 MHz 在**评分流**上过门(+0.018), 但在**上板验证流(带 ILA)**上过不去(-0.293)。
    => 调试核开销随频率急剧增长(138.75 档两流差 0.023ns, 150 档差 0.311ns), 高频下它在抢布线。
    这是"能否上板验证"的边界, 不是内核本身的边界。
    【交付档 138.75 复验】tick 2,128,330,451 —— 与 F 落地前**逐位相同**(指纹 ca43541e -> 6fef2733)
    => **候选 F 在硬件上行为逐位中性** ✓(等价性论证的实测确认)
    【变轻调试核 = 交付档余量翻 15 倍】C_DATA_DEPTH 2048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
    [coremark.csv, ila_done.csv]
2026-10-16 docs(changelog): §10 150MHz 最终结论 (评分流过门 / 上板验证流过不去 的硬边界)
    - 150 档: 评分流 +0.018 PASS, 但 ILA(上板验证)流 -0.293 FAIL
    => 调试核开销随频率急剧增长(138.75 差 0.023ns -> 150 差 0.311ns); 这是"能否上板验证"的边界
    - 三个突破: ①工程流综合选项真名用 list_property 查出(ARGS.NO_LC/ARGS.FANOUT_LIMIT)
    ②调试核变轻(深度 2048->1024 + 流水 2->4) => 138.75 的 ILA 余量 +0.010 -> **+0.150**
    ③候选 F: 正确性成立且硬件行为逐位中性(两次采集 tick 完全相同), 但**时序上墙只换终点**
    - 工具修复: verify 另存默认配置日志, mk_cm_hw 优先读它(此前会读到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
2026-10-16 feat(tools): UART 验证通道工具 (uart_capture.py) + FTDI 通道探针 (ftdi_probe.py)
    【为什么】150 MHz 在**评分流**(无 ILA)过门(+0.018), 但在**带 ILA 的上板流**过不去(-0.293)
    => 调试核在高频抢布线。若能从 UART 读回 CoreMark 输出, 就能用**评分流那份网表**(= 真正要
    交付的网表)上板验证, 绕开调试核的时序代价。
    【硬件核查结论(重要)】
    · 本机唯一相关 USB 设备: FTDI **FT232H**(VID_0403&PID_6014, type=232H, desc='Digilent USB Device',
    序列号 210512180081 == JTAG 目标) => 那只是**外接 JTAG 下载线**, 不是板载串口;
    · 全部 COM 口都是蓝牙; **没有任何 USB 转串口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
    [coremark.csv]
2026-10-16 fix(docs): **纠正一处我自己的错误结论** —— "150 评分流过门"其实是 138.75 档
    【错误】我在 CHANGELOG §10 与给 rtl-bypass 的消息里断言"150 MHz 在评分流上过门(+0.018)"。
    【真相】那两次测量(pl150-AltSpreadLogic_high +0.010 / pl150-ExtraNetDelay_high +0.018)的
    **命令没有切时钟**, 实际约束仍是 **138.75 MHz**。
    【怎么被抓住的】CSV 的 fmax 列与 WNS 是两个可互相校验的量:
    1000/139.1 = 7.191 ~= 7.207 - 0.018 (= 138.75 的周期 7.207); 而 150 档周期是 6.667。
    => **"我以为时钟是 X" 不是证据; 约束周期必须从台账反推校验。**
    【150 档真实实测(period 6.667)】
    C-12c+E'+(-no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
    [coremark.csv]
2026-10-16 fix(rtl): 档案里挂错时钟的数字已按档位分开标注 + "周期反推校验"立为规矩
    【背景】上一轮我误把两条 138.75 档的测量当成 150 档(命令没切时钟), 连带污染了候选 F 的档案措辞。
    本文只动注释。
    【更正】ex_mem_reg.sv:86-97 与 core.sv:720-739:
    · F 的判负依据来自 **138.75 档同配置**(+0.018 -> -0.236, 净亏 0.254ns @138.75);
    · **150 档**另有独立测量(默认选项+ExtraNetDelay_high) = -0.267, 劣于当时最好 -0.172;
    · "0.254ns" 与"新绑定族 fwd_data_reg/D(24 条 -0.255)"都标注为 138.75 档观测(150 那次选项不同, 不可相减);
    · 硬件逐位中性的两条证据(两次上板 tick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
2026-10-17 feat(uart): **UART 验证通道打通** —— 与 ILA 交叉验证同一个 138.75MHz 交付档
    【动机】150 档在 ILA 流上过不去(调试核抢布线)。用**评分流那份网表**上板 + 从 UART 读回
    CoreMark 结论 => 一条独立于调试核的验证通道。
    【三个硬事实(先查后写)】
    1. 本机 FTDI 是**单通道 FT232H**(type=232H, desc='Digilent USB Device', 序列号==JTAG 目标)
    => 只是 JTAG 下载线, 不是板载串口; 当时无任何 USB 转串口设备。
    2. 用户接 CH340 后出现 **COM13** (VID_1A86&PID_7523)。
    3. **`uart_send_char()` 根本不往 UART 写** —— 它写 DMEM 日志缓冲 0x9000_3000(给 TB 读字符串)
    => 串口一个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
    [coremark.csv]
2026-10-17 hw: **150 MHz 达成并上板验证** —— 用 UART 通道绕开调试核的时序代价 (评分流 -0.172 -> +0.000)
    【上板证据 (UART COM13 @115200)】
    [portme] rate gate: clk=150000000 Hz ticks=2128330449 secs=14 min10s=ok
    CoreMark Size 666 / Total ticks 2128330449 / Total time 14 s / Iterations/Sec 328
    crclist 0xe714 crcmatrix 0x1fd7 crcstate 0x8e3a crcfinal 0x382f / **Correct operation validated**
    ★ 决定性自洽证据: 150 MHz 的 Total ticks 与 138.75 MHz **完全相同(2,128,330,449)**
    => 周期数与频率无关 => 行为逐位一致、频率缩放真实
    【怎么破的: 验证手段本身是瓶颈的一部分】
    带 ILA 的网表在 150 过不去(-0.293~-0.514), 而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
    [coremark.csv]
2026-10-17 docs(next-burn): 操作单更新到 **150 MHz 交付档**
    - 烧什么: 150MHz / 4600 迭代 / 预期 tick 2,131,483,600 / 实测 2,128,330,449
    - 实测性能: Iterations/Sec 328 / 14s / CM/MHz 2.1613 / 绝对吞吐 324.2 / Correct operation validated
    - 时序: 评分流 WNS **+0.000 MET**(压线) ; 不带 ILA (带 ILA 的网表在 150 过不去 -0.293~-0.514)
    - 选项: -no_lc + -fanout_limit 128 + pblock X0Y1:X2Y3 + contain_routing
    - 为什么用 UART: 调试核在高频抢布线; 软件把日志镜像到 MMIO_UART_TX(打印在 stop_time 之后,
    不污染测量窗口, ticks 逐位不变)
    - 命令与**顺序**: 先起 uart_capture 监听, 再 prog_uart.bat (程序配置完 14.5 秒后打印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
2026-10-17 chore: 整理桌面残留文件 + 新增 opt_design directive 开关 + 恢复 150MHz 甜点时钟
    【桌面整理(用户要求)】我这轮在 D:\USER\Desktop 留下的文件:
    tools/sweep_clk.py -> FPGA/tools/ (有用工具, 进仓库)
    patch_recipe.py/patch_fanout.py/ila_ladder.ps1/patch_optdir.py
    -> .fpga-cache/patch-history/ (一次性脚本, 留档不删)
    FPGA-backup-20261011-2213.bundle -> .fpga-cache/backups/ (离线备份)
    fpga/hs_err_pid*.dmp/.log -> 删除 (Vivado 崩溃转储)
    用户自己的文件(数字组综测.txt / 2010.16171v1.pdf / 所有 .lnk) **未动** ✓
    => 桌面根目录现在只剩用户资料与快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
    [coremark.csv]
2026-10-17 hw: **QSPI FLASH 烧写成功并读回校验 PASS** (150 MHz SPIx4 启动镜像)
    【结果】
    [1/4] accessor = tools/flash_logs/accessor/spi_xc7a100t_pullup.bit (601,662 B) ✓ 加载
    [2/4] image = fpga/cpu_a100t_spix4.bin (3,825,788 B, SPIx4) ✓
    PART=mt25ql128-spi-x1_x2_x4 VERDICT=PROGRAM_OK ; Mfg ID 20 / Type ba / Capacity 18
    Readback Operation successful.
    [4/4] readback=16777216 image=3825788
    **VERIFY=PASS** (前 3,825,788 字节完全一致; 其后无杂散非 FF 字节)
    PASS - flash content == image.
    【为什么必须读回】PITFALLS R44: program_hw_cfgmem 在 VERIFY=0+CFG_PROGRAM=0 时**仍打印**
    "Flash programming completed successfully" => 工具的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
    [coremark.csv]
2026-10-17 hw: **FLASH 自启动验证 PASS** —— 150MHz 从 QSPI 上电自启动, CoreMark 校验通过
    【证据】抓到的上电输出(窗口内多次复位, 每次完全一致):
    CoreMark Size 666 / Total ticks 2128330449 / Total time 14 s / Iterations/Sec 328 / Iterations 4600
    【三重一致的 tick = 2,128,330,449】138.75MHz 采集 / 150MHz JTAG 烧写 / FLASH 自启动 —— 三者完全相同
    => 行为逐位一致、频率缩放真实、自启动镜像正确
    【完整交付闭环】
    设计: 150 MHz (SPIx4 启动镜像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
2026-10-17 docs(next-burn): 追加 FLASH 自启动章节 (命令/判据/已验证结果/150 压线的余量说明)
2026-10-17 docs(readme): 成绩速览更新到最终交付档 —— **150 MHz + QSPI FLASH 自启动**
    之前 README 还停在 2026-10-11 的状态(已上板 105 MHz / 目标 131.25 未收敛 / 源码仿真未上板) ✗。
    本次用脚本按实据更新(13 处替换, 每处断言恰好命中 1 次):
    数据源: results/coremark.csv 行 deliv150-final (LUT/FF/fmax) + results/uart_boot.txt (上板实测)
    - ①时钟名来源: XDC -multiply_by 21 -divide_by 8 -> **-multiply_by 21 -divide_by 7** (150MHz)
    - ②已上板验证档: 105 MHz -> **150 MHz (2026-10-17 从 QSPI FLASH 自启动, 断电重启即运行)**
    - ②上板实测: tick 1,380,682,494/13.15s/2.1728 -> **tick 2,128,330,449 / 14s / 328 iter/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
2026-10-17 docs: 新增 results/COMPETITION-PLAN.md —— 紫光赛道一(RISC-V CPU)作战计划与优先级清单
    【赛道已确认(用户澄清 + docs-sync 独立查证)】
    "紫光赛道一" = 全国大学生嵌入式芯片与系统设计竞赛 · FPGA创新设计赛道 · 紫光同创杯 ·
    赛题一「基于 RISC-V 处理器的软硬件系统设计」= 我们正在做的事
    => 架构上我们已领先 2022 年该赛题大奖(电子科大/PGL22G/三级流水);
    真正缺口 = ①器件必须紫光同创(现跑 Artix-7, 不合规) ②作品形态(无OS/无IDE/无视频/无设计报告)
    ③PPA 缺功耗。时间: 2026-11-04 18:00 交作品, 11-20~22 南京决赛 (~2.5 周)
    【三份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
2026-10-17 hw(negative): 150MHz 留余量的三条路全部实测判负 —— PLL / 两个 RTL 修复 / 合法 Pblock
    【用户要求】"别让 150MHz 压线, 试改 RTL" + "考虑 MMCM 换 PLL"
    【实测矩阵 (全部单变量, 配置固定)】
    交付档 (Pblock 越界 X0Y1:X2Y3) : WNS **+0.007** ← 唯一过门, 但约束非法(CRITICAL 12-4433)
    换 PLLE2 (VCO 1200/8) : **-0.421** ✗ 时钟不确定性 0.043 与 MMCM 完全相同
    RTL: id_ex 控制网 max_fanout (fo=132) : **-0.276** ✗ 墙转移第5例(新长 id_ex/rs1|rs2_data_reg/CE 族)
    RTL: bht align 自证链移除(综合视图) : **-0.006** ✗ 机制成功(top-1 整条消失)但墙转到 EX 数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
    [coremark.csv]
2026-10-17 hw: **合法 150 MHz 达成** + "留余量"八组实验全部判负 (含一个重大发现)
    【重大发现: 交付档的越界 Pblock 其实从未生效】
    CRITICAL [Vivado 12-4433] "Constraint ranges extend outside the device: X0Y1:X2Y3"
    => resize_pblock **失败, 整个 pblock 没被应用** => 交付档实际用的是「无 Pblock + contain + AltSpread」。
    显式改成 `--pblock-range off` 后 **WNS +0.007 MET, 构建日志 0 个 Critical Warning** => **合法 150 MHz 成立** ✓
    合法配方: --no-lc --fanout_limit 128 --pblock-range off --contain-routing --place-directive AltSpreadLogic_high
    产物: cpu_a100t.bit sha256 794b50e6… / cpu_a100t_spix4.bit sha256 ef3c970a…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
    [coremark.csv]
2026-10-17 hw: **最终交付固化** —— 合法 150MHz + 镜像时钟标定修正 (143.75 -> 150) + 上板验证
    【发现并修正一个交付不一致】
    上板串口报告 `[portme] rate gate: clk=143750000 Hz` ✗ —— 程序里烘的 HW_CLK_HZ 还是 143.75MHz,
    因为扫频时最后一次 mk_cm_hw 在 143.75 档跑的, 之后改回 150 却没重建镜像。
    (tick/CRC 不受影响, 但报告的 clk= 与换算秒数是错的 —— 正是本工程最忌的"标签与事实不一致")
    => 在 150MHz 下重建镜像 (sim/prog/cm_hw.build.json clk_hz=150000000) + 重建两个 bitstream
    【最终产物 (合法配方, 0 Critical Warning)】
    配方: --no-lc --fanout_limit 128 --pblock-range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
    [coremark.csv]
2026-10-17 hw: 最终 CM 数据采集 (合法 150MHz 评分流, 板上实测) + 归档
    CoreMark Size 666 / Total ticks 2,128,330,449 / Total time 14 s / Iterations 4600 / Iterations/Sec 328
    seedcrc 0xe9f5 / crclist 0xe714 / crcmatrix 0x1fd7 / crcstate 0x8e3a / crcfinal 0x382f
    **Correct operation validated**
    => CoreMark score 328 / CoreMark/MHz **2.1613** / ticks per iteration 463,366 / 绝对吞吐 324.2
    bitstream: cpu_a100t.bit sha256 d8d6827a… (合法配方, 0 Critical Warning, WNS +0.007)
    归档: results/uart_cm_final.txt + results/uart_cm_final.capture.json
    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
2026-10-17 docs(changelog): §13.4 记录 CoreMark 分数口径纠正 —— 规范值 324.20（固件打印 328 为整数秒截断, 虚高 1.3%）
    根因: core_portme.h 的 HAS_FLOAT 0 => secs_ret=ee_u32(整数) => time_in_secs() 整数除 => 14.1889s 变 14s
    => iterations/time = 4600/14 = 328.57 => 打印 328 (比规范值高 1.3%)
    规范值: 4600/14.1889 = **324.20** ; CoreMark/MHz 2.1613 本来就是全精度(=324.2/150), 不受影响。
    行动项: HAS_FLOAT 改 1 => 固件直接打印 324.20 (需重建镜像+bitstream+重烧 FLASH)。
    在此之前对外一律报 324.20 并注明固件打印 328 是截断。
2026-10-17 hw: 上板构建打印**规范口径** CoreMark 分数 (324.19), 不动 CoreMark 核心
    【背景】核心打的 "Iterations/Sec 328" 来自 HAS_FLOAT=0 的整数秒截断(4600/14), 比规范值虚高 1.3%。
    【为什么不改 HAS_FLOAT=1(已试, 链接失败)】ee_printf 的浮点 %f 路径要 newlib 的 fcvtbuf,
    而我们是 -nostdlib => undefined reference to `fcvtbuf`; 补手写 dtoa 要匹配 decpt/sign 语义,
    收益(仅显示值)不值风险。
    【做法(合规/无浮点/不影响仿真 ticks)】在**我们自己的** [portme] 打印块里(仅 #if CM_MIN_SECS_CHECK
    上板构建编译)用 64 位整数算规范分数: score = ITERATIONS*CLK/ticks。CoreMark 核心一行未改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
    [coremark.csv]
2026-10-17 docs(changelog): §13.4 行动项标记为已实现 —— 规范分数打印落地 (score=324.19 spec, CoreMark/MHz 2.1613)
    - HAS_FLOAT=1 路线链接失败(缺 newlib fcvtbuf) => 改走"64位整数 + 自己的 [portme] 打印"路线, CoreMark 核心未动
    - 实测: [portme] score=324.19 spec / ticks 2,128,330,453 / CoreMark/MHz 2.1613 / PASS 12
    - 对外口径: 分数 324.19(规范) 或 2.1613(CM/MHz); 引用核心的 328 必须注明"整数秒截断"
2026-10-17 hw: **FLASH 自启动验证 PASS** (合法 150MHz 最终镜像) —— 交付闭环完成
    断电重启(无 JTAG), 从 QSPI 自启动:
    [portme] rate gate: clk=150000000 Hz ticks=2128330453 secs=14 min10s=ok
    [portme] score=324.19 spec / CoreMark Size 666 / 14 s / 328 iter/s / 4600 iterations
    关键交叉验证: ticks 与 JTAG 烧写那次**完全相同**(2,128,330,453) => 自启动与烧写路径行为逐位一致 ✓
    FLASH 镜像 sha 650e7a7f…, 16MB 读回逐字节 VERIFY=PASS ✓
    方法教训: 上电输出一次性, 但 CH340 驱动 FIFO 会暂存 => "重启后才发现没监听"时立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
2026-10-17 docs(readme): P0-6 修掉最后的自相矛盾 —— 同一页里的 106.30/131.25/1,380,682,494 全部更新到实据
    docs-sync 审计指出 README 一页内并存 150MHz 与 106.30MHz(旧)、"目标 131.25 未收敛"(旧)、tick 1,380,682,494(105 档旧值)。
    按当前实测证据替换 7 处(每处断言恰命中 1 次):
    · 上板块: tick 2,128,330,453 / 14 s / clk=150000000 / [portme] score=324.19 spec / CM/MHz 2.1613 /
    与 JTAG 那次逐位相同 / QSPI 断电重启自启动(无 JTAG)
    · 派生脚注: 2.1613 / 3098 / 150.2
    · 资源行: LUT 3098 / FF 1447 (legal150-* 实测)
    · fmax 历史终点: 106.30 -> 150.2
    · "fmax 剩余空间"块: 106.30/131.25未收敛 -> 150.2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
2026-10-17 docs: 收尾 —— 新增 P0-4 设计报告 + README 上板口径统一到最终证据
    【新增 results/DESIGN-REPORT.md】比赛硬性提交物的主稿(9 节 / 489 行 / 约 5.1 万字符, 估算 35~42 页 Word):
    1 摘要 / 2 系统架构 / 3 微架构设计要点(含六次"墙转移"与负结果) / 4 PPA 与性能(fmax 演进+三口径分数)
    5 验证体系(PASS 12 + 三通道证据链) / 6 上板与固化(合法配方 + QSPI 自启动) / 7 对标 RVCoreP
    8 加分项(已完成/计划中严格分栏) / 9 附录
    数字全部带来源; 未做的(RTOS/IDE/功耗/PDS 实测)全部进"计划中", 不计入任何成绩。
    【README 收尾(3 处)】
    · 证据指针: uart_boot.capture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
    [coremark.csv]
2026-10-18 docs: 新增 RVCoreP 源码拜读指南 + 整理源码到 refs/RVCoreP/
    【背景】用户要求"保留 RVCoreP 源码、展现可阅读的代码、想拜读"。
    此前 RVCoreP 源码散落在工作区根的 .rvcorep_scratch(31MB, 含两个版本的 zip 与解压),
    现已整理为 refs/RVCoreP/ (v0.46 / v0.53 / 论文全文 txt, 拍平嵌套层, 删掉重复 zip)。
    【新增 results/rvcorep-reading-guide.md】
    - proc.v 的 module 地图(按行号): regfile L35 / IMEM L54,74 / DMEM L96,137 / BTB L180 / PHT L197 /
    ALU L225,265 / **RVCore L298-671** / decoder_id L672 / decoder_if L756 (共 783 行)
    - 5 步阅读顺序(config.vh -> 流水寄存器 -> 流水控制 -> 译码器 -> 板级/仿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
2026-11-02 Add Pango FPGA ports and PG2L100H vision project
    Add MES50HP/PDS compatibility sources, board reference demos, and PG2L100H camera/LCD debug tools.
    Add the Verilog RV32IM vision project with CPU/IMEM/DMEM at 125 MHz and NPU/camera/MMIO at 50 MHz.
    Include digit/gesture models, training/export tools, three-mode controls and hardware validation documentation.
    Record that COCO80 is not deployed and on-board PLL/application acceptance remains pending.
    Keep local toolchains, training environments and generated build outputs out of Git.
    Validation: fresh-checkout J11 project generation and source/model/firmware/project integrity check passed.
    [multiseed_summary.csv, wiring.csv]
2026-11-02 Archive CPU 50 MHz PG2L100H vision baseline
    Restore the standalone CPU/NPU 50 MHz source tree from the November 2, 2026 20:22 backup under releases/cpu50mhz.
    Preserve all 54 original build-input hashes, model exports, dependencies and historical build/download records.
    Add build instructions and restoration evidence while retaining the CPU125/NPU50 project.
    Validation: J11 project preparation and integrity check; Verilog-2005 compile; real RV32 numeric and gesture firmware simulation; Pango PLL board simulation.
    [wiring.csv]
2026-11-03 Fix PG2L100H CPU PLL lock at 125 MHz
    Use HIGH GPLL bandwidth for the 50 MHz CPU PLL phase detector.
    Add PLL bandwidth and SW2 reset/relock checks to the board simulation.
    Record successful native timing, JTAG lock, and user-confirmed camera preview.
    Document volatile RAM configuration and preserve the CPU 50 MHz archive.
2026-11-03 repo: 仓库整理（比赛提交前收口）——删除重复快照/临时文件、归档 legacy+pds、新增比赛向 README 与文档索引
    - 删除 releases/cpu50mhz/（384 文件/9.2MB 重复快照；内容保留在 commit f07836d）
    - 删除 _pds_probe/ 与 4 个编辑器/工具临时文件（~$.vsdx、*.pds.lock）
    - legacy/ -> archive/legacy/；fpga_pds/ -> archive/pds/
    - 新增：比赛向 README（PG2L100H 交付主体 + 仓库地图 + 提交物状态 + 口径边界）、README-ARTIX.md（原 README 完整保留）、docs/README.md、THIRD_PARTY.md、archive/README.md；.gitignore 增补临时文件规则
    - 不修改任何 RTL/构建脚本/Pango 工程路径；fpga_mes50hp/、ebf_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
    [multiseed_summary.csv, wiring.csv]
2026-11-03 docs(compliance): 全库合规性陈述优化 + 技术文档补全
    - 新增 COMPLIANCE.md（证据分级 A/B/C/D/E、禁用词、交付边界、器件合规）
    - 新增 docs/TECHNICAL-OVERVIEW.md / REPRODUCE.md / EVIDENCE.md / SUBMISSION-CHECKLIST.md / COMPLIANCE-AUDIT.md
    - 新增 tools/compliance_check.py（禁用词/缺级别数字/Artix 缺对比语境自动检查）
    - 全部 80 个 Markdown 文档加"范围/口径声明"横幅（交付主体/证据/对比/参考/归档/开发性质六类）
    - README 增加合规与证据入口/技术文档入口；README-ARTIX 加强 Artix 数字口径；tools/flash_logs/REPORT.md 加 Artix 声明并交叉引用 Pango Flash 未写入状态
    - 不修改任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
2026-11-03 docs(compliance): 审计表补入自身并修正文件计数（835），docs/README 增加合规/技术文档索引
    - docs/COMPLIANCE-AUDIT.md 逐文件表覆盖全部 835 文件（含审计表自身）
    - COMPLIANCE.md / README.md 计数由 828 修正为 835
    - docs/README.md 增加合规与证据文档入口
    - 仅文档改动，RTL/构建脚本不变
2026-11-03 docs(comments): 源码注释一致性修复 + 全量源文件注释审计
    - 修复: top_a100t.sv 交付档注释 128.125→150 MHz，并加[跨厂商对比]声明；core.sv 同样加声明
    - 修复: 验证矩阵计数口径（README/REPRODUCE/TECHNICAL-OVERVIEW PASS 16→12；build_sw/fpga_workflow 11→12；core_portme/portme 历史 11 项措辞）
    - 新增 docs/COMMENT-AUDIT.md：398 个源文件逐文件注释审查表 + 13 项修复记录 + 一致性口径表
    - 仅注释/文档改动，不改任何逻辑；历史/第三方副本(208 文件)保留原貌并声明不参与当前口径
2026-11-03 docs(comments): 第二轮注释/文档一致性修复——按独立审查意见收口
    - top_a100t.sv / daVinciPro.xdc 时钟注释统一为当前 150 MHz（21/7、6.667 ns；75/105/128.125/131.25 标为历史阶梯）
    - README-ARTIX 删除 105 MHz 时代残留数（2.2029/2.1728/22 vs 23 sv），改为历史注记
    - HANDOFF/CODE-MAP/FREQ-VERDICT/COMPETITION-PLAN 补'历史文档/历史记录'标注（105/128.125 MHz 已被 150 取代）
    - docs/TECHNICAL-OVERVIEW 修 cm_recipe.py 断链；docs/README & SUBMISSION-CHECKLIST 移除 main 上不存在的 STAGE-REVIEW 链接
    - 文件计数 835→836；重生成 docs/COMMENT-AUDIT（403 源文件、22 项修复）与 docs/COMPLIANCE-AUDIT（836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
2026-11-03 docs(comments): 第三轮补做第一轮遗漏的两处注释（build_sw/fpga_workflow），审计表同步
    - tools/build_sw.py: 全部 11 项 → 12 项 / PASS 11 → PASS 12
    - tools/fpga_workflow.py: 历史 PASS 11 措辞 → 当前 PASS 12/历史版本说明
    - docs/COMMENT-AUDIT.md: 补记两处修复（#23/#24）并更新对应状态
    - 仅注释/文档改动
2026-11-03 docs(links): 修复范围声明中的相对链接（嵌套目录下失效）
    - 将 70 个 Markdown 中的 COMPLIANCE.md / BOARD_VALIDATION.md / README.md 链接统一为 GitHub 绝对 URL
    - 起因：全库加范围声明后，相对链接在嵌套目录解析到错误路径（86 处断链）
    - 仅链接文本改动，内容与代码不变
2026-11-03 docs(links): 修复 sw/coremark/README.md 指向不存在文件的链接（EEMBC barebones 文档未随仓库分发）
2026-11-03 docs(final-review): 终审 HIGH/MED/LOW 收口——交付状态/时钟注释/历史时态/证据口径
    - DESIGN-REPORT §6.4/§8：更新为 PG2L100H 已迁移上板（CPU 125/NPU 50、LUT4469/FF3706/APM10/DRM64、摄像头预览、位流 sha），Artix 150MHz/324.19 明确为跨厂商对比，Pango CoreMark/Flash 标未入库/未写入
    - top_a100t.sv：21/1 推导改为 1050/7=150MHz、XDC 21/7；75MHz 推导标历史；头部 1050MHz 归为当前 VCO
    - CODE-MAP：XDC -divide_by 8/131.25 → 7/150；HANDOFF/HANDOFF-HW-LOOP/HANDOFF-WORKFLOW 正文时态收口（当前目标→历史目标）
    - FREQ-VERDICT 增历史横幅；mmio_subsys 75MHz 标历史
    - ACCEPTANCE/VALIDATION：CoreMark 改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
2026-11-03 docs(pango): 新增性能分析报告与代码规范（最终版 PG2L100H）
    - fpga_pg2l100h/vision/PERFORMANCE-ANALYSIS.md: CoreMark 流水线效率分析（基线 2.5578 CM/MHz、CPI~1.30、按 list/matrix/state/CRC 分相位停顿/误预测/乘法占用、OPT-1/OPT-2 仿真收益与 Artix OOC 时序否决、OPT-3 计划、ILA 可选流程）
    - fpga_pg2l100h/vision/CODE-STANDARDS.md: 模块化/注释完整性/时序约束规范（对应赛题技术实现与文档评分项）
    - docs/README.md 与 vision/README.md 增加入口
    - 仅文档新增/链接，不改 RTL
2026-11-03 docs(pango): 性能分析更新——OPT-3 乘法两级流水实测 +2.46% CM/MHz
    - OPT-3（部分积寄存→下一拍合并，2 拍 busy）: 390,958→381,562 cycles/iter, 2.5578→2.6208 CM/MHz, CRC 正确
    - sim/tb_muldiv.v 2560 条 RV32M 用例全 PASS
    - 以 Pango 125MHz 为准：OPT-3 作为推荐乘法优化；OPT-1/OPT-2 仅理论上限（需 PDS 复核，不作交付判据）
    - 仅更新分析报告，RTL 未改动
2026-11-03 docs(pango): 新增 CORE-COMPARISON.md —— BTB/分支预测器与 Artix 参照核详细对比
    - 结论：Pango 最终版 BTB 存在且生效（core.v:228-253 实例化；p2_pc/q_* 2 级流水；pc_src=pred_taken）
    - 参数完全一致：BTB 512 项/3-bit tag；PHT 8192×2bit gshare；GH=13；HIST_ALL_CTRL=1；更新门控相同
    - pred_* 置 0 是旧一级兼容口（Artix 同款），不是预测关闭
    - 实测：强制关闭方向预测后 CoreMark 周期 +17.2%、CM/MHz 2.5578→2.1823（CRC 仍正确）=> BTB 生效
    - 差异清单：sv2v 生成方式、预测/存储初始化写法、RAS/A/GEMM 默认即关、MMIO EXTERNAL_WAIT 握手；均不涉及 BTB 结构
    - 仅新增文档，不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
2026-11-04 Add dual_j11 FPGA build artifacts
    [multiseed_summary.csv, top_pg2l100h_vision_dmr.prt, top_pg2l100h_vision_prr.prt, wiring.csv]
2026-11-04 docs: 同步"当前烧录版本 = 95MHz 双发射" —— 新增 CURRENT-BUILD.md 并修正 6 处文档口径
    【为什么】队友确认板子上烧的是 95MHz 双发射版, 而文档全部写着 125MHz 单发射(位流 f179a403…),
    且 build/j11 目录已不在仓库(README 引用断链)。按实际构建产物逐项核对后同步。
    【新增 fpga_pg2l100h/vision/CURRENT-BUILD.md】当前烧录版本的单一事实来源:
    · 位流 build/dual_j11/.../top_pg2l100h_vision.sbit, sha256 51f5eda2…, 3,791,112 B, 11-04 11:41 生成
    · CPU 双发射(2-wide in-order): 双 IMEM(u_imem/u_imem1) + 双译码 + slot1 执行槽; 完整发射条件摘录
    · 时钟: CPU 95MHz (PLL 50→/2 PFD2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
2026-11-04 docs: 新增 results/NPU-CORE-COMPARISON.md —— 库内三个 NPU/加速器家族横向对比
    【内容】把仓库里同时存在的多个加速核摆在一起(全部来自 RTL 本体与实测文档):
    ① GEMM 加速器 gemm_accel.sv (220 行, 1 MAC/拍, LUT, 42.59× vs 软件) —— main
    ② 视觉 NPU vision_npu.v: 主 RTL 185 行(1 MAC/拍, 64K 权重, 1-bit 模型)
    vs build/dual_j11 快照 199 行(4 MAC/拍, 16K×4bank, 2-bit 模型) = **板上实际版本**
    ③ v0.7 卷积引擎 nn_conv_engine.sv (1,574 行, 128 MAC/拍 = 16 OC × 8 px) + 配套 3,400+ 行
    四代演进 v2b(1102)→v3(1402)→A5(1556)→A7a(1574), 全模型 1,290,062→1,167,368→1,049,089 拍
    【三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
2026-11-04 docs(npu): 全量盘点 3 家族/7 实体 —— 分级到 GOPS，修 README 的 1-lane/4-lane 口径错报
    新增 results/NPU-INVENTORY.md（取代 NPU-CORE-COMPARISON.md）与 tools/npu_inventory.py。
    核心结论：
    - 板上实际 = vision_npu 4-lane = 0.400 GOPS 峰值 / 0.356 有效 / 利用率 88.9%
    - 仓库最强 = nn_conv_engine 128 MAC = 31.29 GOPS 峰值 / 4.68~14.76 有效 / 利用率 14.9~47.2%
    - 两者差 78 倍，且一在 main（能演示）、一在 feat/ai-accel（从未上板），不可互换
    - gemm_accel 不是"第三个小 NPU"：已判失败（+916% FF / -13% fmax / C 读回错）并 GEMM_EN 移除
    周期数双路互证（推导 vs 仿真实测，差 = 0）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
2026-11-04 feat(nn): SV→Verilog 转换完成并仿真验证 PASS —— nn_core.v 可上板版本 + 58 cases mismatch=0
    【任务】按用户指示: 假设 DDR3 可用/不做上板/只做行为级仿真, 把 SV 的 NPU 核心转成可上板 Verilog。
    【方法】sv2v v0.0.13(Windows) 自动转换 + 3 处手工修补:
    ① nn_mem 的 string fname/line -> reg[8*512-1:0]/reg[8*4096-1:0] ($fopen/$fgets/$sscanf 接受定宽 reg)
    ② 补 `timescale 1ns/1ps (否则 xelab 报 nn_mem_default 缺 timescale)
    ③ TB 的 .desc(desc) -> .desc({>>{desc}}) (结构体流式拼成 211bit 总线)
    【产物】fpga_pg2l100h/vision/rtl/nn/
    nn_core.v 2,628 行纯 Verilog (nn_conv_engine + nn_mem), SV 特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
2026-11-04 test(nn): 补入 xsim 仿真日志 (xsim_pass.txt) —— 58 cases 全 PASS 的原始证据
    *.log 被 .gitignore 覆盖, 故以 .txt 入库。
    内容: 90 行 xsim 输出, 含 58 条 CASE 逐条结果 + SUMMARY/M1SUMMARY/SASUMMARY + ENGINE_TB: PASS。
2026-11-04 docs(model): 两个分拣交付包 5 模型盘点 —— 同一张网络，选 nuts 作主线
    新增 results/SORTING-MODEL-CHOICE.md + tools/det2m_cost.py（纯 Python 按源码结构
    逐层核算，参数对上官方 2,048,721，差 9 / 0.0004% 即结构验证通过）。
    - 5 个 ONNX 是 4 个权重、1 张网络：均 2,048,721 参数 / 78 op / 224x224->3x(56x56)
    => 选哪个在 FPGA 上算力、BRAM、帧率一分不差，"哪个最省资源"是伪命题
    - 2,272 MMAC = 板载 6 层 NPU（1.01 MMAC，实测 242,310 拍 @50MHz，MAC 占用 96.0%）
    的 2,251 倍；4-lane @50MHz 要 11.36 s/帧 => 0.09 fps，不可用
    - 开销 62% 在 FPN 头部：11 层 72ch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
2026-11-04 feat(nn): 完整 NPU 子系统 SV→Verilog 转换 + 4 套仿真全 PASS + 综合/时序验证
    【范围扩大到 9 个文件 -> nn_full.v 4,817 行纯 Verilog (7 模块)】
    nn_pkg(191) + rv32_pkg(463) + nn_rom_pkg(144) + nn_conv_engine(1574) + nn_mem(867)
    + nn_seq(540) + nn_wload(638) + nn_tilecache(503) + nn_subsys(672) = 5,592 行 SV
    输出模块: nn_conv_engine / nn_mem / nn_seq / nn_wload / nn_wload_afifo / nn_tilecache / nn_subsys
    修补同前(string x2 -> 定宽 reg, 补 timescale); 确认 (* ram_style="block" *) 被 sv2v 保留
    【四套仿真全部 PASS】
    tb_nn_engine : ENGINE_TB: PASS (58 cases, mismatch=0)
    tb_nn_tilecache : TILECACHE_TB: PASS (7/7 cases, 含慢速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
2026-11-04 docs(nn): rtl/nn 移植体检 —— 引擎可用，子系统还缺三样，紫光上还差两笔资源账
    逐条核过 3d50f04 的声明，结论分三层：
    L1 nn_conv_engine 可用：OC_LANES=16 x PX_LANES=8 = 128 MAC/拍；
    58 cases / 0 mismatch（47+9+2 与 xsim_pass.txt 尾行一致）；
    clk 8.182 ns = 122.220 MHz，WNS +1.108 / WHS +0.158，All met，50,528 端点；
    nn_full.v/nn_core.v 中 always_ff/typedef/logic[/.* 全为 0 => sv2v 转换干净，纯 Verilog
    L2 nn_subsys 还不能：rtl/ 下 grep nn_full|nn_subsys 零命中（vision_soc.v:136 仍是
    vision_npu）；nn_full.v 零 $readmemh（无任何真实模型权重）；内联微码 NN_ROM_LEN=112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
2026-11-04 feat(yolo): 新增 COCO-80 YOLO-Fastest v1.1 一键仿真包 (10 秒跑完 112-op ROM)
    【背景】用户要求: 专门针对这个 YOLO 模型做一个简单可用的仿真并推上 GitHub。
    【为什么不能做全模型 E2E】tb_sw.sv:787 明确记录: YOLO 全模型硬件推理在 50 MHz 仿真时钟下
    需要上亿拍, 仿真不可行。所以做"唯一能在合理时间内跑完整个 112-op 层序列"的仿真。
    【包内容】fpga_pg2l100h/vision/rtl/nn/yolo-sim/
    run_yolo_sim.ps1 一键脚本 (编译->elaborate->运行->判 PASS), 约 10 秒
    nn_full.v 被测 RTL: 7 模块纯 Verilog (sv2v 转换产物)
    nn_rom_pkg.sv YOLO 的 112-op 微码 ROM (NN_ROM_LEN=11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
2026-11-04 chore(yolo-sim): 清理 xsim 运行产物 + 加 .gitignore + 脚本自动清理
    上一提交误把 xsim 临时文件(wdb/log/jou/pb)一并入库, 本次移除:
    yolo_sim.wdb (72.5KB) / xvlog.log / xelab.log / webtalk*.log/jou / *.pb / xsim.jou
    并在 yolo-sim/.gitignore 里忽略这些产物; run_yolo_sim.ps1 运行结束后自动清理。
2026-11-04 fix(yolo-sim): 脚本自动清理失效修复 —— 运行后目录保持干净
    上一版补丁正则写错导致清理没生效 (运行后残留 10 个 xsim 产物)。
    本版重写 run_yolo_sim.ps1: 开头/结尾各调一次 Invoke-Cleanup,
    清除 *.log/*.jou/*.pb/*.wdb/*backup.* 与 xsim.dir/Xil/.Xil。
    验证: 运行 10 秒 PASS, 结束后残留 0 个临时文件。
2026-11-04 fix(yolo-sim): run_yolo_sim.ps1 改为纯 ASCII —— 修复 PowerShell 5.1 解析失败
    【根因】Windows PowerShell 5.1 在无 BOM 的 .ps1 上按 ANSI 读取, 中文注释被误解析
    => "Unexpected token '}'" 解析错误, 脚本根本没跑起来。
    【修复】脚本内注释/输出全部改英文(纯 ASCII), 符合仓库既有规则(R2: .bat/.ps1 保持 ASCII)。
    【验证】一键运行 10 秒完成:
    [legacy] PASS starts=112 cycles=336 done_ops=112 rom_len=112
    [band] PASS ops=112 bands=4242 pre=112 eng=4242 cycles=72114
    NN_SEQ_TB: PASS (legacy starts=112 cycles=336 | band ops=112 bands=4242 pre=112 eng=4242)
    >>> YOLO simulation PASS
    运行后临时文件残留 0 个(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
2026-11-04 test: 本机全量验证完成 —— 官方回归 PASS 12/12 + NPU 子系统 4 套仿真 PASS
    【1. 官方回归 (ModelSim, python tools/fpga_workflow.py verify --force -v)】
    PASS 12 / 12, 全部约 55 秒:
    tb_units 10.1s / tb_core_basic 3.2s / tb_core_trap 2.4s / tb_soc_timer_irq 3.6s
    tb_core_m_ext 2.4s / tb_core_amo 3.3s / tb_core_amo_diag 2.5s / tb_soc 2.5s
    tb_sw_lu_bench 3.3s / tb_sw_hello 2.5s / tb_sw_coremark 13.5s / tb_sw_nn_demo 6.3s
    另含前置检查: LSU 字节通道等价性 CHECK_EQUIV=PASS (675 万组穷举)
    完整日志: fpga_pg2l100h/vision/rtl/nn/regression_pass.txt
    【2. NPU 子系统 (Vivado xsim 2018.3, 转换后 Verilog)】
    tb_nn_engine : ENGINE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
2026-11-04 test(nn): Vivado 布局布线验证完成 —— 6.3 分钟收敛, 0 条未布线, 100MHz MET / 122.22MHz 差 0.075ns
    【任务】在 Vivado 上验证布局布线可行性 (Artix-7 XC7A100T 代理, OOC 对 128 MAC 引擎),
    超过 30 分钟即打断。
    【结果】6.3 分钟完成 (远低于 30 分钟上限):
    synth_design : 0 errors
    opt_design : 0 errors
    place_design : 0 errors
    route_design : 0 errors, Number of Unrouted Nets = 0, Partially Routed Nets = 0
    资源: Slice LUTs 30,987 (48.88%) | Slice Registers 19,758 (15.58%) | Block RAM 0 (引擎不含 mem)
    【时序 @122.22MHz (8.182ns) post-route】
    Setup: 5 failing endpoints, Worst Slack -0.075 ns, Total Violation -0.2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
2026-11-04 docs: 修正 NPU-SV2V-CONVERSION §7.3 时序口径 + 新增 §7.6 布局布线验证结果
    【问题】§7.3 原先把 synth-only 的 +1.108ns 当成时序结论, 会让人误以为 122.22MHz 已收敛。
    【修正】
    - §7.3 时序表拆成三行: synth-only +1.108 / post-route 实测 -0.075 / @100MHz post-route +1.743
    - 新增 §7.6 布局布线可行性验证: 6.3 分钟收敛, 0 条未布线, 资源 LUT 30,987(48.88%)/FF 19,758(15.58%),
    频率阶梯 100MHz(+1.743 MET) -> 110MHz(+0.834) -> 122.22MHz(-0.075 FAIL) -> 125MHz(-0.257),
    post-route 关键路径 8.257ns => 实际最高约 121MHz
    - 明确纠正: A7a 记录的 "OOC@122MHz +1.048ns MET" 是 synth-only 口径, 真正 p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
2026-11-04 chore(yolo): tools/yolo/data 加 gitignore —— 6.5MB 模型/权重/图片不入库
    data/ 下含 model_float.pt (2.8MB) + yolo-fastest-1.1.weights (1.35MB) + 6 张测试图 (2.3MB),
    体积大且可由 tools/yolo/ 的转换脚本重新生成, 按仓库既有惯例不入库。
    注: YOLO 的 Python 转换工具链本身在 feat/ai-accel 分支, 尚未合入 main。
2026-11-04 chore: 规范化 docs/figures/draw_report_figures.py 行尾 (纯 CRLF 差异)
2026-11-04 chore: 父仓库忽略 submission/ (它是独立开源仓库)
2026-11-04 docs(figures): 更新两张设计图 (fig1 设计流程 / fig2 硬件架构)
    误提交说明: 上一提交 a26145d 的 message 写成了"明确本版本不含 DDR3", 实际内容是本目录
    两张设计图及其生成脚本的更新。此处仅修正提交说明, 不改内容。
    （"本版本不含 DDR3" 的正式声明已正确提交到 submission/ 独立仓库: 72efb49）
2026-11-04 Publish final PG2L100H CoreMark gesture cap sorter
    [coremark.csv, ila_done.csv, ila_pipeline.csv, multiseed_summary.csv, sweep_results.csv, wiring.csv]
